pauloalcobia/mcHF_rev_0_8/docs/logic_pcb_mod.jpg

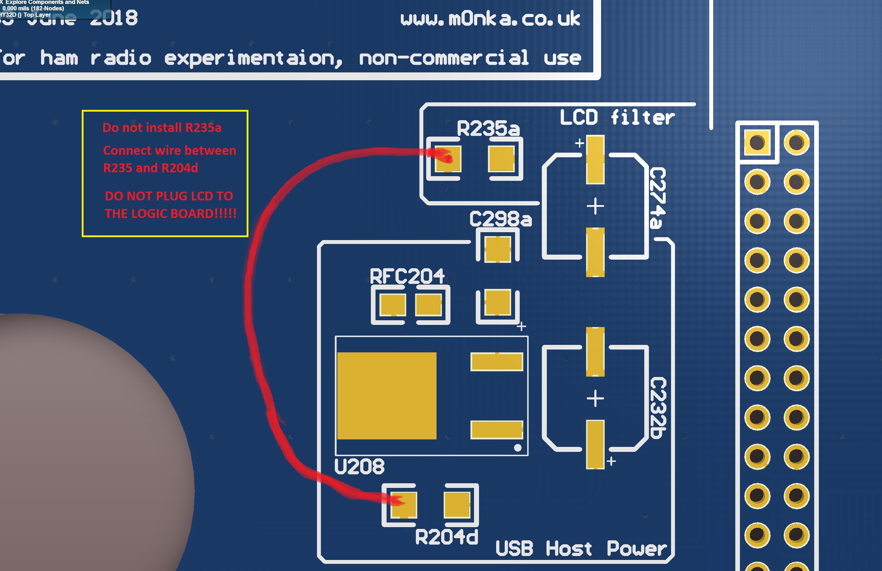
docs/logic_pcb_mod.jpg
