pauloalcobia/mcHF_rev_0_8/pcb/README.md

The 04 June 2018 PCB is second beta revision, so it is still not the final draft. Few things
on the HW side leftover to be tested and finalized, but it is getting closer.

73!
