pauloalcobia/mcHF_rev_0_8/sch/README.md

The 04 June 2018 PCB correspond to schematics from 13 June 2018. Although the
schematics and PCB is marked 0.8, it is basically a replacement UI board for revision
0.7. It is fully electrically and mechanically compatible. The main reason behind this
move is to save on R&D costs. As adding more components and moving to more 
expensive ones at that is getting more and more challenging with our limited budget.

73!
