pauloalcobia/mcHF_rev_0_8/firmware/dsp/README.md

The current firmware in the DSP chip on the Logic board is based on 219.22
release from Clint.
