pauloalcobia/mcHF_rev_0_8/pcb/back.png

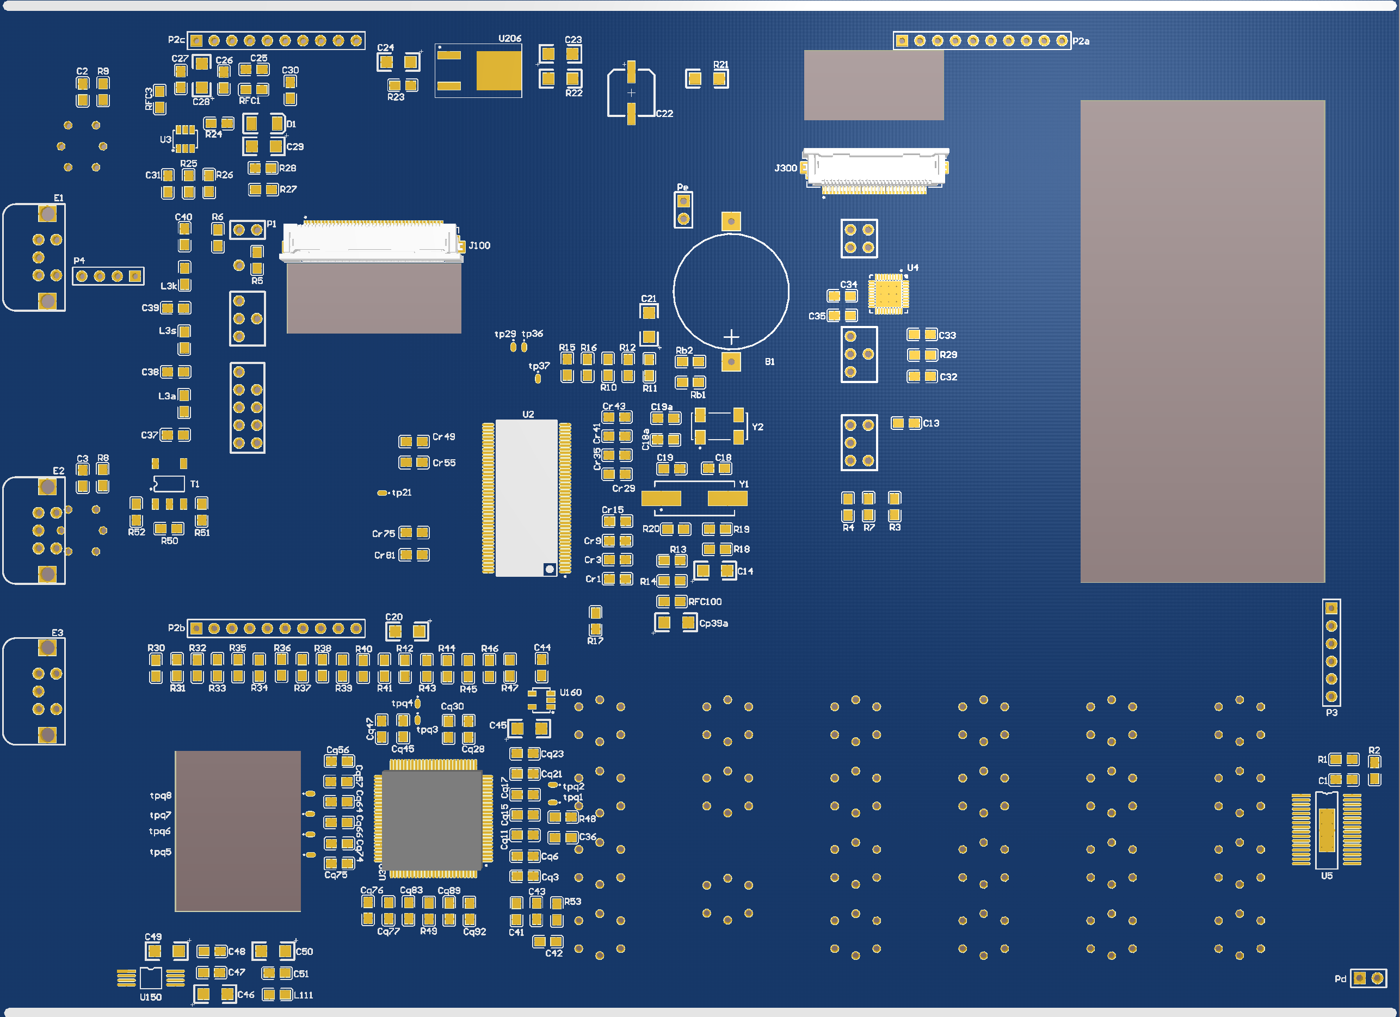
pcb/back.png
