pauloalcobia/mcHF_rev_0_8/pcb/front.png

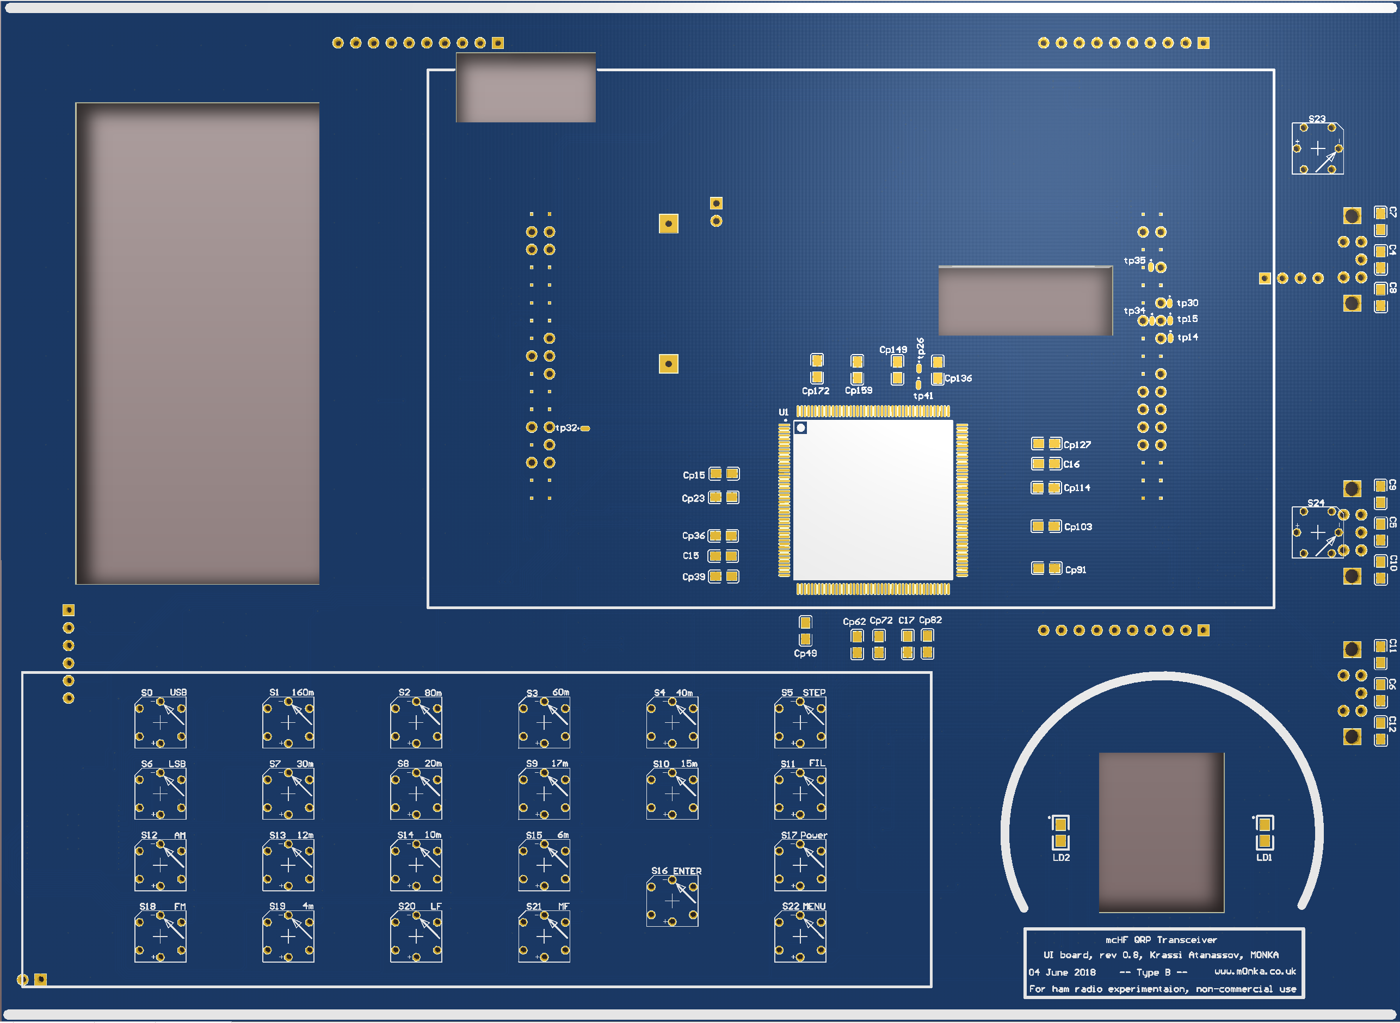
pcb/front.png
