pauloalcobia/mcHF_rev_0_8/sch/mcHFx_ui_b.pdf

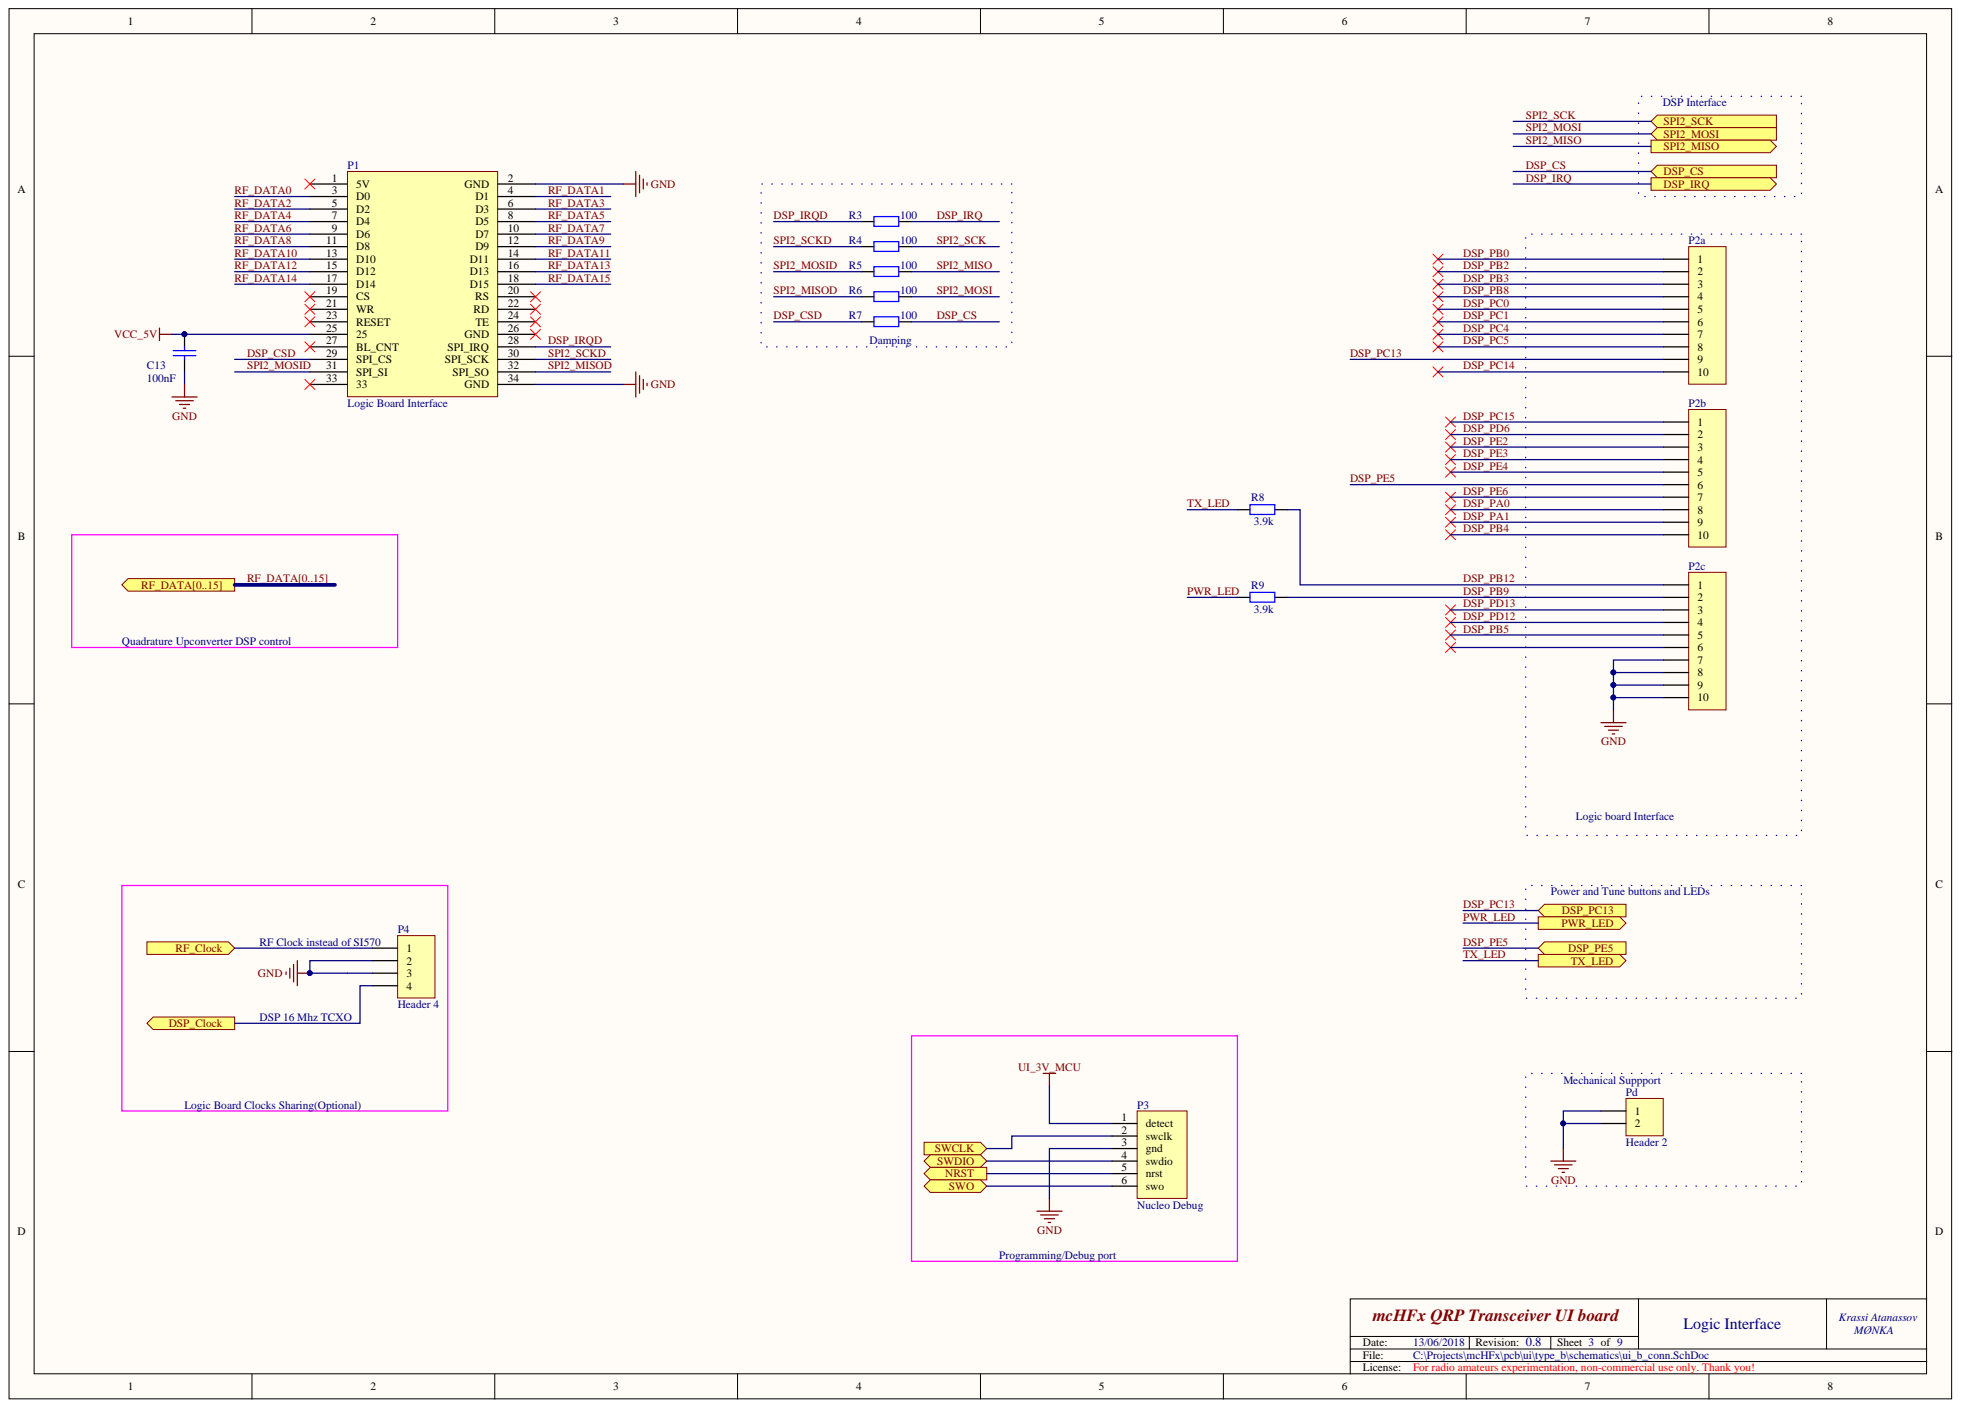
[picture p4: page 1]

Quadrature Upconverter DSP control

Power and Tune buttons and LEDs

RF Clock instead of SI570

Logic Board Clocks Sharing(Optional)

gnd 3

nrst 5

mcHFx QRP Transceiver UI board | Logic Interface | Krassi Atanassov MØNKA

Date: 13/06/2018 | Revision: 0.8 | Sheet of

File:
License: For radio amateurs experimentation, non-commercial use only. Thank you!

C:\Projects\mcHFx\pcb\ui\type_b\schematics\ui_b_conn.SchDoc

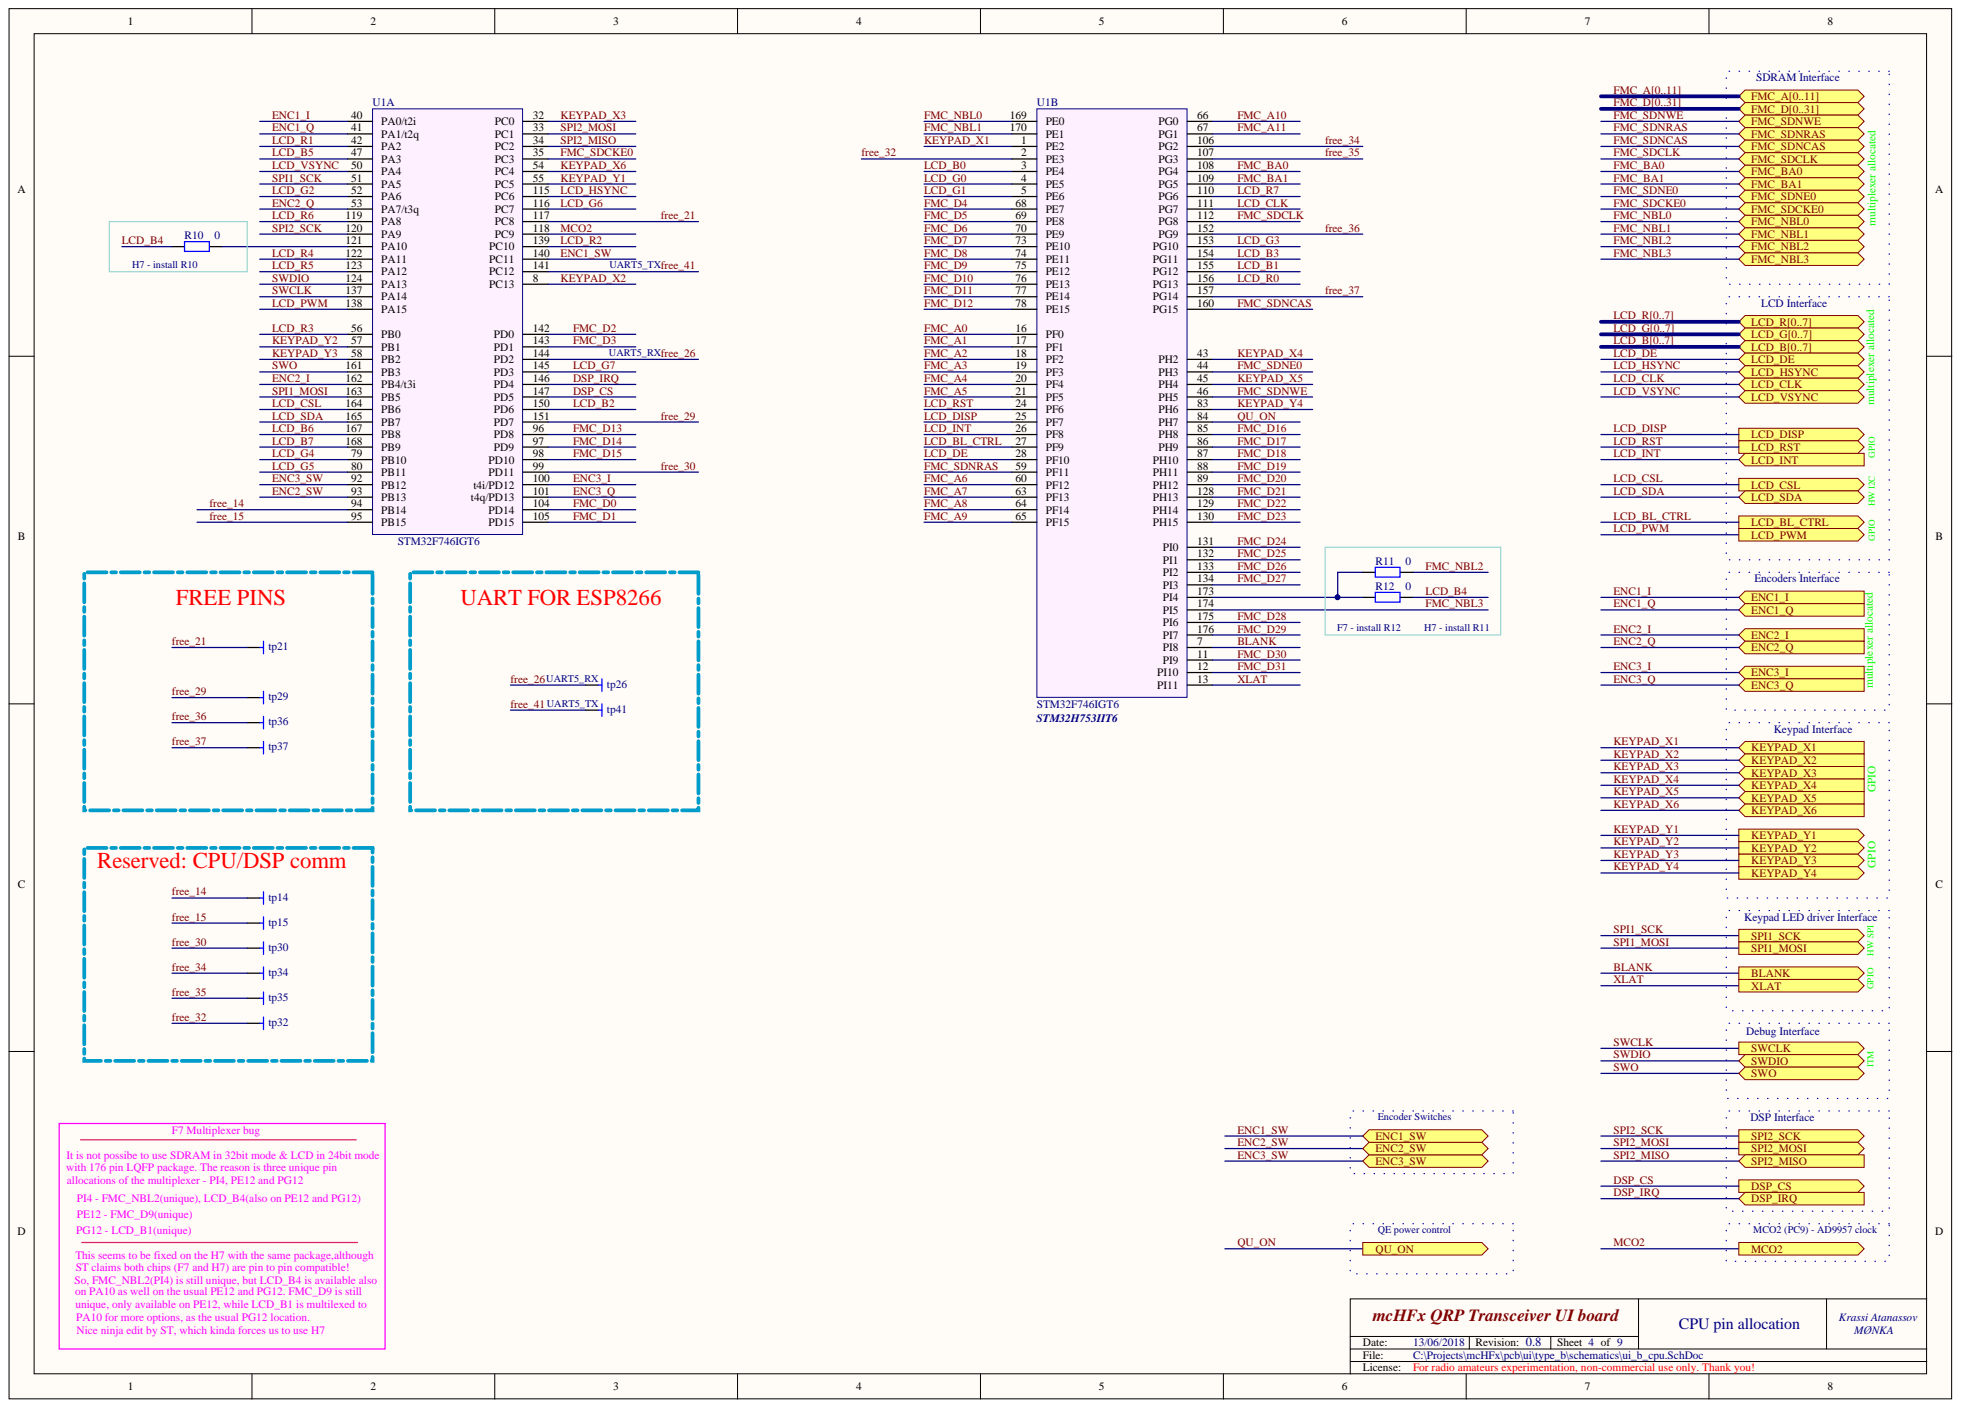
[picture p5: page 2]

multiplexer allocated GPIO multiplexer allocated multiplexer allocated

Reserved: CPU/DSP co

It is not pos
with 176 pin LQFP package. The reason is three unique pin
allocations of the multiplexer - PI4, PE12 and PG12
PI4 - FMC_NBL2(unique), LCD_B4(also on PE12 and PG12)
PE12 - FMC_D9(unique)
PG12 - LCD_B1(unique) This seems to be fixed on the H7 with the same package,although

sibe to use SDRAM in 32bit mode & LCD in 24bit mode

o on PA10 as well on the usual PE12 and PG12. FMC_D9 is still

ST claims both chips (F7 and H7) are pin to pin compatible!
So, FMC_NBL2(PI4) is still unique, but LCD_B4 is available als

unique, only available on PE12, while LCD_B1 is multilexed to
PA10 for more options, as the usual PG12 location.
Nice ninja edit by ST, which kinda forces us to use H7

C:\Projects\mcHFx\pcb\ui\type_b\schematics\ui_b_cpu.SchDoc

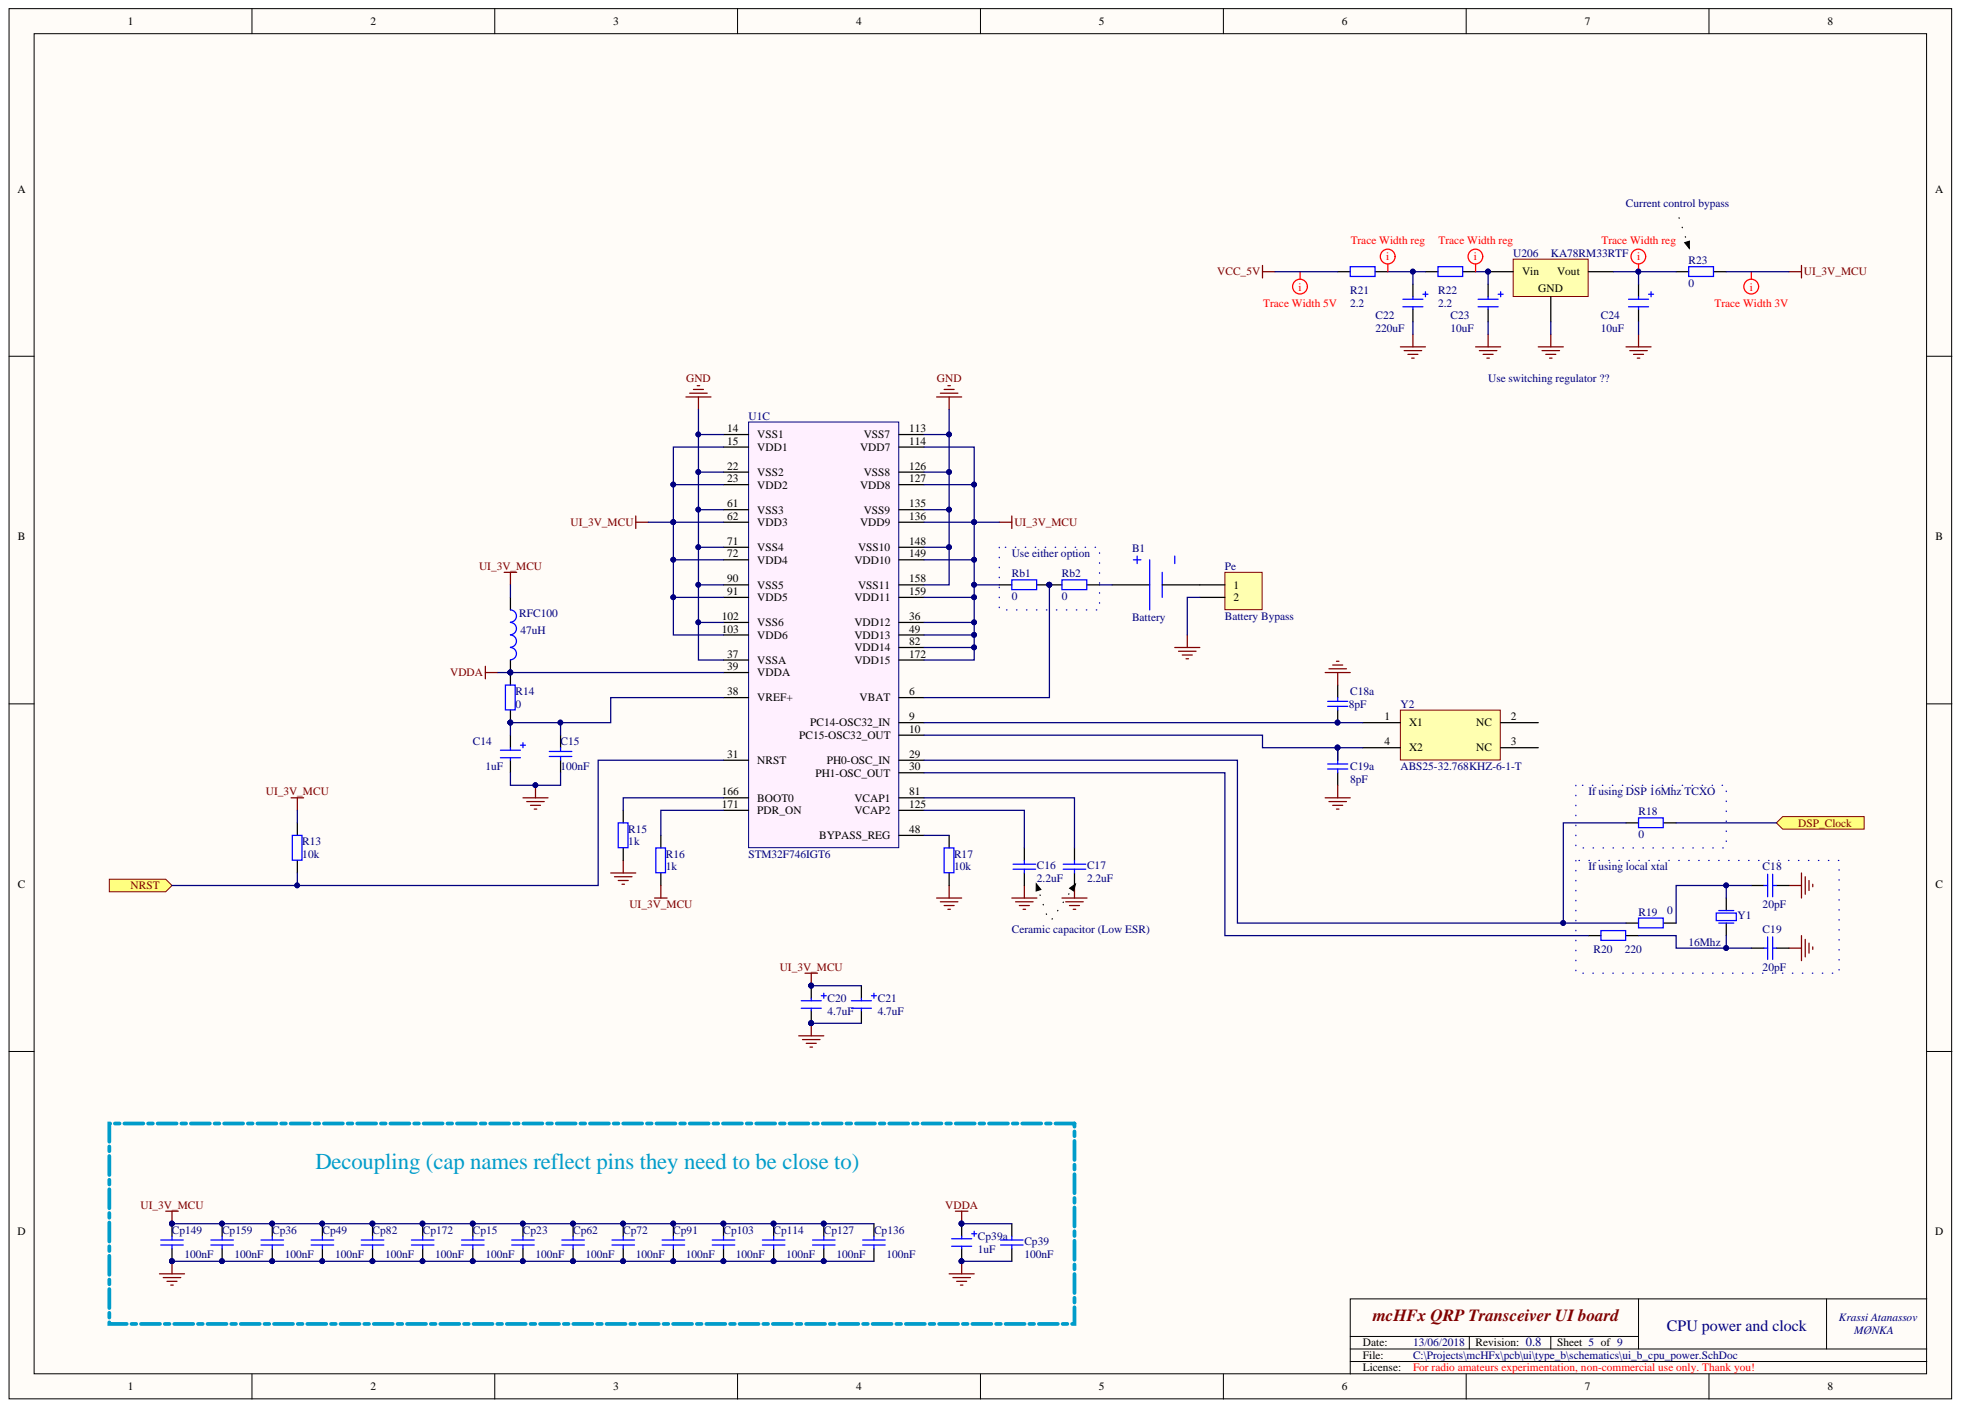
[picture p6: page 3]

VDD1 15

VSS2 22

VSS3 61
VDD3 62

VSS4 71

VSS5 90
VDD5 91 | | 0 | 0

VSS6 102
VDD6 103

VSSA 37

VREF+ 38

BOOT0 166 | C19a ABS25-32.768KHZ-6-1-T

If using DSP 16Mhz TCXO

If using local xtal

Ceramic capacitor (Low ESR)

16Mhz

Decoupling (cap names reflect pins they need to be close to)

CPU power and clock 5

C:\Projects\mcHFx\pcb\ui\type_b\schematics\ui_b_cpu_power.SchDoc

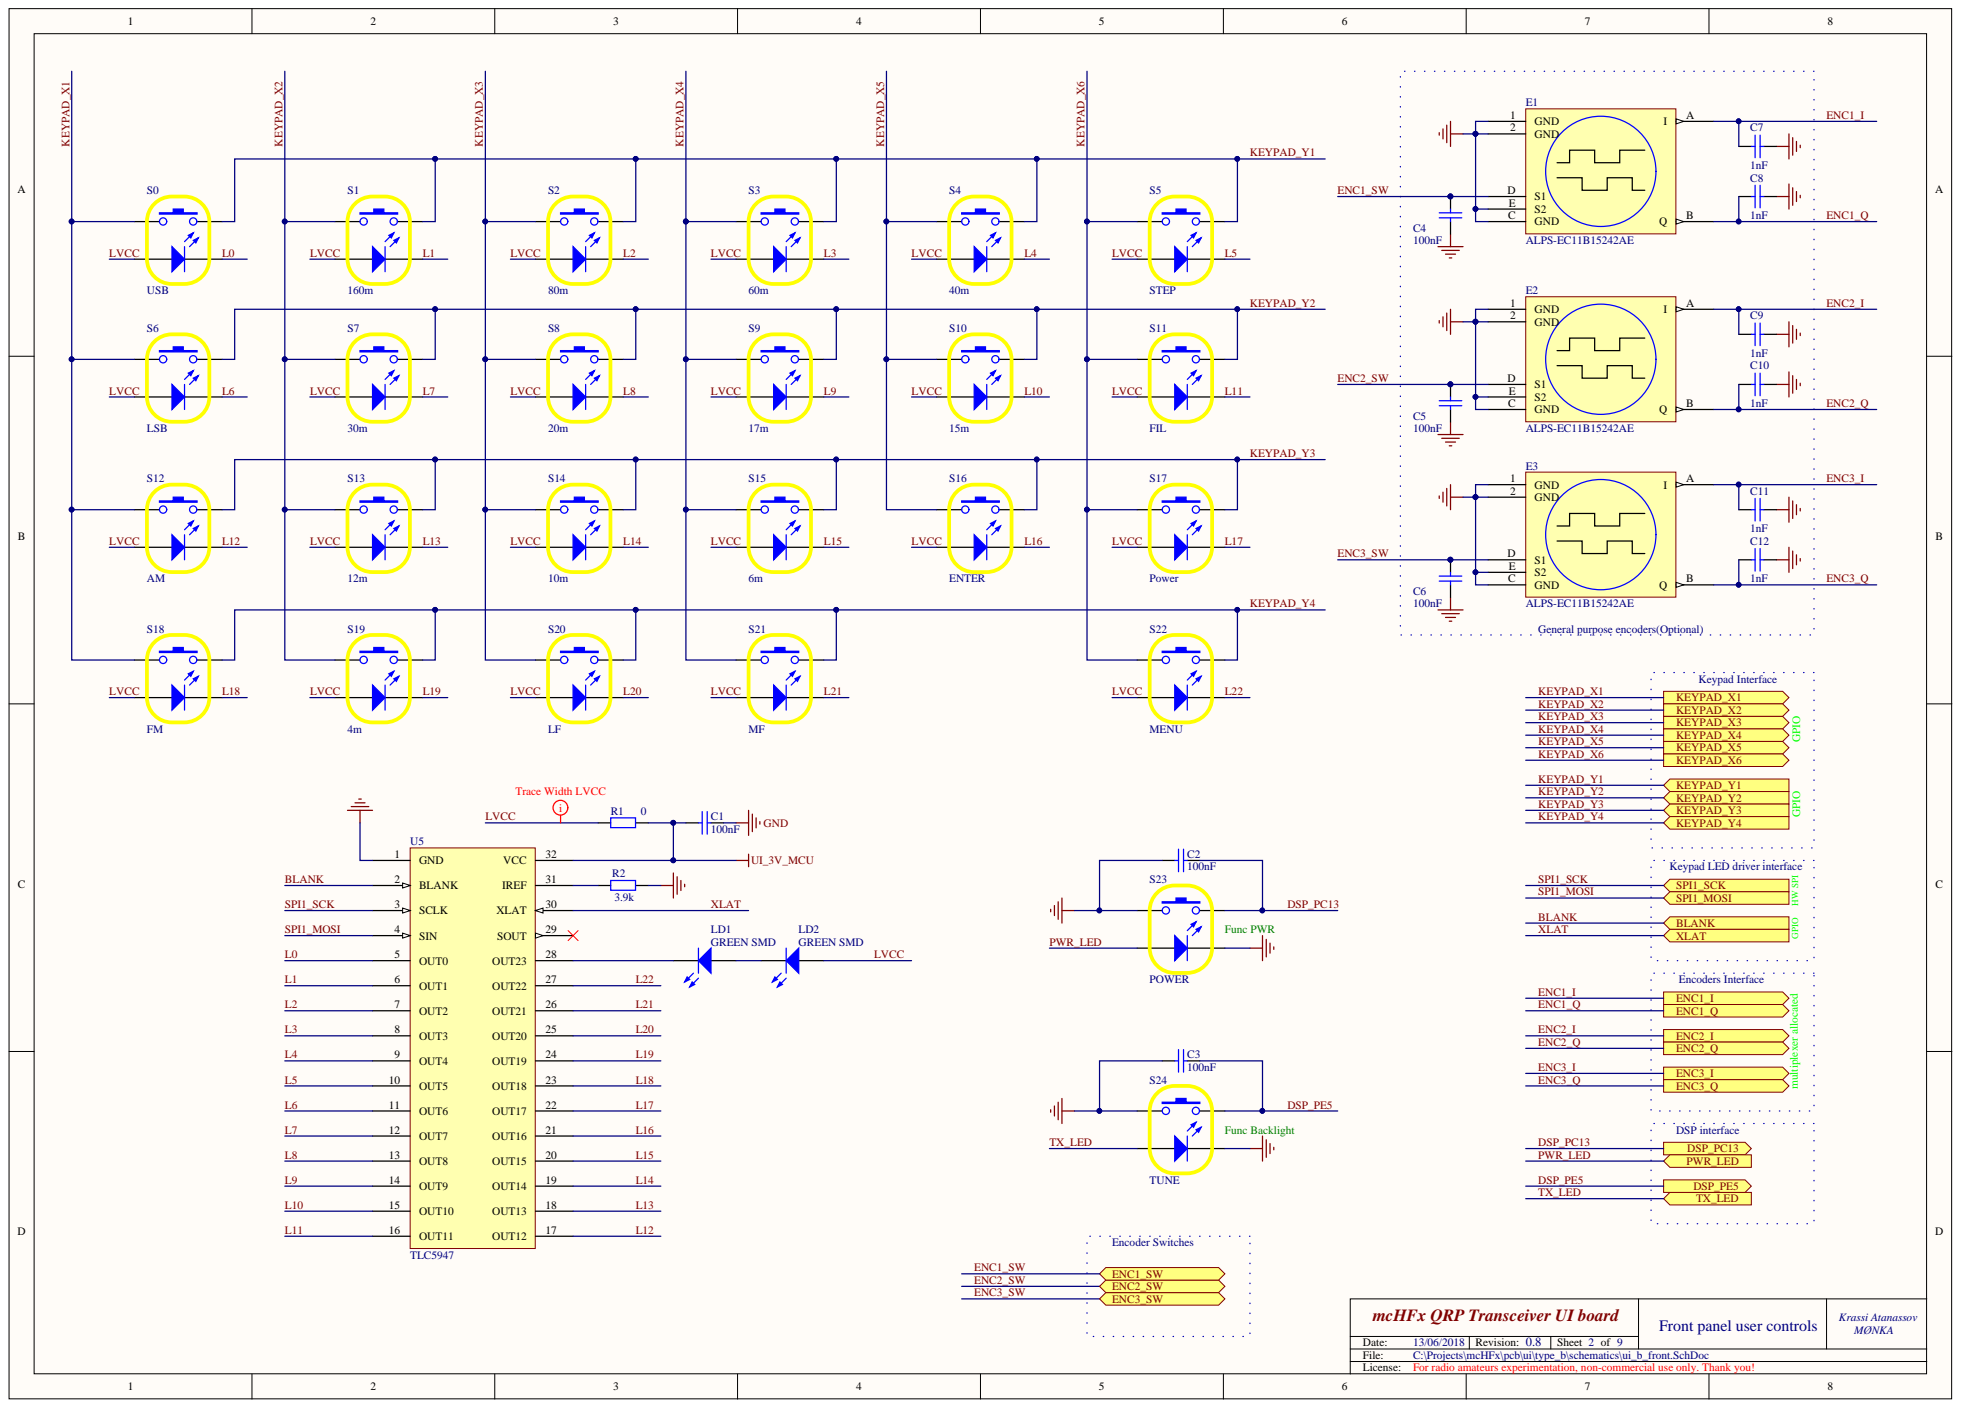
[picture p7: page 4]

General purpose encoders(Optional)

Front panel user controls 2

C:\Projects\mcHFx\pcb\ui\type_b\schematics\ui_b_front.SchDoc

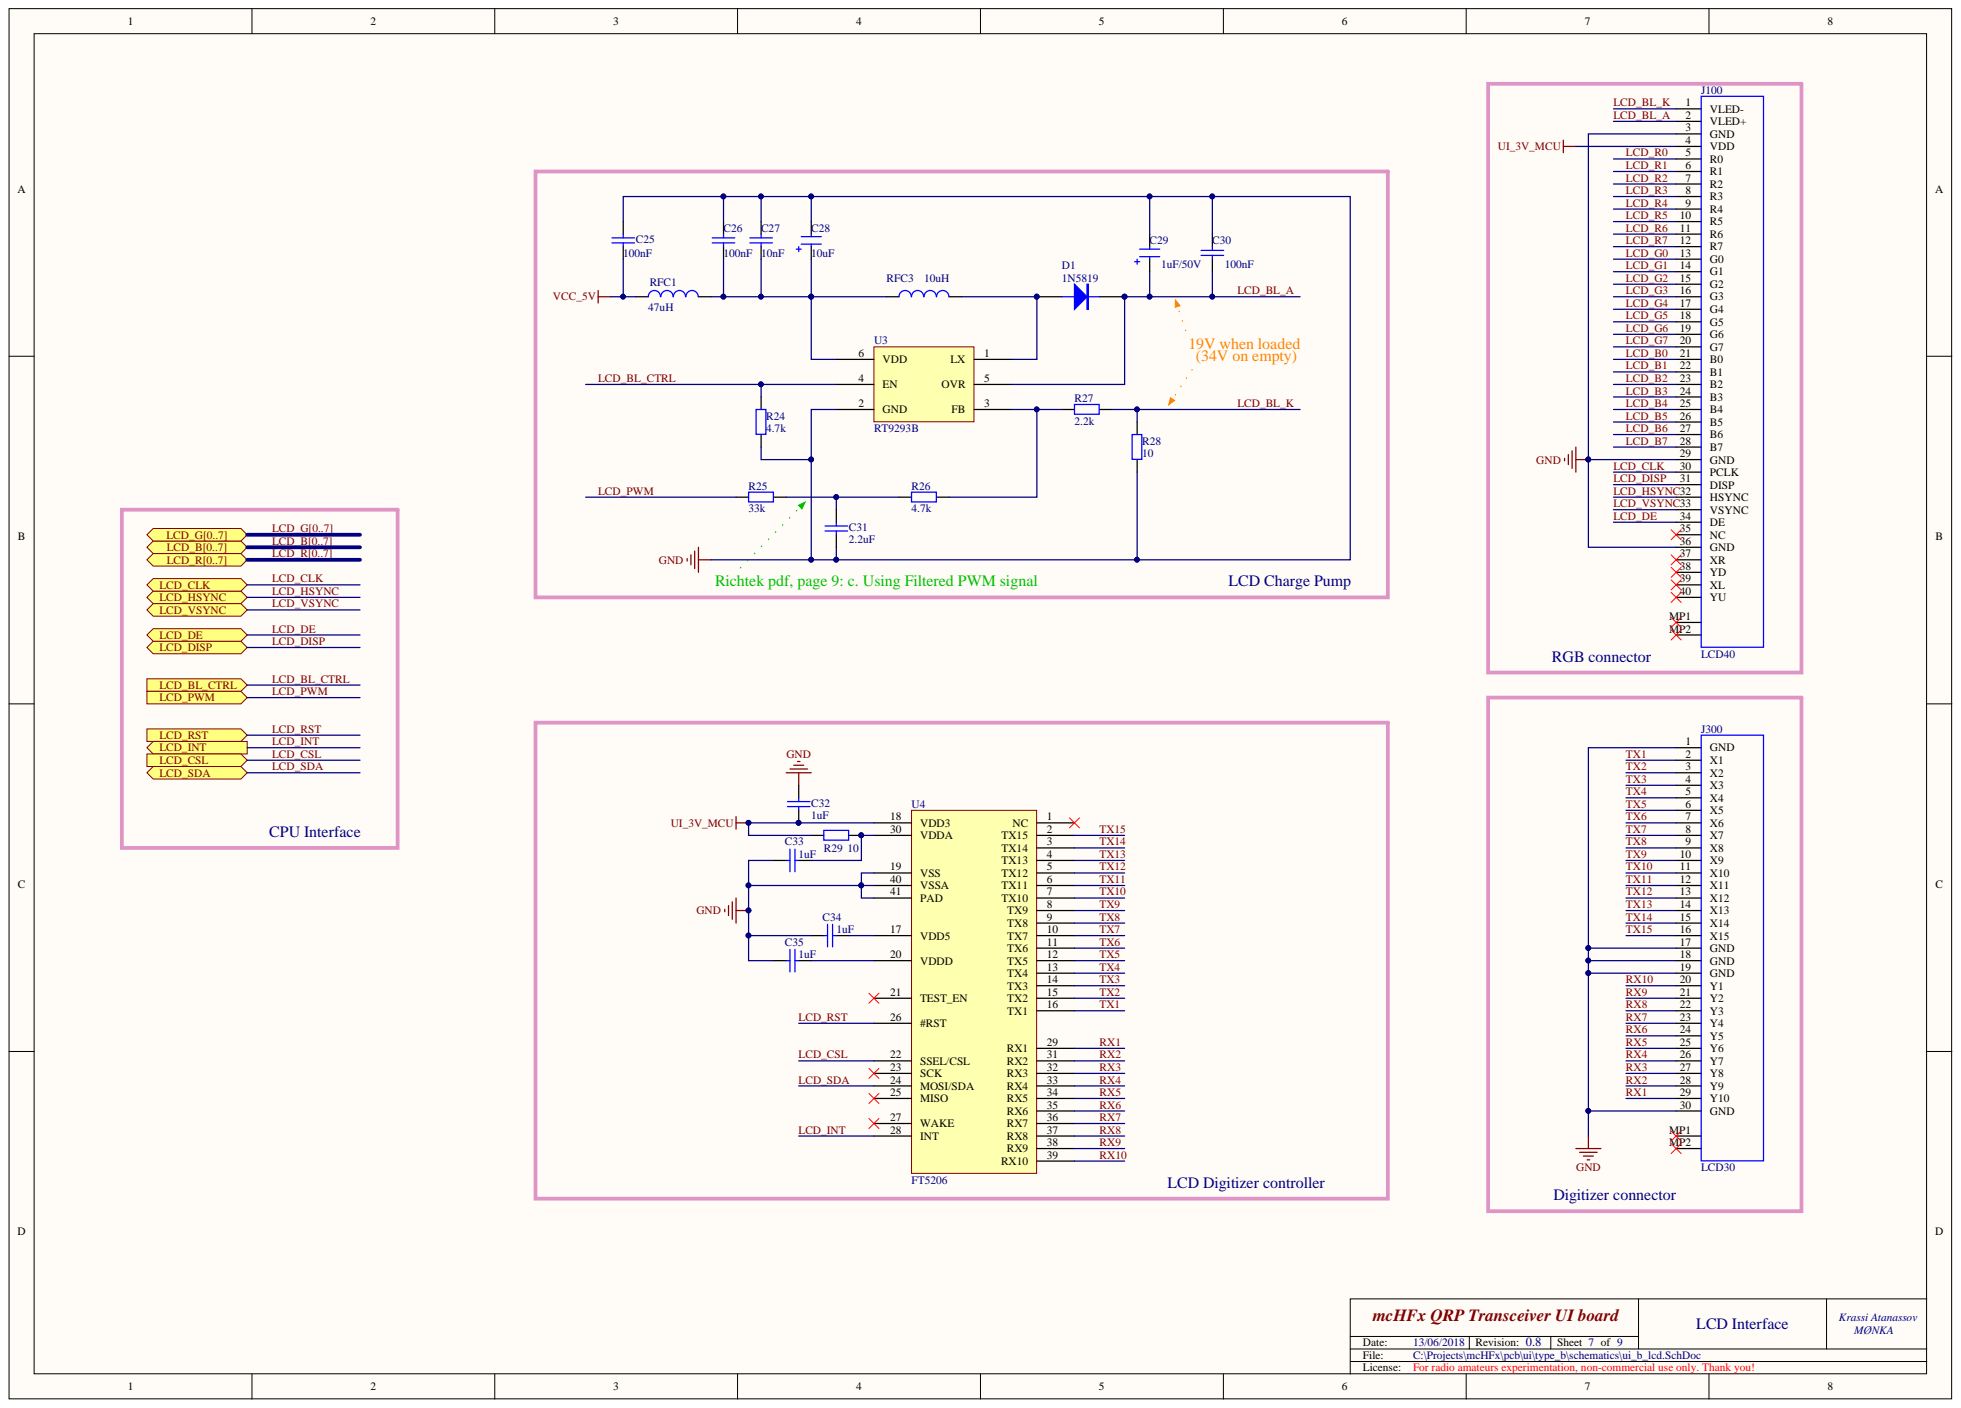
[picture p8: page 5]

LCD_HSYNC LCD_VSYNC LCD_CLK LCD_DE LCD_DISP LCD_B0 LCD_G0 LCD_R0 LCD_R1 LCD_R2 LCD_R3 LCD_R4 LCD_R5 LCD_R6 LCD_R7 LCD_G1 LCD_G2 LCD_G3 LCD_G4 LCD_G5 LCD_G6 LCD_G7 LCD_B1 LCD_B2 LCD_B3 LCD_B4 LCD_B5 LCD_B6 LCD_B7 | 5 6 7 8 9 | R5 10 R6 11 R7 12 G0 13 G1 14 G2 15 G3 16 G4 17 G5 18 G6 19 G7 20 B0 21 B1 22 B2 23 B3 24 B4 25 B5 26 B6 27 B7 28 GND 29

DISP 31 HSYNC 32 VSYNC 33 DE 34 NC 35

Richtek pdf, page 9: c. Using Fi

VDDA 30 | 2
VSS 19 | 3

PAD 41 | TX15 TX14 TX13 TX12 TX11 TX10 TX9 TX8 TX7 TX6 TX5 TX4 TX3 TX2 TX1 7

VSSA 40 | 6

VDD5 17 | 8

C:\Projects\mcHFx\pcb\ui\type_b\schematics\ui_b_lcd.SchDoc

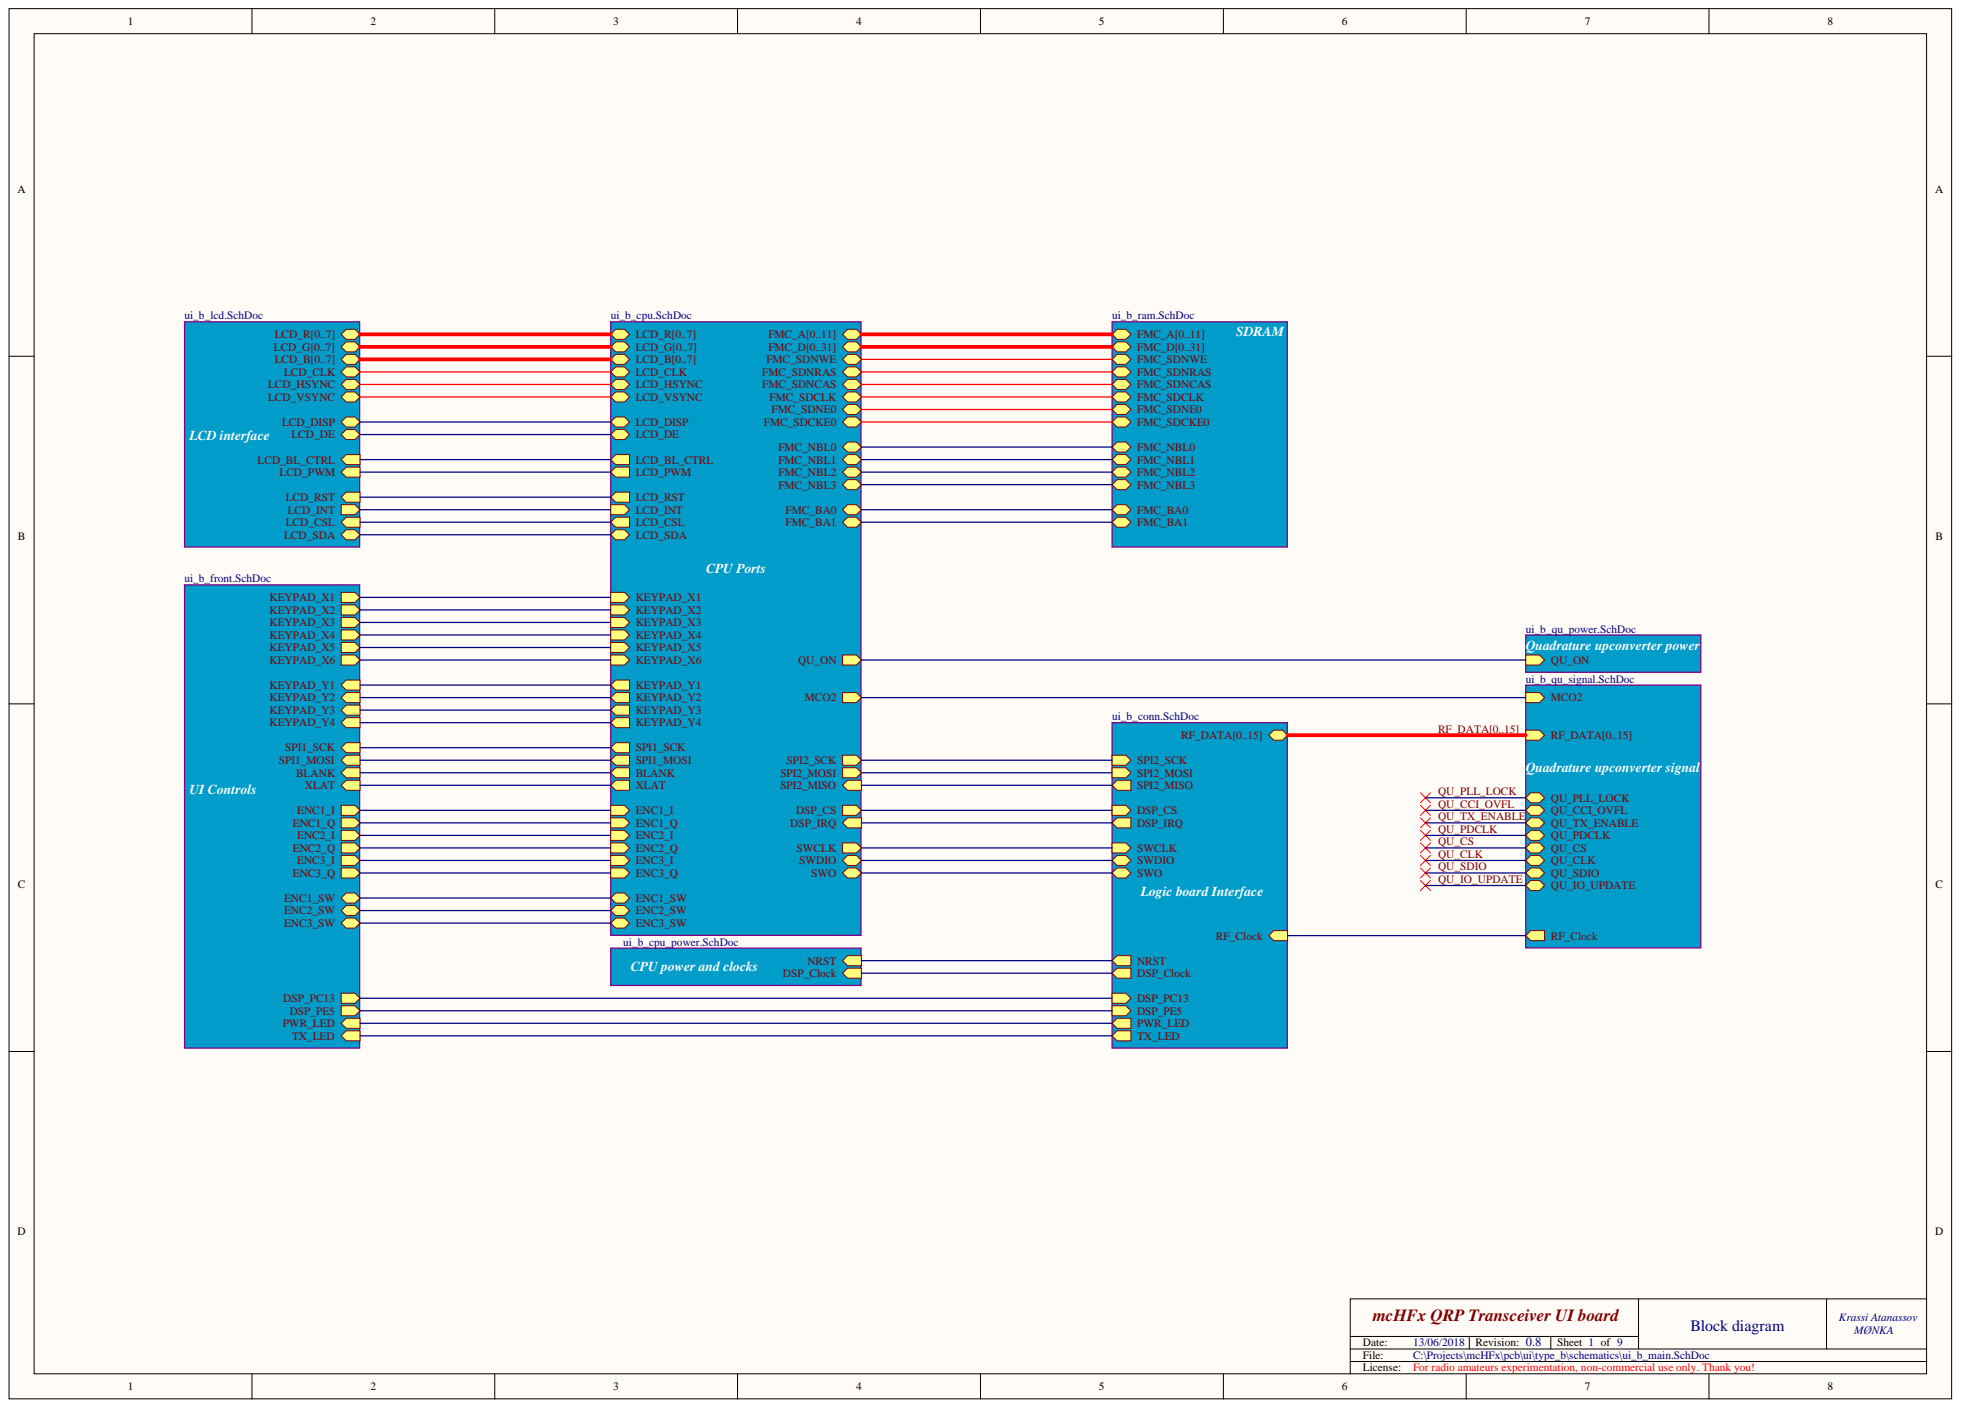
[picture p9: page 6]

DSP_Clock CPU power and clocks

C:\Projects\mcHFx\pcb\ui\type_b\schematics\ui_b_main.SchDoc

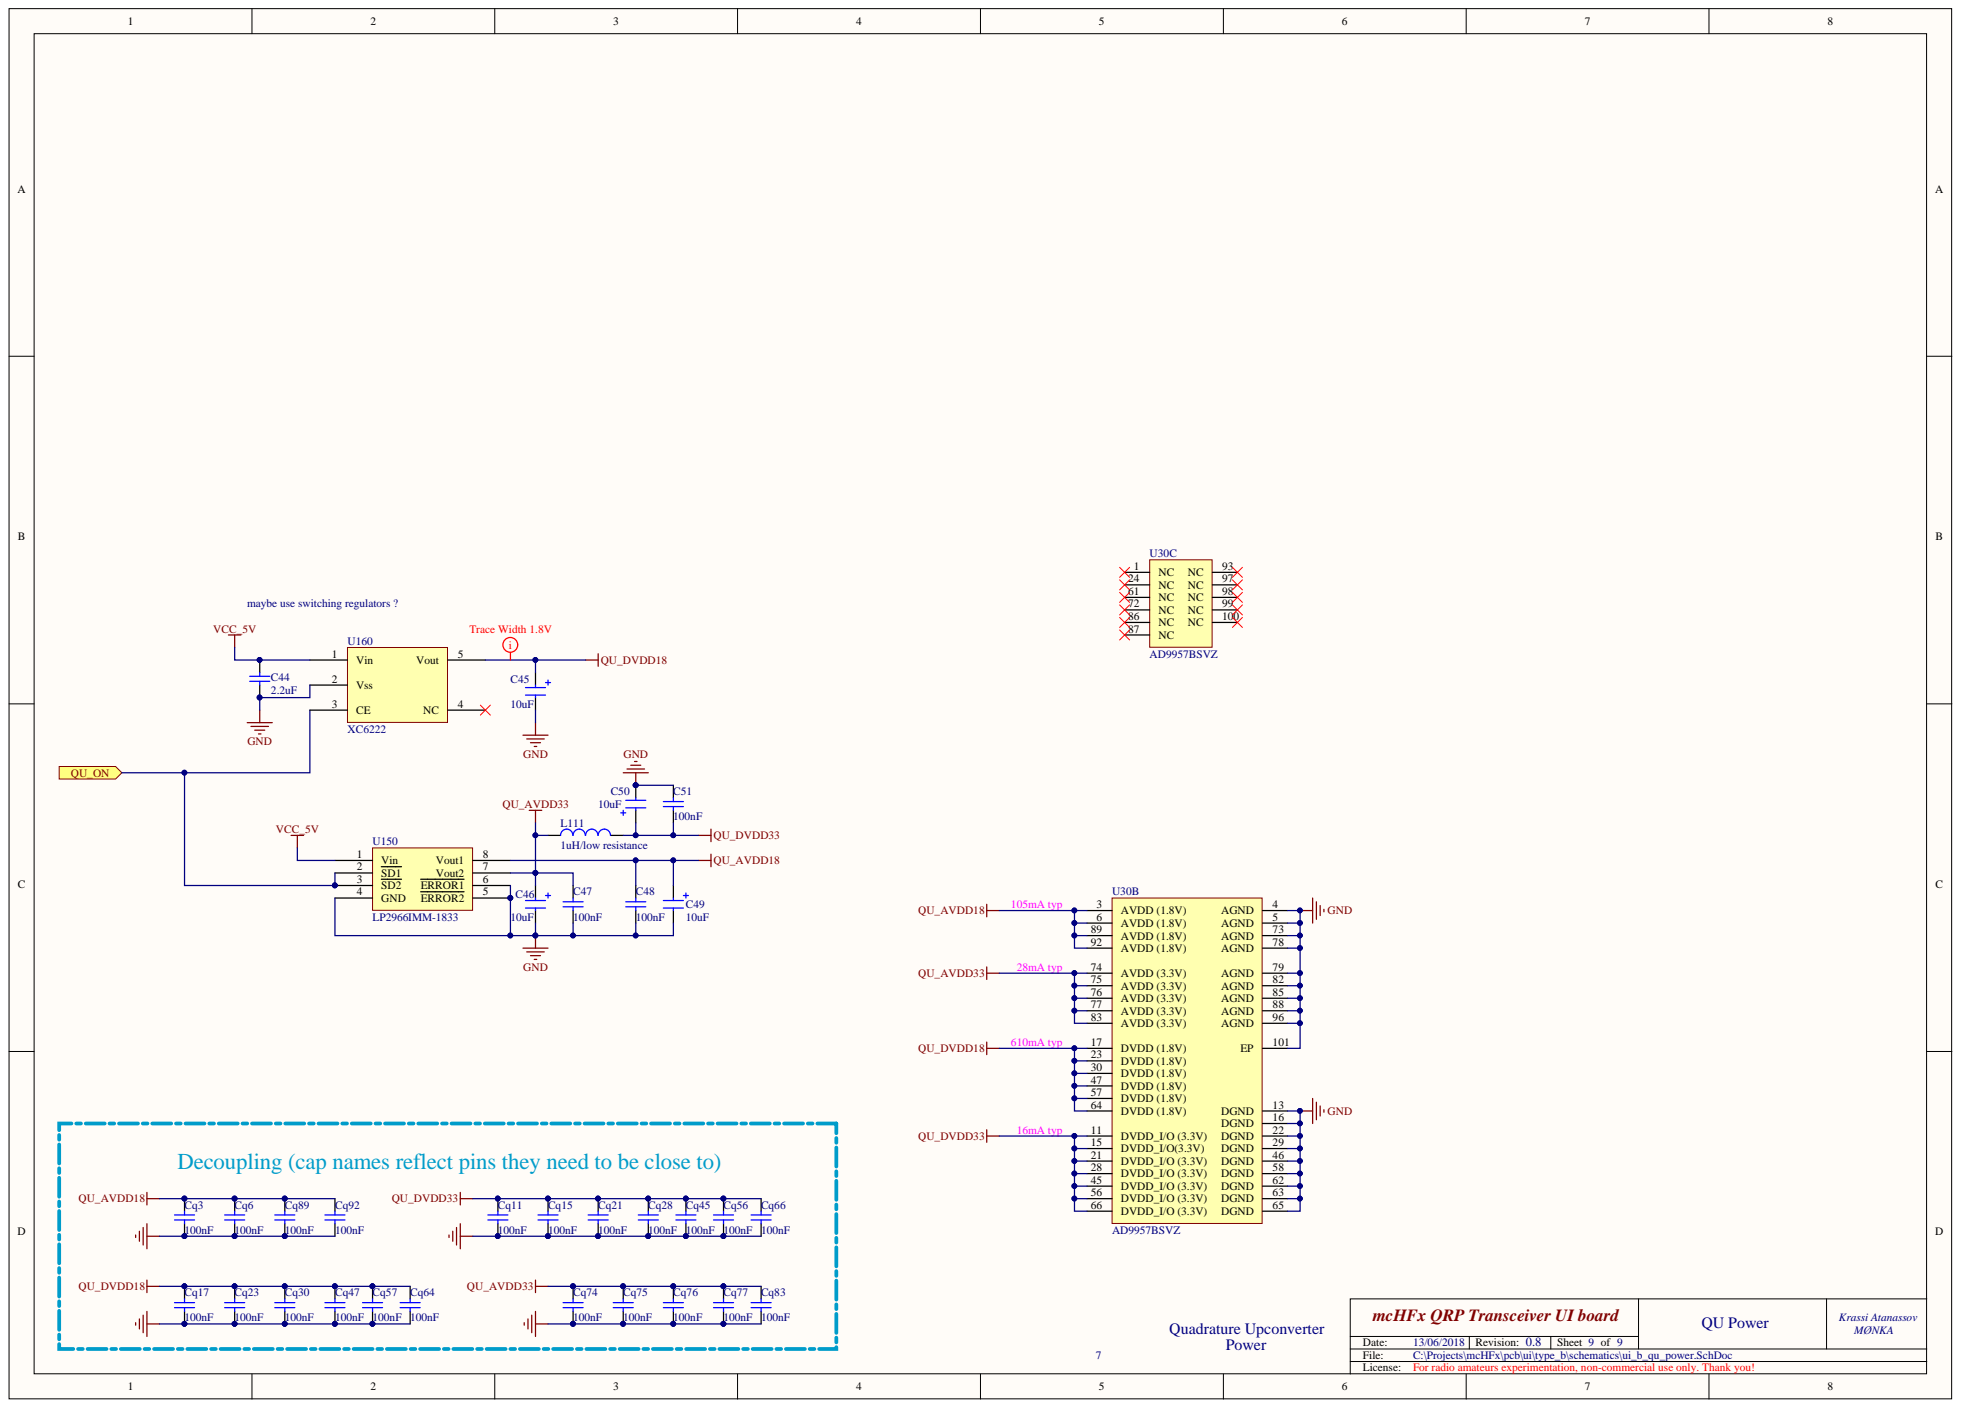
[picture p10: page 7]

maybe use switching regulators ?

Vss 2

Decoupling (cap names reflect pins they need to be close to)

QU Power

C:\Projects\mcHFx\pcb\ui\type_b\schematics\ui_b_qu_power.SchDoc

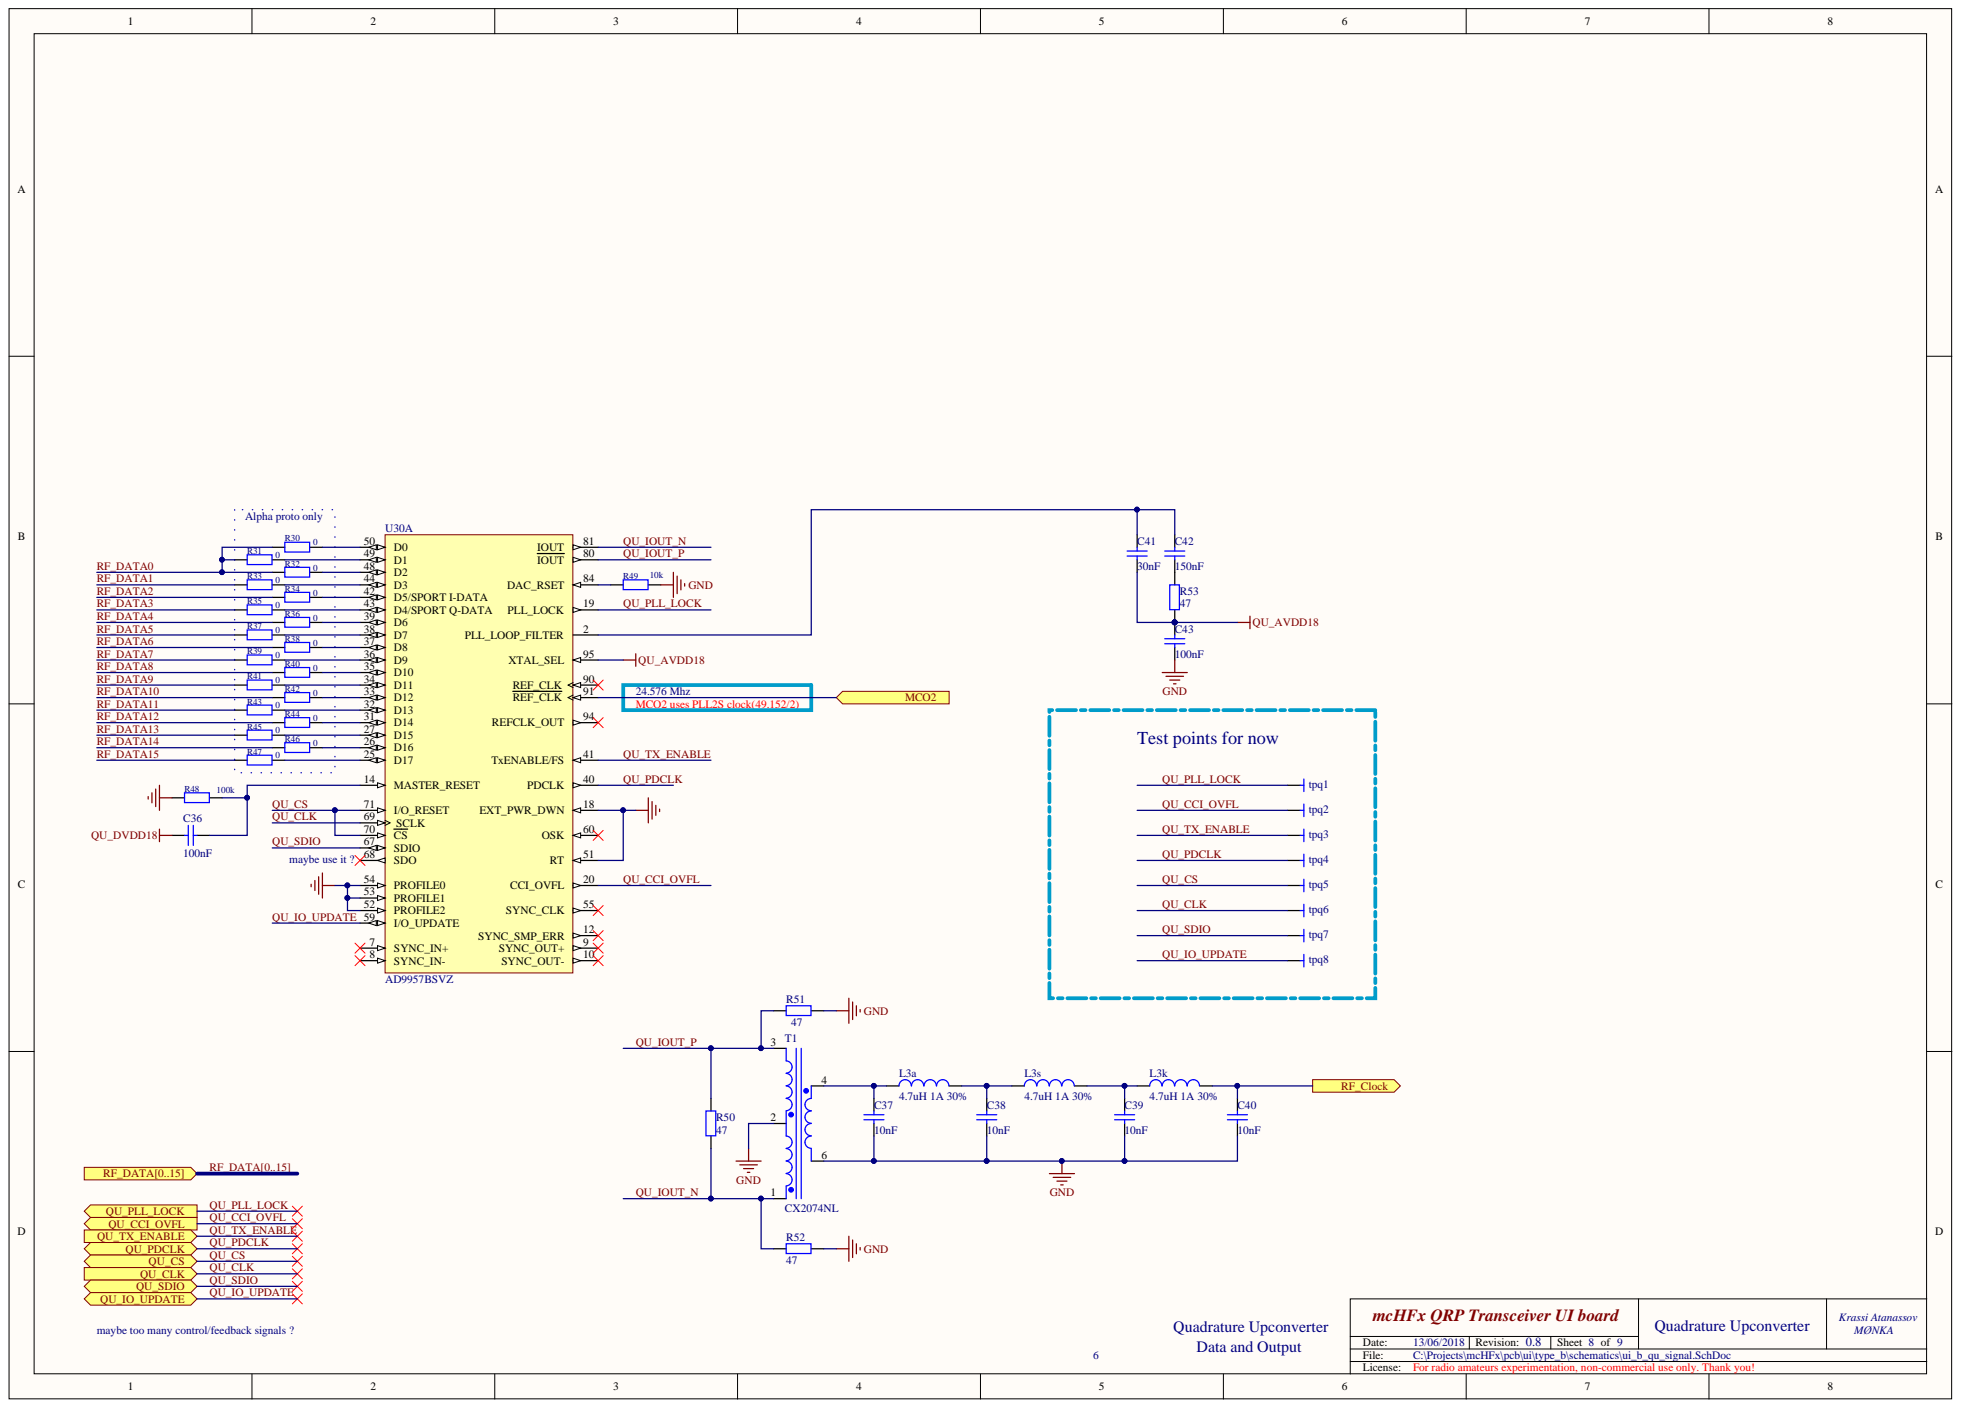
[picture p11: page 8]

Test points for now

MASTER_RESET 14 | QU_PDCLK

I/O_RESET 71 | QU_CCI_OVFL

maybe too many control/feedback signals ?

C:\Projects\mcHFx\pcb\ui\type_b\schematics\ui_b_qu_signal.SchDoc

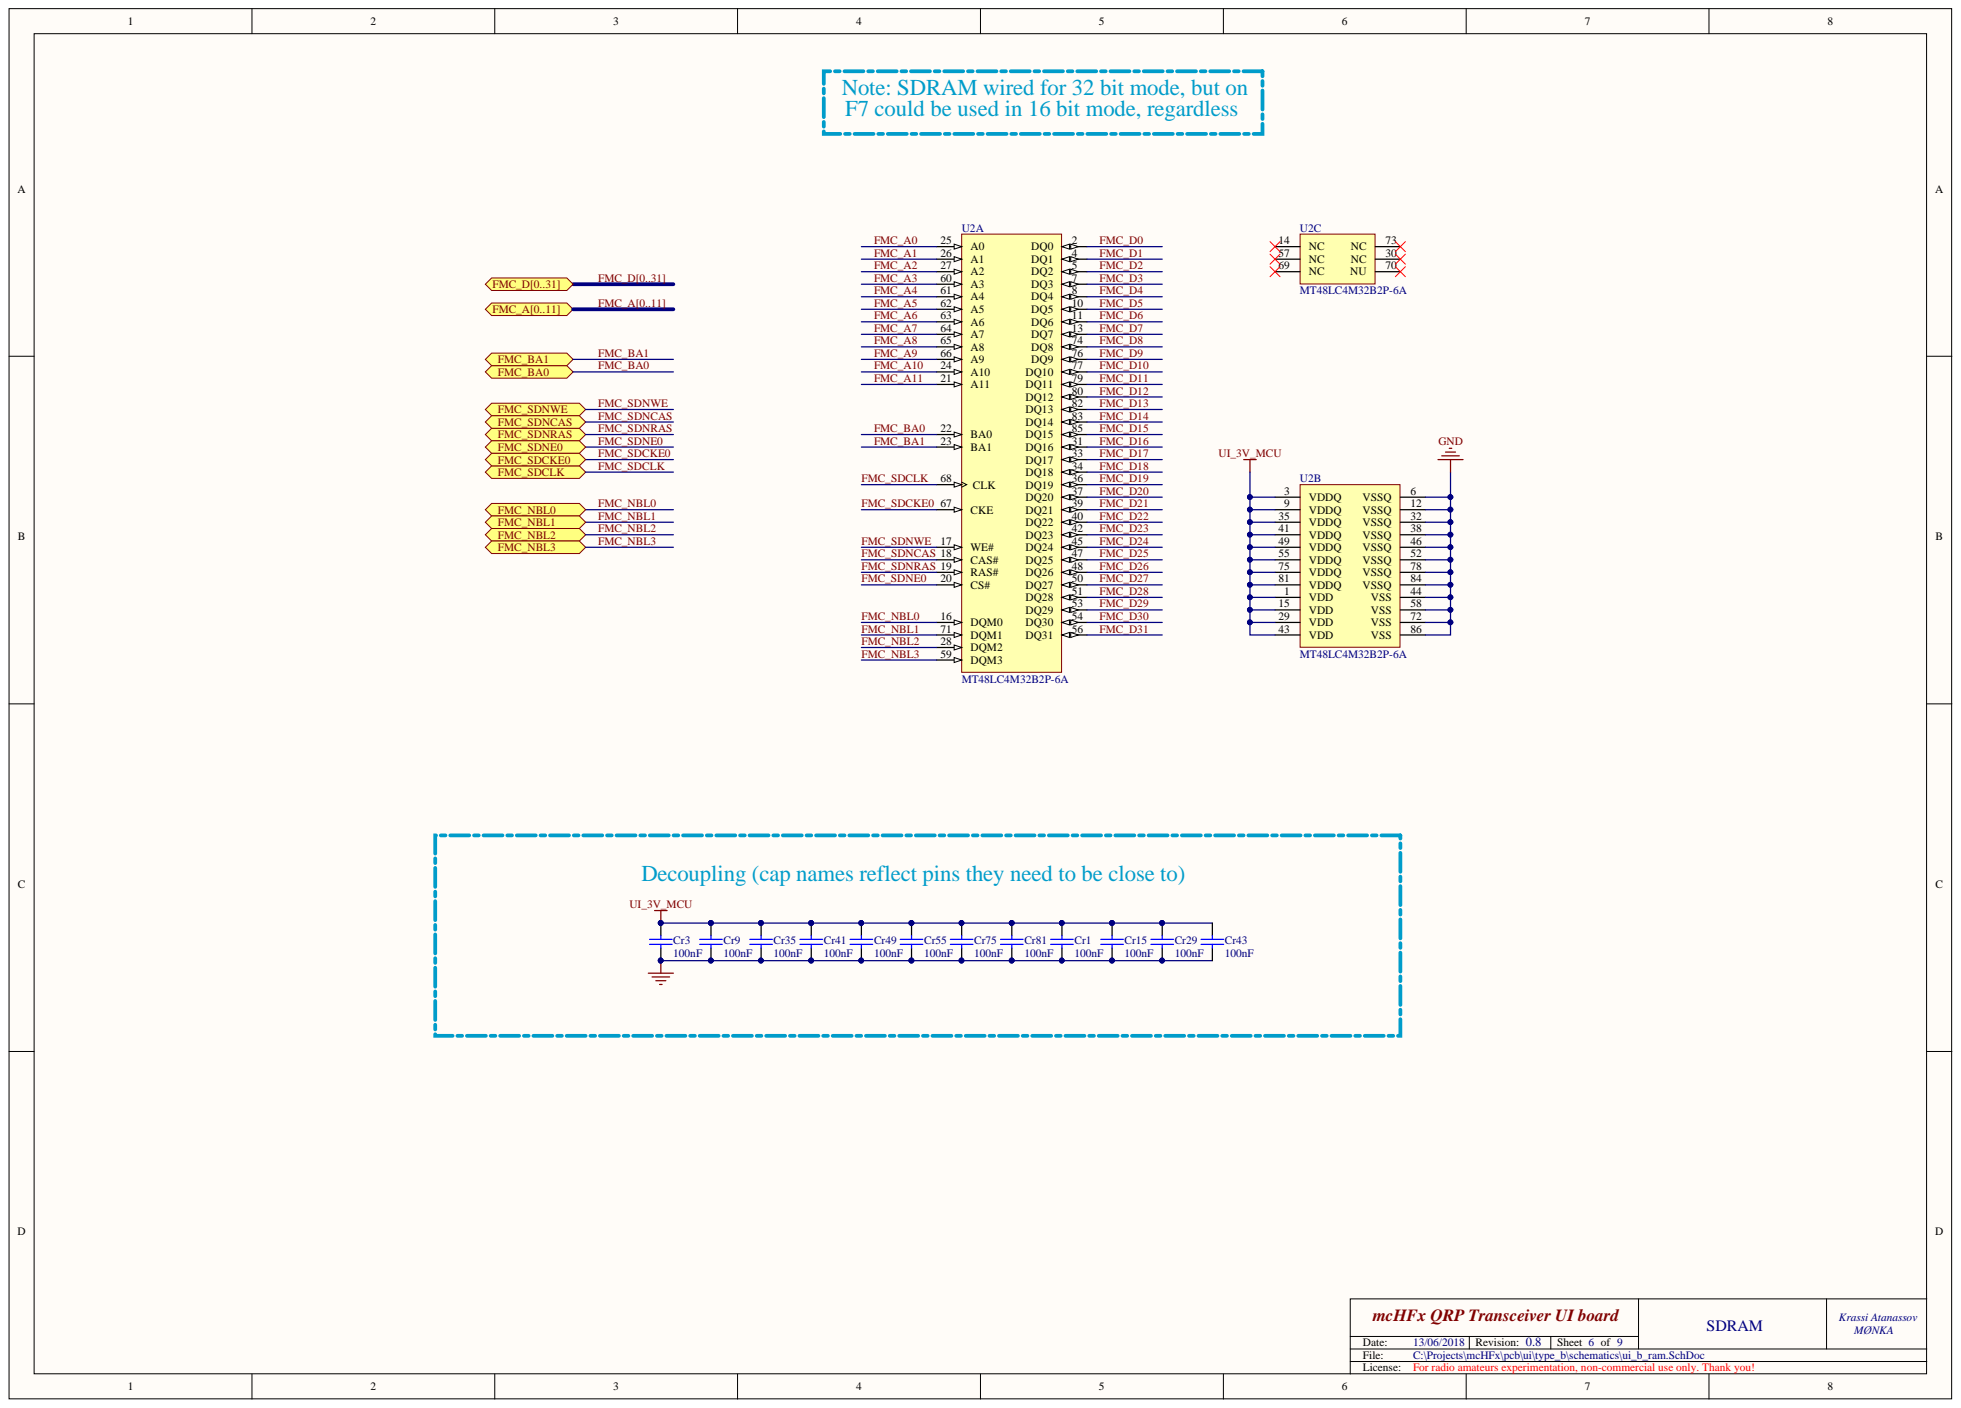
[picture p12: page 9]

Note: SDRAM wired for 32 bit mode, but on F7 could be used in 16 bit mode, regardless

Decoupling (cap names reflect pins they need to be close to)

C:\Projects\mcHFx\pcb\ui\type_b\schematics\ui_b_ram.SchDoc
