pauloalcobia/mcHF_rev_0_8/firmware/dsp/mchf_0_0_219_22_ka7oei_20150908/drivers/ui/ui_driver.c

/************************************************************************************
**                                                                                 **
**                               mcHF QRP Transceiver                              **
**                             K Atanassov - M0NKA 2014                            **
**                                                                                 **
**---------------------------------------------------------------------------------**
**                                                                                 **
**  File name:                                                                     **
**  Description:                                                                   **
**  Last Modified:                                                                 **
**  Licence:		For radio amateurs experimentation, non-commercial use only!   **
************************************************************************************/

// Common
#include "mchf_board.h"

#include <stdio.h>
#include "arm_math.h"
#include "math.h"
#include "codec.h"
#include "ui_menu.h"
#include "waterfall_colours.h"
//
//
// LCD
#include "ui_lcd_hy28.h"

// Encoders
#include "ui_rotary.h"

// SI570 control
#include "ui_si570.h"
#include "ui_soft_tcxo.h"

// Codec control
#include "codec.h"
#include "softdds.h"

#include "audio_driver.h"
#include "hamm_wnd.h"
#include "ui_driver.h"
//#include "usbh_usr.h"

#include "cat_driver.h"

// Virtual eeprom
#include "eeprom.h"

#include "cw_gen.h"

// SSB/AM filters

#include "filters/q_rx_filter_10kHz.h"
#include "filters/i_rx_filter_10kHz.h"
//
#include "filters/q_rx_filter_7kHz5.h"
#include "filters/i_rx_filter_7kHz5.h"
//
#include "filters/q_rx_filter_6kHz.h"
#include "filters/i_rx_filter_6kHz.h"
//
#include "filters/q_rx_filter_5kHz.h"
#include "filters/i_rx_filter_5kHz.h"
//
#include "filters/q_rx_filter_3k6.h"
#include "filters/i_rx_filter_3k6.h"
//
#include "filters/q_tx_filter.h"
#include "filters/i_tx_filter.h"

#include "filters/iq_rx_filter_am_10kHz.h"
#include "filters/iq_rx_filter_am_7kHz5.h"
#include "filters/iq_rx_filter_am_6kHz.h"
#include "filters/iq_rx_filter_am_5kHz.h"
#include "filters/iq_rx_filter_am_3k6.h"
#include "filters/iq_rx_filter_am_2k3.h"

static void 	UiDriverPublicsInit(void);
static void 	UiDriverProcessKeyboard(void);
static void 	UiDriverPressHoldStep(uchar is_up);
static void 	UiDriverProcessFunctionKeyClick(ulong id);

//static void 	UiDriverShowMode(void);
//static void 	UiDriverShowStep(ulong step);
static void 	UiDriverShowBand(uchar band);
//static void 	UiDriverChangeBandFilter(uchar band,uchar bpf_only);
static void 	UiDriverCreateDesktop(void);
static void 	UiDriverCreateFunctionButtons(bool full_repaint);
//static void 	UiDriverCreateSpectrumScope(void);
//static void 	UiDriverCreateDigiPanel(void);
//
static void UiDriverDeleteSMeter(void);
static void 	UiDriverCreateSMeter(void);
static void 	UiDriverDrawWhiteSMeter(void);
static void 	UiDriverDrawRedSMeter(void);
//
static void 	UiDriverUpdateTopMeterA(uchar val,uchar old);
static void 	UiDriverUpdateBtmMeter(uchar val, uchar warn);

static void 	UiDriverInitFrequency(void);
//
static void 	UiDriverCheckFilter(ulong freq);
uchar 			UiDriverCheckBand(ulong freq, ushort update);
//static void 	UiDriverUpdateFrequency(char skip_encoder_check, uchar mode);
//static void 	UiDriverUpdateFrequencyFast(void);
static void 	UiDriverUpdateLcdFreq(ulong dial_freq,ushort color,ushort mode);
static void 	UiDriverUpdateSecondLcdFreq(ulong dial_freq);
//static void 	UiDriverChangeTuningStep(uchar is_up);
static uchar 	UiDriverButtonCheck(ulong button_num);
static void		UiDriverTimeScheduler(void);				// Also handles audio gain and switching of audio on return from TX back to RX
static void 	UiDriverChangeDemodMode(uchar noskip);
static void 	UiDriverChangeBand(uchar is_up);
static void 	UiDriverChangeBandA(void);
static bool 	UiDriverCheckFrequencyEncoder(void);
static void 	UiDriverCheckEncoderOne(void);
static void 	UiDriverCheckEncoderTwo(void);
static void 	UiDriverCheckEncoderThree(void);
static void 	UiDriverChangeEncoderOneMode(uchar skip);
static void 	UiDriverChangeEncoderTwoMode(uchar skip);
static void 	UiDriverChangeEncoderThreeMode(uchar skip);
// encoder one
static void 	UiDriverChangeAfGain(uchar enabled);
//static void 	UiDriverChangeStGain(uchar enabled);
//static void 	UiDriverChangeKeyerSpeed(uchar enabled);
// encoder two
//static void 	UiDriverChangeRfGain(uchar enabled);
static void 	UiDriverChangeSigProc(uchar enabled);
// encoder three
static void 	UiDriverChangeRit(uchar enabled);
//static void 	UiDriverChangeFilter(uchar ui_only_update);
static void 	UiDriverProcessActiveFilterScan(void);
static void 	UiDriverChangeDSPMode(void);
static void 	UiDriverChangePowerLevel(void);
//static void 	UiDrawSpectrumScopeFrequencyBarText(void);
static void 	UiDriverFFTWindowFunction(char mode);
static void 	UiInitSpectrumScopeWaterfall();			// init spectrum scope FFT variables, clear screen, start up all-in-one
static void 	UiDriverInitSpectrumDisplay(void);
//static void 	UiDriverClearSpectrumDisplay(void);

static void 	UiDriverReDrawSpectrumDisplay(void);

#ifndef DSP_MODE
static void 	UiDriverReDrawWaterfallDisplay(void);
static void 	UiDriverLoadEepromValues(void);
#endif

static ulong 	UiDriverGetScopeTraceColour(void);
//static void 	UiDriverUpdateEthernetStatus(void);
//static void 	UiDriverUpdateUsbKeyboardStatus(void);
static void 	UiDriverHandleSmeter(void);
static void 	UiDriverHandleLowerMeter(void);
static void 	UiDriverHandlePowerSupply(void);
// LO TCXO routines
static void 	UiDriverUpdateLoMeter(uchar val,uchar active);
void 	UiDriverCreateTemperatureDisplay(uchar enabled,uchar create);
static void 	UiDriverRefreshTemperatureDisplay(uchar enabled,int temp);
static void 	UiDriverHandleLoTemperature(void);
//static void 	UiDriverEditMode(void);
static void 	UiDriverSwitchOffPtt(void);
//static void 	UiDriverSetBandPowerFactor(uchar band);
//
//static void		UiCalcTxIqGainAdj(void);
void			UiDriverUpdateMenu(uchar mode);
void 			UiDriverUpdateMenuLines(uchar index, uchar mode);
void			UiDriverUpdateConfigMenuLines(uchar index, uchar mode);
void 			UiDriverSaveEepromValuesPowerDown(void);
static void UiDriverInitMainFreqDisplay(void);
//

// Tuning steps
const ulong tune_steps[T_STEP_MAX_STEPS] = {
T_STEP_1HZ,
T_STEP_10HZ,
T_STEP_100HZ,
T_STEP_1KHZ,
T_STEP_10KHZ,
T_STEP_100KHZ,
T_STEP_1MHZ,
T_STEP_10MHZ
};


//
// Band definitions - band base frequency value
const ulong tune_bands[MAX_BANDS] = { BAND_FREQ_80,
									  BAND_FREQ_60,
									  BAND_FREQ_40,
									  BAND_FREQ_30,
									  BAND_FREQ_20,
									  BAND_FREQ_17,
									  BAND_FREQ_15,
									  BAND_FREQ_12,
									  BAND_FREQ_10};//,
//									  BAND_FREQ_GEN};

// Band definitions - band frequency size
const ulong size_bands[MAX_BANDS] = { BAND_SIZE_80,
									  BAND_SIZE_60,
									  BAND_SIZE_40,
									  BAND_SIZE_30,
									  BAND_SIZE_20,
									  BAND_SIZE_17,
									  BAND_SIZE_15,
									  BAND_SIZE_12,
									  BAND_SIZE_10};//,
//									  BAND_SIZE_GEN};

// -------------------------------------------------------
// Constant declaration of the buttons map across ports
// - update if moving buttons around !!!
const ButtonMap	bm[16] =
{
		{BUTTON_M2_PIO,		BUTTON_M2},		// 0
		{BUTTON_G2_PIO,		BUTTON_G2},		// 1
		{BUTTON_G3_PIO,		BUTTON_G3},		// 2
		{BUTTON_BNDM_PIO,	BUTTON_BNDM},	// 3
		{BUTTON_G4_PIO,		BUTTON_G4},		// 4
		{BUTTON_M3_PIO,		BUTTON_M3},		// 5
		{BUTTON_STEPM_PIO,	BUTTON_STEPM},	// 6
		{BUTTON_STEPP_PIO,	BUTTON_STEPP},	// 7
		{BUTTON_M1_PIO,		BUTTON_M1},		// 8
		{BUTTON_F3_PIO,		BUTTON_F3},		// 9
		{BUTTON_F1_PIO,		BUTTON_F1},		// 10
		{BUTTON_F2_PIO,		BUTTON_F2},		// 11
		{BUTTON_F4_PIO,		BUTTON_F4},		// 12
		{BUTTON_BNDP_PIO,	BUTTON_BNDP},	// 13
		{BUTTON_F5_PIO,		BUTTON_F5},		// 14
		{BUTTON_G1_PIO,		BUTTON_G1}		// 15
};


// The following are calibrations for the S-meter based on 6 dB per S-unit, 10 dB per 10 dB mark above S-9
// The numbers within are linear gain values, not logarithmic, starting with a zero signal level of 1
// There are 33 entries, one corresponding with each point on the S-meter
#define	S_Meter_Cal_Size	33	// number of entries in table below
const float S_Meter_Cal[] =
{
// - Dummy variable		1,		//0, S0, 0dB
		14.1,	//1.41,	//1, S0.5, 3dB
		20,		//2,		//2, S1, 6dB
		28.1,	//2.81,	//3, S1.5, 9dB
		30,		//3,		//4, S2, 12dB
		56.2,	//5.62,	//5, S2.5, 15dB
		79.4,	//7.94,	//6, S3, 18dB
		112.2,	//11.22,	//7, S3.5, 21dB
		158.5,	//15.85,	//8, S4, 24dB
		223.9,	//22.39,	//9, S4.5, 27dB
		316.3,	//31.63,	//10, S5, 30dB
		446.7,	//44.67,	//11, S5.5, 33dB
		631,	//63.10,	//12, S6, 36dB
		891.3,	//89.13,	//13, S6.5, 39dB
		1258.9,	//125.89,	//14, S7, 42dB
		1778.3,	//177.83,	//15, S7.5, 45dB
		2511.9,	//251.19,	//16, S8, 48dB
		3548.1,	//354.81,	//17, S8.5, 51dB
		5011.9,	//501.19,	//18, S9, 54dB
		8912.5,	//891.25,	//19, +5, 59dB
		15848.9,	//1584.89,	//20, +10, 64dB
		28183.8,	//2818.38,	//21, +15, 69dB
		50118.7,	//5011.87,	//22, +20, 74dB
		89125.1,	//8912.51,	//23, +25, 79dB
		158489.3,	//15848.93,	//24, +30, 84dB
		281838.2,	//28183.82,	//25, +35, 89dB
		501187.2,	//50118.72,	//26, +35, 94dB
		891250.9,	//89125.09,	//27, +40, 99dB
		1585893.2,	//158489.32,	//28, +45, 104dB
		2818382.9,	//281838.29,	//29, +50, 109dB
		5011872.3,	//501187.23,	//30, +55, 114dB
		8912509.4,	//891250.94,	//31, +60, 119dB
		15848931.9,	//1584893.19,	//32, +65, 124dB
		28183829.3,	//2818382.93	//33, +70, 129dB
};
//
// Bands tuning values - WORKING registers - used "live" during transceiver operation
// (May contain VFO A, B or "Memory" channel values)
//
__IO ulong band_dial_value[MAX_BANDS+1];
__IO ulong band_decod_mode[MAX_BANDS+1];
__IO ulong band_filter_mode[MAX_BANDS+1];
//
// VFO A registers
//
__IO ulong band_dial_value_a[MAX_BANDS+1];
__IO ulong band_decod_mode_a[MAX_BANDS+1];
__IO ulong band_filter_mode_a[MAX_BANDS+1];
//
// VFO B registers
//
__IO ulong band_dial_value_b[MAX_BANDS+1];
__IO ulong band_decod_mode_b[MAX_BANDS+1];
__IO ulong band_filter_mode_b[MAX_BANDS+1];
//
static int16_t test_ui_a[250];		// dummy variable - space holder
//
// ------------------------------------------------
// Transceiver state public structure
extern __IO TransceiverState 	ts;

// ------------------------------------------------
// Frequency public
__IO DialFrequency 				df;

// ------------------------------------------------
// Encoder one public
__IO EncoderOneSelection		eos;

// ------------------------------------------------
// Encoder two public
__IO EncoderTwoSelection		ews;

// ------------------------------------------------
// Encoder three public
__IO EncoderThreeSelection		ets;

// ------------------------------------------------
// Keypad state
__IO KeypadState				ks;

// ------------------------------------------------
// Auto mode blinking text
//__IO AutoButtonState			abst;

// ------------------------------------------------
// On screen clock
//__IO ClockState 				cs;

// ------------------------------------------------
// SWR/Power meter
__IO SWRMeter					swrm;

// ------------------------------------------------
// Power supply meter
__IO PowerMeter					pwmt;

// ------------------------------------------------
// LO Tcxo
__IO LoTcxo						lo;

// ------------------------------------------------
// Eeprom Saving
__IO EepromSave					es;

// ------------------------------------------------
// CAT driver state
__IO CatDriver					kd;

// move to struct ??
__IO ulong 						unmute_delay = 0;

// ------------------------------------------------
// Spectrum display
extern __IO	SpectrumDisplay		sd;

// ------------------------------------------------
// Public USB Keyboard status
extern __IO KeypadState		ks;

// ------------------------------------------------
// Public s meter
extern	__IO	SMeter			sm;
//
// Public Audio
extern __IO		AudioDriverState	ads;

// ------------------------------------------------
// Eeprom items
extern uint16_t VirtAddVarTab[NB_OF_VAR];


uchar drv_state = 0;
uchar drv_init = 0;

//
extern __IO	FilterCoeffs		fc;

//
// RX Hilbert transform (90 degree) FIR filter state tables and instances
//
static float32_t 		FirState_I[128];
extern __IO arm_fir_instance_f32 	FIR_I;
//
static float32_t 		FirState_Q[128];
extern __IO arm_fir_instance_f32 	FIR_Q;

//
// TX Hilbert transform (90 degree) FIR filter state tables and instances
//
static float 			FirState_I_TX[128];
extern __IO	arm_fir_instance_f32	FIR_I_TX;

static float 			FirState_Q_TX[128];
extern __IO	arm_fir_instance_f32	FIR_Q_TX;
//

//*----------------------------------------------------------------------------
//* Function Name       : ui_driver_init
//* Object              :
//* Object              :
//* Input Parameters    :
//* Output Parameters   :
//* Functions called    :
//*----------------------------------------------------------------------------
void ui_driver_init(void)
{
	short res;


#ifdef DEBUG_BUILD
	printf("ui driver init...\n\r");
#endif

	// Driver publics init
	UiDriverPublicsInit();

#ifndef DSP_MODE
	// Load stored data from eeprom - some are needed for initialization
	UiDriverLoadEepromValues();
#endif

	// Init frequency publics
	UiDriverInitFrequency();

#ifndef DSP_MODE
	// Load stored data from eeprom - again - as some of the values above would have been overwritten from the above
	UiDriverLoadEepromValues();
#endif

#ifdef DSP_MODE
	ts.audio_max_volume = 16;	//MAX_AUDIO_GAIN;
#endif

	//
	UiCalcTxCompLevel();		// calculate current settings for TX speech compressor
	//
	df.tune_new = band_dial_value[ts.band];		// init "tuning dial" frequency based on restored settings
	df.tune_old = df.tune_new;
	//
	UiCWSidebandMode();			// determine CW sideband mode from the restored frequency
	//
	UiCalcRxIqGainAdj();		// Init RX IQ gain
	//
	UiCalcRxPhaseAdj();			// Init RX IQ Phase (Hilbert transform)
	//
	UiCalcTxPhaseAdj();			// Init TX IQ Phase (Hilbert transform)
	//
	UiCalcTxIqGainAdj();		// Init TX IQ gain
	//
	// Init spectrum display
	UiDriverInitSpectrumDisplay();
	UiInitSpectrumScopeWaterfall();
	sd.display_offset = INIT_SPEC_AGC_LEVEL;		// initialize setting for display offset/AGC

	// Temp sensor setup
	lo.sensor_present = ui_si570_init_temp_sensor();

	// Read SI570 settings
	res = ui_si570_get_configuration();
	if(res != 0)
	{
		//printf("err I2C: %d\n\r",res);
	}

	// Create desktop screen
	UiDriverCreateDesktop();
	UiDriverDisplayFilterBW();	// Update on-screen indicator of filter bandwidth

	// Set SoftDDS in CW mode
	if(ts.dmod_mode == DEMOD_CW)
		softdds_setfreq((float)ts.sidetone_freq,ts.samp_rate,0);	// set sidetone - and CW TX offset from carrier
	else
		softdds_setfreq(0.0,ts.samp_rate,0);						// no "DDS" in non-CW modes

	// Update codec volume
	//  0 - 16: via codec command
	// 17 - 30: soft gain after decoder
	Codec_Volume((ts.audio_gain*8));		// This is only approximate - it will be properly set later

	// Set TX power factor
	UiDriverSetBandPowerFactor(ts.band);

	// Reset inter driver requests flag
	ts.LcdRefreshReq	= 0;
	ts.new_band 		= ts.band;
	df.step_new 		= df.tuning_step;

	// Extra HW init
	mchf_board_post_init();

	// Acknowledge end of init for the main thread called
	// via irq(even before the init is done)
	// bit useless since 0.171 as IRQs are enabled in
	// mchf_board_post_init(), but still used by
	// ui_driver_toggle_tx() to prevent re-entrance
	drv_init = 1;

	// Do update of frequency display
	ts.refresh_freq_disp = 1;	// make frequency display refresh all digits
	//
	if(ts.vfo_mem_mode & 0x80)	{	// in SPLIT mode?
		UiDriverUpdateFrequency(1,3);	// force display of second (TX) VFO frequency
		UiDriverUpdateFrequency(1,2);	// update RX frequency
	}
	else	// not in SPLIT mode - standard update
		UiDriverUpdateFrequency(1,0);

	ts.refresh_freq_disp = 0;	// clear flag that causes frequency display function to update ALL digits

	//
	UiLCDBlankTiming();			// init timing for LCD blanking
	ts.lcd_blanking_time = ts.sysclock + LCD_STARTUP_BLANKING_TIME;

#ifdef DEBUG_BUILD
	printf("ui driver init ok\n\r");
#endif
}

//*----------------------------------------------------------------------------
//* Function Name       : ui_driver_thread
//* Object              : non urgent, time taking operations
//* Object              :
//* Input Parameters    :
//* Output Parameters   :
//* Functions called    :
//*----------------------------------------------------------------------------
void ui_driver_thread(void)
{
	if(ts.misc_flags1 & 128)	// is waterfall mode enabled?
	{
#ifndef DSP_MODE
		UiDriverReDrawWaterfallDisplay();	// yes - call waterfall update instead
#endif
	}
	else
		UiDriverReDrawSpectrumDisplay();	// Spectrum Display enabled - do that!

	if(ts.thread_timer)			// bail out if it is not time to do this task
		return;

	ts.thread_timer = 1;		// reset flag to schedule next occurrance
	//
	switch(drv_state)
	{
		case STATE_S_METER:
			UiDriverHandleSmeter();
			break;
		case STATE_SWR_METER:
			UiDriverHandleLowerMeter();
			break;
		case STATE_HANDLE_POWERSUPPLY:
			UiDriverHandlePowerSupply();
			break;
		case STATE_LO_TEMPERATURE:
			UiDriverHandleLoTemperature();
			break;
		case STATE_TASK_CHECK:
			UiDriverTimeScheduler();		// Handles live update of Calibrate between TX/RX and volume control
			break;
		case STATE_CHECK_ENC_ONE:
			UiDriverCheckEncoderOne();
			break;
		case STATE_CHECK_ENC_TWO:
			UiDriverCheckEncoderTwo();
			break;
		case STATE_CHECK_ENC_THREE:
			UiDriverCheckEncoderThree();
			break;
		case STATE_UPDATE_FREQUENCY:
			UiDriverUpdateFrequency(0,0);
			break;
		case STATE_PROCESS_KEYBOARD:
			UiDriverProcessKeyboard();
			break;
		case STATE_SWITCH_OFF_PTT:
			UiDriverSwitchOffPtt();
			break;
		default:
			drv_state = 0;
			return;
	}
	drv_state++;

	// -------------------------------
	// API driver action requests
	if(ts.band != ts.api_band)
	{
		mchf_board_red_led(1);
		UiDriverChangeBandA();
		mchf_board_red_led(0);
	}

}
// **************************  OBSOLETE  ***************************************
// **************************  OBSOLETE  ***************************************
// **************************  OBSOLETE  ***************************************
// **************************  OBSOLETE  ***************************************
// **************************  OBSOLETE  ***************************************
// **************************  OBSOLETE  ***************************************
// **************************  OBSOLETE  ***************************************
// **************************  OBSOLETE  ***************************************
// **************************  OBSOLETE  ***************************************
// **************************  OBSOLETE  ***************************************

//*----------------------------------------------------------------------------
//* Function Name       : ui_driver_irq - THIS FUNCTION IS OBSOLETE!
//* Object              : All real time processing here
//* Object              : only fast, non blocking operations
//* Input Parameters    :
//* Output Parameters   :
//* Functions called    :
//*----------------------------------------------------------------------------
void ui_driver_irq(void)
{
#if 0

	// Do not run the state machine
	// before the driver init is done
	if(!drv_init)
		return;

	switch(drv_state)
	{
/*		case STATE_SPECTRUM_DISPLAY:
			if(ts.misc_flags1 & 128)		// is waterfall mode to be used?  call it instead
				UiDriverReDrawWaterfallDisplay();
			else
				UiDriverReDrawSpectrumDisplay();
			break;
*/
		case STATE_S_METER:
			UiDriverHandleSmeter();
			break;
		case STATE_SWR_METER:
			if(ts.txrx_mode == TRX_MODE_TX)	{		// do this if in TX mode
				UiDriverHandleLowerMeter();
				break;
			}
			drv_state++;					// drop through if in RX mode
		case STATE_HANDLE_POWERSUPPLY:
			UiDriverHandlePowerSupply();
			break;
		case STATE_LO_TEMPERATURE:
			UiDriverHandleLoTemperature();
			break;
		case STATE_TASK_CHECK:
			UiDriverTimeScheduler();		// Handles live update of Calibrate between TX/RX and volume control
			break;
		case STATE_CHECK_ENC_ONE:
			UiDriverCheckEncoderOne();
			break;
		case STATE_CHECK_ENC_TWO:
			UiDriverCheckEncoderTwo();
			break;
		case STATE_CHECK_ENC_THREE:
			UiDriverCheckEncoderThree();
			break;
		case STATE_UPDATE_FREQUENCY:
			UiDriverUpdateFrequency(0,0);
			break;
		case STATE_PROCESS_KEYBOARD:
			UiDriverProcessKeyboard();
			break;
		case STATE_SWITCH_OFF_PTT:
			UiDriverSwitchOffPtt();
			break;
		default:
			drv_state = 0;
			return;
	}
	drv_state++;
#endif
}

//*----------------------------------------------------------------------------
//* Function Name       : ui_driver_toggle_tx
//* Object              :
//* Object              :
//* Input Parameters    :
//* Output Parameters   :
//* Functions called    :
//*----------------------------------------------------------------------------
void ui_driver_toggle_tx(void)
{

	static bool was_menu = 0;		// used to detect if we *were* in the menu
	static bool was_rx = 1;
	static bool rx_muted = 0;
	bool	reset_freq = 0;
	ulong	calc_var;

	// Disable irq processing
	drv_init = 0;
	if(ts.txrx_mode == TRX_MODE_TX)
	{
		//
		// Below, in VOICE modes we mute the audio BEFORE we activate the PTT.  This is necessary since U3 is switched the instant that we do so,
		// rerouting audio paths and causing all sorts of disruption including CLICKs and squeaks.
		// We restore TX audio levels in the function "Codec_RX_TX()" according to operating mode
		//
		ts.dsp_inhibit = 1;								// disable DSP when going into TX mode
		//
		if(ts.dmod_mode == DEMOD_AM)	{		// is it AM mode?
			if(ts.power_level < PA_LEVEL_2W)	{	// is it over 2 watts?
				ts.power_level = PA_LEVEL_2W;	// yes - force to 2 watts
				//
				UiDriverChangePowerLevel();			// update the power level display
				if(ts.tune)		// recalculate sidetone gain only if transmitting/tune mode
					Codec_SidetoneSetgain();
				//
				if(ts.menu_mode)	// are we in menu mode?
					UiDriverUpdateMenu(0);	// yes, update display when we change power setting
			}
		}
		//
		if(ts.dmod_mode != DEMOD_CW)	{				// are we in a voice mode?
			if(ts.tx_audio_source != TX_AUDIO_MIC)	{	// yes - are we in LINE IN mode?
				Codec_Line_Gain_Adj(0);	// yes - momentarily mute LINE IN audio if in LINE IN mode until we have switched to TX
			}
			else	{	// we are in MIC IN mode
				Codec_Line_Gain_Adj(0);			// momentarily mute LINE IN audio until we switch modes because we will blast any connected LINE IN source until we switch
				ts.tx_mic_gain_mult_temp = ts.tx_mic_gain_mult;		// temporarily hold the mic gain value while we switch
				ts.tx_mic_gain_mult = 0;		// momentarily set the mic gain to zero while we go to TX
				Codec_WriteRegister(W8731_ANLG_AU_PATH_CNTR,0x0016);	// Mute the microphone with the CODEC (this does so without a CLICK)
			}
			//
			if((ts.iq_freq_mode) && (!rx_muted))	{	// Is translate mode active and we have NOT already muted the audio?
				Codec_Volume(0);	// yes - mute the audio codec to suppress an approx. 6 kHz chirp when going in to TX mode
				rx_muted = 1;		// indicate that we've muted the audio so we don't do this every time through
			}
			//
			non_os_delay();		// pause an instant because the codec chip has its own delay before tasks complete!
		}
		//
		PTT_CNTR_PIO->BSRRL  	= PTT_CNTR;		// TX on and switch CODEC audio paths
		RED_LED_PIO->BSRRL 		= RED_LED;		// Red led on
		//
		// Set the PA bias according to mode
		//
		if((ts.pa_cw_bias) && (ts.dmod_mode == DEMOD_CW))	{	// is CW PA bias non-zero AND are we in CW mode?
			calc_var = BIAS_OFFSET + (ts.pa_cw_bias * 2);		// use special CW-mode bias setting
			if(calc_var > 255)
				calc_var = 255;
			//
			// Set DAC Channel 1 DHR12L register
			DAC_SetChannel2Data(DAC_Align_8b_R,calc_var);		// set PA bias
		}
		else	{
			calc_var = BIAS_OFFSET + (ts.pa_bias * 2);		// use "default" bias setting
			if(calc_var > 255)
				calc_var = 255;
			//
			// Set DAC Channel 1 DHR12L register
			DAC_SetChannel2Data(DAC_Align_8b_R,calc_var);		// set PA bias
		}
		//
		//	initialize everything in CW mode
		if(ts.dmod_mode == DEMOD_CW)	{
			softdds_setfreq((float)ts.sidetone_freq, ts.samp_rate,0);	// set sidetone frequency in CW mode (this also set TX shift)
		}
	}
	// RX Mode
	else
	{
		was_rx = 1;								// indicate that we WERE in RX mode
		PTT_CNTR_PIO->BSRRH  	= PTT_CNTR;		// TX off
		RED_LED_PIO->BSRRH 		= RED_LED;		// Red led off
		//
		UiDriverUpdateBtmMeter(0,0);		// clear bottom meter of any outstanding indication when going back to RX
		//
		rx_muted = 0;		// clear flag to indicate that we've muted the audio
	}

	reset_freq = 0;		// clear flag that indicates that we should reset the frequency

	if(ts.vfo_mem_mode & 0x80)	{				// is SPLIT mode active?
		reset_freq = 1;							// yes - indicate that we WILL need to reset the synthesizer frequency
		if(ts.vfo_mem_mode & 0x40)	{				// is VFO-B active?
			if(ts.txrx_mode == TRX_MODE_TX)	{	// are we in TX mode?
				if(was_rx)	{						// did we just enter TX mode?
					band_dial_value_b[ts.band] = df.tune_new;	// yes - save current RX frequency in VFO location (B)
					was_rx = 0;						// indicate that we are now in transmit mode to prevent re-loading of frequency
				}
				df.tune_new = band_dial_value_a[ts.band];	// load with VFO-A frequency
			}
			else					// we are in RX mode
				df.tune_new = band_dial_value_b[ts.band];	// load with VFO-B frequency
		}
		else	{	// VFO-A is active
			if(ts.txrx_mode == TRX_MODE_TX)	{				// are we in TX mode?
				if(was_rx)	{								// did we just enter TX mode?
					band_dial_value_a[ts.band] = df.tune_new;	// yes - save current RX frequency in VFO location (A)
					was_rx = 0;						// indicate that we are now in transmit mode to prevent re-loading of frequency
					// If using a serial (SPI) LCD, hold off on updating the spectrum scope for a time AFTER we stop twiddling the tuning knob.
					//
					if(sd.use_spi)
						ts.hold_off_spectrum_scope	= ts.sysclock + SPECTRUM_SCOPE_SPI_HOLDOFF_TIME_TUNE;	// schedule the time after which we again update the spectrum scope
					//
				}
				df.tune_new = band_dial_value_b[ts.band];	// load with VFO-B frequency
			}
			else							// we are in RX mode
				df.tune_new = band_dial_value_a[ts.band];	// load with VFO-A frequency
		}
	}

	if((reset_freq) || (ts.rit_value) || ((ts.iq_freq_mode) && (ts.dmod_mode == DEMOD_CW)))		// Re-set frequency if RIT is non-zero or in CW mode with translate OR if in SPLIT mode and we had to retune
		UiDriverUpdateFrequencyFast();

	if((ts.menu_mode) || (was_menu))	{			// update menu when we are (or WERE) in MENU mode
		UiDriverUpdateMenu(0);
		was_menu = 1;
	}

	if(was_menu)		// if we'd displayed the menu previously, clear the flag
		was_menu = 0;
	//
	// Switch codec mode
	Codec_RX_TX();
	//
	// Enable irq processing
	drv_init = 1;
	//

}

//*----------------------------------------------------------------------------
//* Function Name       : UiDriverPublicsInit
//* Object              :
//* Input Parameters    :
//* Output Parameters   :
//*----------------------------------------------------------------------------
static void UiDriverPublicsInit(void)
{
	// Button state structure init state
	ks.button_id			= BUTTON_NONE;
	ks.button_pressed		= 0;
	ks.button_released		= 0;
	ks.button_processed		= 0;
	ks.debounce_time		= 0;

	// Init encoder one
	eos.value_old 			= 0;
	eos.value_new			= ENCODER_ONE_RANGE;
	eos.de_detent			= 0;

	// Init encoder two
	ews.value_old 			= 0;
	ews.value_new			= ENCODER_TWO_RANGE;
	ews.de_detent			= 0;

	// Init encoder three
	ets.value_old 			= 0;
	ets.value_new			= ENCODER_THR_RANGE;
	ets.de_detent			= 0;

	// Auto button blink state
	//abst.blink_flag 		= 0;
	//abst.blink_skip 		= 0;

	// SWR meter init
	swrm.skip 				= 0;
	swrm.p_curr				= 0;

	swrm.fwd_calc			= 0;
	swrm.rev_calc			= 0;
	swrm.fwd_pwr			= 0;
	swrm.rev_pwr			= 0;
	swrm.fwd_dbm			= 0;
	swrm.rev_dbm			= 0;
	swrm.vswr			 	= 0;
	swrm.sensor_null		= SENSOR_NULL_DEFAULT;
	swrm.coupling_80m_calc		= SWR_COUPLING_DEFAULT;
	swrm.coupling_40m_calc		= SWR_COUPLING_DEFAULT;
	swrm.coupling_20m_calc		= SWR_COUPLING_DEFAULT;
	swrm.coupling_15m_calc		= SWR_COUPLING_DEFAULT;
	swrm.pwr_meter_disp		= 0;	// Display of numerical FWD/REV power metering off by default
	swrm.pwr_meter_was_disp = 0;	// Used to indicate if FWD/REV numerical power metering WAS displayed

	// Power supply meter
	pwmt.skip 				= 0;
	pwmt.p_curr				= 0;
	pwmt.pwr_aver 			= 0;

	// LO tcxo
	lo.skip					= 0;
	lo.comp					= 0;
	lo.v1000000				= 0;
	lo.v100000				= 0;
	lo.v10000				= 0;
	lo.v1000				= 0;
}

//*----------------------------------------------------------------------------
//* Function Name       : UiDriverProcessKeyboard
//* Object              : process hardcoded buttons click and hold
//* Input Parameters    :
//* Output Parameters   :
//* Functions called    :
//*----------------------------------------------------------------------------
static void UiDriverProcessKeyboard(void)
{
	uchar temp;

	if(ks.button_processed)	{
		ts.nb_disable = 1;	// disable noise blanker if button is pressed or held
		//
		UiLCDBlankTiming();	// calculate/process LCD blanking timing
		//
		//printf("button process: %02x, debounce time: %d\n\r",ks.button_id,ks.debounce_time);

		// Is it click or hold ?
		if(!ks.press_hold)	{
			// Process click
			switch(ks.button_id)
			{
				//
				case BUTTON_G1_PRESSED:	// BUTTON_G1 - Change operational mode
					if((!ts.tune) && (ts.txrx_mode == TRX_MODE_RX))	{	// do NOT allow mode change in TUNE mode or transmit mode
						UiDriverChangeDemodMode(0);
						UiCWSidebandMode();
						if(ts.menu_mode)	// are we in menu mode?
							UiDriverUpdateMenu(0);	// yes, update display when we change modes
						//
						UiCalcTxIqGainAdj();		// update gain and phase values when changing modes
						UiCalcTxPhaseAdj();
						UiCalcRxPhaseAdj();
						UiDriverChangeDSPMode();	// Change DSP display setting as well
						UiDriverDisplayFilterBW();	// update on-screen filter bandwidth indicator
						UiDriverUpdateFrequency(1,0);	// update frequency display without checking encoder
						//
						if(ts.dmod_mode == DEMOD_CW)	{		// update on-screen adjustments
							UiDriverChangeKeyerSpeed(0);		// emplace keyer speed (WPM) and
							UiDriverChangeStGain(0);			// sidetone gain when in CW mode
						}
						else	{
							UIDriverChangeAudioGain(0);			// display Line/Mic gain and
							UiDriverChangeCmpLevel(0);			// Compression level when in voice mode
						}
						//
					}
					break;
				//
				case BUTTON_G2_PRESSED:		// BUTTON_G2
				{
					if((!(ts.dsp_active & 1)) && (!(ts.dsp_active & 4)))	// both NR and notch are inactive
						ts.dsp_active |= 1;									// turn on NR
					else if((ts.dsp_active & 1) && (!(ts.dsp_active & 4))) {	// NR active, notch inactive
						if(ts.dmod_mode != DEMOD_CW)	{	// NOT in CW mode
							ts.dsp_active |= 4;									// turn on notch
							ts.dsp_active &= 0xfe;								// turn off NR
						}
						else	{	// CW mode - do not select notches, skip directly to "off"
							ts.dsp_active &= 0xfa;	// turn off NR and notch
						}
					}
					else if((!(ts.dsp_active & 1)) && (ts.dsp_active & 4))	//	NR inactive, notch active
						if((ts.dmod_mode == DEMOD_AM) && (ts.filter_id == AUDIO_WIDE))		// was it AM with a 10 kHz filter selected?

							ts.dsp_active &= 0xfa;			// it was AM + 10 kHz - turn off NR and notch
						else
							ts.dsp_active |= 1;				// no - turn on NR
					//
					else	{
						ts.dsp_active &= 0xfa;								// turn off NR and notch
					}
					//
					ts.dsp_active_toggle = ts.dsp_active;	// save update in "toggle" variable
					//
					ts.reset_dsp_nr = 1;				// reset DSP NR coefficients
					audio_driver_set_rx_audio_filter();	// update DSP settings
					ts.reset_dsp_nr = 0;
					UiDriverChangeDSPMode();			// update on-screen display
					//
					// Update DSP/NB/RFG control display
					if(ts.enc_two_mode == ENC_TWO_MODE_RF_GAIN)
						UiDriverChangeSigProc(0);
					else
						UiDriverChangeSigProc(1);
//					}
					break;
				}
				//
				case BUTTON_G3_PRESSED:		{	// BUTTON_G3 - Change power setting
					ts.power_level++;
					//
					if(ts.dmod_mode == DEMOD_AM)	{			// in AM mode?
						if(ts.power_level >= PA_LEVEL_MAX_ENTRY)	// yes, power over 2 watts?
							ts.power_level = PA_LEVEL_2W;	// force to 2 watt mode when we "roll over"
					}
					else	{	// other modes, do not limit max power
						if(ts.power_level >= PA_LEVEL_MAX_ENTRY)
							ts.power_level = PA_LEVEL_FULL;
					}
					//
					UiDriverChangePowerLevel();
					if(ts.tune)		// recalculate sidetone gain only if transmitting/tune mode
						if(!ts.iq_freq_mode)	// Is translate mode *NOT* active?
							Codec_SidetoneSetgain();
					//
					if(ts.menu_mode)	// are we in menu mode?
						UiDriverUpdateMenu(0);	// yes, update display when we change power setting
					//
					break;
				}
				//
				case BUTTON_G4_PRESSED:		{		// BUTTON_G4 - Change filter bandwidth
					if(!ts.tune)	{
						ts.filter_id++;
						//
						if(ts.filter_id >= AUDIO_MAX_FILTER)
							ts.filter_id = AUDIO_MIN_FILTER;
						//
						UiDriverProcessActiveFilterScan();	// make sure that filter is active - if not, find next active filter
						//
						// Change filter
						//
						UiDriverChangeFilter(0);
						UiCalcRxPhaseAdj();			// We may have changed something in the RX filtering as well - do an update
						UiDriverChangeDSPMode();	// Change DSP display setting as well
						UiDriverDisplayFilterBW();	// update on-screen filter bandwidth indicator
						//
						if(ts.menu_mode)	// are we in menu mode?
							UiDriverUpdateMenu(0);	// yes, update display when we change filters
						//
					}
					break;
				}
				//
				case BUTTON_M1_PRESSED:		// BUTTON_M1
					UiDriverChangeEncoderOneMode(0);
					break;
				//
				case BUTTON_M2_PRESSED:		// BUTTON_M2
					UiDriverChangeEncoderTwoMode(0);
					break;
				//
				case BUTTON_M3_PRESSED:		// BUTTON_M3
					UiDriverChangeEncoderThreeMode(0);
					break;
				//
				case BUTTON_STEPM_PRESSED:		// BUTTON_STEPM
					if(!(ts.freq_step_config & 0xf0))	// button swap NOT enabled
						UiDriverChangeTuningStep(0);	// decrease step size
					else		// button swap enabled
						UiDriverChangeTuningStep(1);	// increase step size
					break;
				//
				case BUTTON_STEPP_PRESSED:		// BUTTON_STEPP
					if(!(ts.freq_step_config & 0xf0))	// button swap NOT enabled
						UiDriverChangeTuningStep(1);	// increase step size
					else
						UiDriverChangeTuningStep(0);	// decrease step size
					break;
				//
				case BUTTON_BNDM_PRESSED:		// BUTTON_BNDM
					temp = ads.af_dissabled;
					ads.af_dissabled = 0;
					//
					ts.dsp_timed_mute = 1;		// disable DSP when changing bands
					ts.dsp_inhibit = 1;
					ts.dsp_inhibit_timing = ts.sysclock + DSP_BAND_CHANGE_DELAY;	// set time to re-enable DSP
					//
					if(ts.misc_flags1 & 2)		// band up/down button swapped?
						UiDriverChangeBand(1);	// yes - go up
					else
						UiDriverChangeBand(0);	// not swapped, go down
					//
					UiCWSidebandMode();
					UiDriverShowMode();
					UiDriverUpdateFrequency(1,0);	// update frequency display without checking encoder
					if(ts.menu_mode)	// are we in menu mode?
						UiDriverUpdateMenu(0);	// yes, update menu display when we change bands
					//
					ads.af_dissabled =  temp;
					break;
				//
				case BUTTON_BNDP_PRESSED:	// BUTTON_BNDP
					temp = ads.af_dissabled;
					ads.af_dissabled = 0;
					//
					ts.dsp_timed_mute = 1;		// disable DSP when changing bands
					ts.dsp_inhibit = 1;
					ts.dsp_inhibit_timing = ts.sysclock + DSP_BAND_CHANGE_DELAY;	// set time to re-enable DSP
					//
					if(ts.misc_flags1 & 2)		// band up/down button swapped?
						UiDriverChangeBand(0);	// yes, go down
					else
						UiDriverChangeBand(1);	// no, go up
					//
					UiCWSidebandMode();
					UiDriverShowMode();
					UiDriverUpdateFrequency(1,0);	// update frequency display without checking encoder
					if(ts.menu_mode)	// are we in menu mode?
						UiDriverUpdateMenu(0);	// yes, update display when we change bands
					//
					ads.af_dissabled = temp;
					break;
				//
				case BUTTON_POWER_PRESSED:
					ts.lcd_backlight_brightness++;
					ts.lcd_backlight_brightness &= 3;	// limit range of brightness to 0-3
					break;
				default:
					UiDriverProcessFunctionKeyClick(ks.button_id);
					break;
			}
		}
		else	{
			//
			// *******************************************************************************
			// Process press-and-hold of button(s).  Note that this can accommodate multiple buttons at once.
			// *******************************************************************************
			//
			switch(ks.button_id)	{
				case BUTTON_F1_PRESSED:	// Press-and-hold button F1:  Write settings to EEPROM
					if(ts.txrx_mode == TRX_MODE_RX)	{				// only allow EEPROM write in receive mode
						if(!ts.menu_mode)	{						// not in menu mode
							UiDriverClearSpectrumDisplay();			// clear display under spectrum scope
							UiLcdHy28_PrintText(80,160," Saving settings to EEPROM ",Cyan,Black,0);
							UiDriverSaveEepromValuesPowerDown();	// save settings to EEPROM
							for(temp = 0; temp < 6; temp++)			// delay so that it may be read
								non_os_delay();
								//
							UiInitSpectrumScopeWaterfall();			// init spectrum scope
							ts.menu_mode = 0;
						}
						else	// If in menu mode, just save data, but don't clear screen area
							UiDriverSaveEepromValuesPowerDown();	// save settings to EEPROM
						//
						ts.menu_var_changed = 0;					// clear "EEPROM SAVE IS NECESSARY" indicators
					}
					//
					if(!ts.menu_mode)	// are we in menu mode?
						UiLcdHy28_PrintText(POS_BOTTOM_BAR_F1_X,POS_BOTTOM_BAR_F1_Y," MENU  ",White,Black,0);	// no - update menu button to reflect no memory save needed
					else
						UiDriverUpdateMenu(0);	// update menu display to remove indicator to do power-off to save EEPROM value
					break;
				case BUTTON_F3_PRESSED:	// Press-and-hold button F3
					// Move to the BEGINNING of the current menu structure
					if(ts.menu_mode)	{		// Are we in menu mode?
						if(ts.menu_item < MAX_MENU_ITEM)	{	// Yes - Is this within the main menu?
							if(ts.menu_item)	// is this NOT the first menu item?
								ts.menu_item = 0;	// yes - set it to the beginning of the first menu
							else	{			// this IS the first menu item
								if(ts.radio_config_menu_enable)		// yes - is the configuration menu enabled?
									ts.menu_item = (MAX_MENU_ITEM + MAX_RADIO_CONFIG_ITEMS)-1;	// move to the last config/adjustment menu item
								else								// configuration menu NOT enabled
									ts.menu_item = MAX_MENU_ITEM - 1;
							}
						}
						else	{		// we are within the CONFIGURATION menu
							if(ts.menu_item > MAX_MENU_ITEM)		// is this NOT at the first entry of the configuration menu?
								ts.menu_item = MAX_MENU_ITEM;	// yes, go to the first entry of the configuration item
							else		// this IS the first entry of the configuration menu
								ts.menu_item = MAX_MENU_ITEM - 1;	// go to the last entry of the main menu
						}
						UiDriverUpdateMenu(0);	// update menu display
						UiDriverUpdateMenu(1);	// update cursor
					}
					else	{			// not in menu mode - toggle between VFO/SPLIT and Memory mode
						if(!ts.vfo_mem_flag)	{		// is it in VFO mode now?
							ts.vfo_mem_flag = 1;		// yes, switch to memory mode
							UiLcdHy28_PrintText(POS_BOTTOM_BAR_F3_X,POS_BOTTOM_BAR_F3_Y,"  MEM ",White,Black,0);	// yes - indicate with color
						}
						else	{
							ts.vfo_mem_flag = 0;		// it was in memory mode - switch to VFO mode
							if(ts.vfo_mem_mode & 0x80)	// SPLIT mode active?
								UiLcdHy28_PrintText(POS_BOTTOM_BAR_F3_X,POS_BOTTOM_BAR_F3_Y," SPLIT",SPLIT_ACTIVE_COLOUR,Black,0);	// yes - indicate with color
							else
								UiLcdHy28_PrintText(POS_BOTTOM_BAR_F3_X,POS_BOTTOM_BAR_F3_Y," SPLIT",SPLIT_INACTIVE_COLOUR,Black,0);		// not active - grey
						}
						//
					}
					break;
				case BUTTON_F4_PRESSED:	// Press-and-hold button F4
					//
					// Move to the END of the current menu structure
					if(ts.menu_mode){		// are we in menu mode?
						if(ts.menu_item < MAX_MENU_ITEM)	{	// Yes - Is this within the main menu?
							if(ts.menu_item == MAX_MENU_ITEM-1)	{	// are we on the LAST menu item of the main menu?
								if(ts.radio_config_menu_enable)		// Yes - is the configuration menu enabled?
									ts.menu_item = MAX_MENU_ITEM;	// yes - go to the FIRST item of the configuration menu
								else								// configuration menu NOT enabled
									ts.menu_item = 0;				// go to the FIRST menu main menu item
							}
							else									// we had not been on the last item of the main menu
								ts.menu_item = MAX_MENU_ITEM-1;		// go to the last item in the main menu
						}
						else	{		// we were NOT in the main menu, but in the configuration menu!
							if(ts.menu_item == (MAX_MENU_ITEM + MAX_RADIO_CONFIG_ITEMS-1))		// are we on the last item of the configuration menu?
								ts.menu_item = 0;					// yes - go to the first item of the main menu
							else	{		// we are NOT on the last item of the configuration menu
								ts.menu_item = (MAX_MENU_ITEM + MAX_RADIO_CONFIG_ITEMS) - 1;		// go to the last item in the configuration menu
							}
						}
						UiDriverUpdateMenu(0);	// update menu display
						UiDriverUpdateMenu(1);	// update cursor
					}
					else	{	// not in menu mode:  Make VFO A = VFO B or VFO B = VFO A, as appropriate
						if(ts.vfo_mem_mode & 0x40)	{	// are we in VFO B mode?
							band_dial_value_a[ts.band] = df.tune_new;					// yes, copy frequency into A
							band_decod_mode_a[ts.band] = ts.dmod_mode;					// copy active VFO (B) settings into A
							band_filter_mode_a[ts.band] = ts.filter_id;
						}
						else	{	// we were in VFO A mode
							band_dial_value_b[ts.band] = df.tune_new;					// yes, copy frequency into B
							band_decod_mode_b[ts.band] = ts.dmod_mode;					// copy active VFO (A) settings into B
							band_filter_mode_b[ts.band] = ts.filter_id;
						}
						if(ts.vfo_mem_mode & 0x80)	{	// are we in SPLIT mode?
							ts.refresh_freq_disp = 1;	// yes, we need to update the TX frequency:  Make frequency display refresh all digits
							UiDriverUpdateFrequency(1,3);	// force display of second (TX) VFO frequency
							UiDriverUpdateFrequency(1,2);	// Update receive frequency
							ts.refresh_freq_disp = 0;	// disable refresh all digits flag
						}
						UiDriverClearSpectrumDisplay();			// clear display under spectrum scope
						if(ts.vfo_mem_mode & 0x40)	// VFO B active?
							UiLcdHy28_PrintText(80,160,"VFO B -> VFO A",Cyan,Black,1);		// yes, indicate copy of B into A
						else			// VFO A active
							UiLcdHy28_PrintText(80,160,"VFO A -> VFO B",Cyan,Black,1);		// indicate copy of A into B
						for(temp = 0; temp < 18; temp++)			// delay so that it may be read
							non_os_delay();
							//
						UiInitSpectrumScopeWaterfall();			// init spectrum scope
					}
					break;
				case BUTTON_F5_PRESSED:			// Button F5 was pressed-and-held - Toggle TX Disable
					if(ts.tx_disable)	{
						ts.tx_disable = 0;		// Enable TX
						UiLcdHy28_PrintText(POS_BOTTOM_BAR_F5_X,POS_BOTTOM_BAR_F5_Y,"  TUNE",White,Black,0);	// Make TUNE button White
					}
					else	{
						ts.tx_disable = 1;		// Disable TX
						UiLcdHy28_PrintText(POS_BOTTOM_BAR_F5_X,POS_BOTTOM_BAR_F5_Y,"  TUNE",Grey1,Black,0);	// Make TUNE button Grey
					}
					break;
				case BUTTON_G1_PRESSED:	// Press-and-hold button G1 - Change operational mode, but include "disabled" modes
					if(!ts.tune)	{	// do NOT allow mode change in TUNE mode
						UiDriverChangeDemodMode(1);		// include any disabled modes
						UiCWSidebandMode();
						if(ts.menu_mode)	// are we in menu mode?
							UiDriverUpdateMenu(0);	// yes, update display when we change modes
						//
						UiCalcTxIqGainAdj();		// update gain and phase values when changing modes
						UiCalcTxPhaseAdj();
						UiCalcRxPhaseAdj();
						UiDriverChangeDSPMode();	// Change DSP display setting as well
						UiDriverDisplayFilterBW();	// Update on-screen indicator of filter bandwidth
						UiDriverUpdateFrequency(1,0);	// update frequency display without checking encoder
						//
						if(ts.dmod_mode == DEMOD_CW)	{		// update on-screen adjustments
							UiDriverChangeKeyerSpeed(0);		// emplace keyer speed (WPM) and
							UiDriverChangeStGain(0);			// sidetone gain when in CW mode
						}
						else	{
							UIDriverChangeAudioGain(0);			// display Line/Mic gain and
							UiDriverChangeCmpLevel(0);			// Compression level when in voice mode
						}
					}
					break;
				//
				case BUTTON_G2_PRESSED:		// Press and hold of BUTTON_G2 - turn DSP off/on
//					if(ts.filter_id != AUDIO_WIDE)	{		// do not allow change of mode when set to 10 kHz
						if(ts.dsp_active & 5)	{			// is DSP NR or NOTCH active?
							ts.dsp_active_toggle = ts.dsp_active;	// save setting for future toggling
							ts.dsp_active &= 0xfa;				// turn off NR and notch
						}
						else	{		// neither notch or NR was active
							if(ts.dsp_active_toggle != 0xff)	{	// has this holder been used before?
								ts.dsp_active = ts.dsp_active_toggle;	// yes - load value
							}
						}
						audio_driver_set_rx_audio_filter();	// update DSP settings
						UiDriverChangeDSPMode();			// update on-screen display
						//
						// Update DSP/NB/RFG control display
						if(ts.enc_two_mode == ENC_TWO_MODE_RF_GAIN)
							UiDriverChangeSigProc(0);
						else
							UiDriverChangeSigProc(1);
//					}
					break;
				case BUTTON_G4_PRESSED:		{	// Press-and-hold button G4 - Change filter bandwidth, allowing disabled filters
					if(!ts.tune)	{
						ts.filter_id++;
						//
						if(ts.filter_id >= AUDIO_MAX_FILTER)
							ts.filter_id = AUDIO_MIN_FILTER;
						//
						// Change filter
						//
						UiDriverChangeFilter(0);
						UiCalcRxPhaseAdj();			// We may have changed something in the RX filtering as well - do an update
						UiDriverChangeDSPMode();	// Change DSP display setting as well
						UiDriverDisplayFilterBW();	// update on-screen filter bandwidth indicator
						//
						if(ts.menu_mode)	// are we in menu mode?
							UiDriverUpdateMenu(0);	// yes, update display when we change filters
						//
					}
					break;
				}
				case BUTTON_M2_PRESSED:	// Press-and-hold button M2:  Switch display between DSP "strength" setting and NB (noise blanker) mode
					ts.dsp_active ^= 8;	// toggle whether or not DSP or NB is to be displayed
					//
					if(ts.enc_two_mode == ENC_TWO_MODE_RF_GAIN)
						UiDriverChangeSigProc(0);
					else
						UiDriverChangeSigProc(1);
					break;
				case BUTTON_M3_PRESSED:	// Press-and-hold button M3:  Switch display between MIC and Line-In mode
					if(ts.dmod_mode != DEMOD_CW)	{
						if(ts.tx_audio_source == TX_AUDIO_MIC)
							ts.tx_audio_source = TX_AUDIO_LINEIN;
						else
							ts.tx_audio_source = TX_AUDIO_MIC;
						//
						if(ts.enc_thr_mode == ENC_THREE_MODE_RIT)	// if encoder in RIT mode, grey out audio gain control
							UIDriverChangeAudioGain(0);
						else									// not RIT mode - don't grey out
							UIDriverChangeAudioGain(1);
					}
					break;
				case BUTTON_POWER_PRESSED:
					if(!UiDriverButtonCheck(BUTTON_BNDM_PRESSED))	{	// was button BAND- pressed at the same time?
						if(ts.lcd_backlight_blanking & 0x80)			// Yes - is MSB set, indicating "stealth" (backlight timed-off) mode?
							ts.lcd_backlight_blanking &= 0x7f;		// yes - clear that bit, turning off "stealth" mode
						else if(ts.lcd_backlight_blanking & 0x0f)	// bit NOT set AND the timing set to NON-zero?
							ts.lcd_backlight_blanking |= 0x80;		// no - turn on MSB to activate "stealth" mode
					}
					else	{	// ONLY the POWER button was pressed
						if(ts.txrx_mode == TRX_MODE_RX)		// only allow power-off in RX mode
							mchf_board_power_off();
					}
					break;
				case BUTTON_BNDM_PRESSED:			// BAND- button pressed-and-held?
					if(!UiDriverButtonCheck(BUTTON_POWER_PRESSED))	{	// and POWER button pressed-and-held at the same time?
						if(ts.lcd_backlight_blanking & 0x80)			// Yes - is MSB set, indicating "stealth" (backlight timed-off) mode?
							ts.lcd_backlight_blanking &= 0x7f;		// yes - clear that bit, turning off "stealth" mode
						else if(ts.lcd_backlight_blanking & 0x0f)	// bit NOT set AND the timing set to NON-zero?
							ts.lcd_backlight_blanking |= 0x80;		// no - turn on MSB to activate "stealth" mode
					}
					else if(!UiDriverButtonCheck(BUTTON_BNDP_PRESSED))	{	// and BAND-UP pressed at the same time?
						if(!ts.menu_mode)	{			// do not do this in menu mode!
							if(ts.misc_flags1 & 128)	{		// is the waterfall mode active?
								ts.misc_flags1 &=  0x7f;	// yes, turn it off
								UiInitSpectrumScopeWaterfall();			// init spectrum scope
							}
							else	{	// waterfall mode was turned off
								ts.misc_flags1 |=  128;	// turn it on
								UiInitSpectrumScopeWaterfall();			// init spectrum scope
							}
							UiDriverDisplayFilterBW();	// Update on-screen indicator of filter bandwidth
						}
					}
					break;
				case BUTTON_BNDP_PRESSED:			// BAND+ button pressed-and-held?
					if(!UiDriverButtonCheck(BUTTON_BNDM_PRESSED))	{	// and BAND-DOWN pressed at the same time?
						if(!ts.menu_mode)	{		// do not do this if in menu mode!
							if(ts.misc_flags1 & 128)	{		// is the waterfall mode active?
								ts.misc_flags1 &=  0x7f;	// yes, turn it off
								UiInitSpectrumScopeWaterfall();			// init spectrum scope
							}
							else	{	// waterfall mode was turned off
								ts.misc_flags1 |=  128;	// turn it on
								UiInitSpectrumScopeWaterfall();			// init spectrum scope
							}
							UiDriverDisplayFilterBW();	// Update on-screen indicator of filter bandwidth
						}
					}
					break;
				case BUTTON_STEPM_PRESSED:
					if(!UiDriverButtonCheck(BUTTON_STEPP_PRESSED))	{	// was button STEP+ pressed at the same time?
						ts.frequency_lock = !ts.frequency_lock;
						// update frequency display
						ts.refresh_freq_disp = 1;	// make frequency display refresh all digits
						//
						if(ts.vfo_mem_mode & 0x80)	{	// in SPLIT mode?
							UiDriverUpdateFrequency(1,3);	// force display of second (TX) VFO frequency
							UiDriverUpdateFrequency(1,2);	// update RX frequency
						}
						else	{	// not in SPLIT mode - standard update
							UiDriverUpdateFrequency(1,0);
						}
						ts.refresh_freq_disp = 0;	// restore selective update mode for frequency display
					}
					else	{
						if(!(ts.freq_step_config & 0xf0))	// button swap NOT enabled
							UiDriverPressHoldStep(0);	// decrease step size
						else		// button swap enabled
							UiDriverPressHoldStep(1);	// increase step size
					}
					//
					break;
				case BUTTON_STEPP_PRESSED:
					if(!UiDriverButtonCheck(BUTTON_STEPM_PRESSED))	{	// was button STEP- pressed at the same time?
						ts.frequency_lock = !ts.frequency_lock;
						// update frequency display
						ts.refresh_freq_disp = 1;	// make frequency display refresh all digits
						//
						if(ts.vfo_mem_mode & 0x80)	{	// in SPLIT mode?
							UiDriverUpdateFrequency(1,3);	// force display of second (TX) VFO frequency
							UiDriverUpdateFrequency(1,2);	// update RX frequency
						}
						else	{	// not in SPLIT mode - standard update
							UiDriverUpdateFrequency(1,0);
						}
						ts.refresh_freq_disp = 0;	// restore selective update mode for frequency display
					}
					else	{
						if(!(ts.freq_step_config & 0xf0))	// button swap NOT enabled
							UiDriverPressHoldStep(1);	// increase step size
						else		// button swap enabled
							UiDriverPressHoldStep(0);	// decrease step size
					}
					break;
				default:
					break;
			}
		}
		//
		ts.nb_disable = 0;	// re-enable noise blanker when done processing buttons
		//
		// Reset flag, allow other buttons to be checked
		ks.button_processed = 0;
		ks.debounce_time	= 0;
	}
}
//
//
//*----------------------------------------------------------------------------
//* Function Name       : UiDriverPressHoldStep
//* Object              : Select the step size for the press-and-hold of the step size button
//* Input Parameters    : 0=Decrease step size, 1=Increase step size
//* Output Parameters   :
//* Functions called    :
//*----------------------------------------------------------------------------
static void UiDriverPressHoldStep(uchar is_up)
{
	ulong	minus_idx, plus_idx;

	switch(df.selected_idx)	{		// select appropriate "alternate" step size based on current step size
		case T_STEP_1HZ_IDX:	// 1Hz step size
		case T_STEP_10HZ_IDX:	// 10Hz step size
			minus_idx = T_STEP_1HZ_IDX;		// use 1 Hz as small step size
			plus_idx = T_STEP_1KHZ_IDX;		// use 1 kHz as large step size
			break;
		case T_STEP_100HZ_IDX:	// 100Hz step size
			minus_idx = T_STEP_10HZ_IDX;		// use 10 Hz as small step size
			plus_idx = T_STEP_1KHZ_IDX;		// use 1 kHz as large step size
			break;
		case T_STEP_10KHZ_IDX:	// 10 kHz step size
		case T_STEP_100KHZ_IDX:	// 100 kHz step size
			minus_idx = T_STEP_100HZ_IDX;	// use 100 Hz as small step size
			plus_idx = T_STEP_100KHZ_IDX;	// use 100 kHz as large step size
			break;
		case T_STEP_1KHZ_IDX:	// 1 kHz step size
		default:
			minus_idx = T_STEP_10HZ_IDX;	// use 10 Hz as small step size
			plus_idx = T_STEP_10KHZ_IDX;	// use 10 kHz as large step size
			break;
	}

	if(!is_up)	{		// temporary decrease of step size
		ts.tune_step = STEP_PRESS_MINUS;
		ts.tune_step_idx_holder = df.selected_idx;
		if(df.selected_idx)
		df.tuning_step	= tune_steps[minus_idx];
		df.selected_idx = minus_idx;
	}
	else	{			// temporary increase of step size
		ts.tune_step = STEP_PRESS_PLUS;
		ts.tune_step_idx_holder = df.selected_idx;
		df.tuning_step	= tune_steps[plus_idx];
		df.selected_idx = plus_idx;
	}
	//
	UiDriverShowStep(df.selected_idx);		// update display
}
//
//*----------------------------------------------------------------------------
//* Function Name       : UiDriverProcessActiveFilterScan
//* Object              : verify that currently-selected filter is active and if not, select
//* Object              : next active filter
//* Input Parameters    :
//* Output Parameters   :
//* Functions called    :
//*----------------------------------------------------------------------------
static void UiDriverProcessActiveFilterScan(void)
{
uchar filter_scan = 0;

bool	voice_mode, select_10k, select_3k6;

	//
	// Scan through filters to determine if the selected filter is disabled - and skip if it is.
	// NOTE:  The 2.3 kHz filter CANNOT be disabled
	//
	// This also handles filters that are disabled according to mode (e.g. CW filters in SSB mode, SSB filters in CW mode)
	//

	if((ts.dmod_mode == DEMOD_USB) || (ts.dmod_mode == DEMOD_LSB) || (ts.dmod_mode == DEMOD_AM))	// check to see if we are set to a "voice" mode
		voice_mode = 1;
	else					// not in voice mode
		voice_mode = 0;

	if((ts.filter_wide_select >= WIDE_FILTER_10K) || (ts.dmod_mode == DEMOD_AM))	// is 10k filter to be enabled?
		select_10k = 1;				// yes - and it should always be available in AM mode
	else
		select_10k = 0;				// it is not to be enabled

	if((ts.filter_3k6_select) || (ts.dmod_mode == DEMOD_AM))	// is 3.6k filter to be enabled?
		select_3k6 = 1;				// yes - and it should always be available in AM mode
	else
		select_3k6 = 0;				// it is not to be enabled


	first_filter:
		//
		if((ts.filter_id == AUDIO_300HZ) && (!ts.filter_300Hz_select))
			ts.filter_id++;
		//
		if((ts.filter_id == AUDIO_300HZ) && ((ts.filter_ssb_narrow_disable) && (voice_mode)))
			ts.filter_id++;
		//
		if((ts.filter_id == AUDIO_500HZ) && (!ts.filter_500Hz_select))
			ts.filter_id++;
		//
		if((ts.filter_id == AUDIO_500HZ) && ((ts.filter_ssb_narrow_disable) && (voice_mode)))
			ts.filter_id++;
		//
		if((ts.filter_id == AUDIO_1P8KHZ) && (!ts.filter_1k8_select))
			ts.filter_id++;
		//
		// At this point we would hit the 2.3 kHz filter, which is ALWAYS enabled!
		//
		if((ts.filter_id == AUDIO_3P6KHZ) && (!select_3k6))
			ts.filter_id++;
		//
		if(ts.filter_id == AUDIO_3P6KHZ && ((ts.filter_cw_wide_disable) && (ts.dmod_mode == DEMOD_CW)))
			ts.filter_id++;
		//
		if(((ts.filter_id == AUDIO_WIDE) && (!select_10k)) || ((ts.filter_id == AUDIO_WIDE) && (ts.dmod_mode == DEMOD_CW) && ts.filter_cw_wide_disable))	{
			ts.filter_id = AUDIO_MIN_FILTER;
			filter_scan++;
			if(filter_scan <= 1)	// Is this the first time here?
				goto first_filter;	// Yes - wrap around to find the other filters
			else	// second time around?
				ts.filter_id = AUDIO_2P3KHZ;	// Force selection of 2.3 kHz filter as all others are disabled
		}
}

//*----------------------------------------------------------------------------
//* Function Name       : UiDriverProcessFunctionKeyClick
//* Object              : process function buttons click
//* Object              : based on current demod mode
//* Input Parameters    :
//* Output Parameters   :
//* Functions called    :
//*----------------------------------------------------------------------------
static void UiDriverProcessFunctionKeyClick(ulong id)
{
	static bool is_last_menu_item = 0;
	//printf("button: %02x\n\r",id);

	// --------------------------------------------
	// F1 process
	if(id == BUTTON_F1_PRESSED)
	{
		if(!ts.mem_disp)	{			// allow only if NOT in memory display mode
			if(!ts.menu_mode)	{	// go into menu mode if NOT already in menu mode
				ts.menu_mode = 1;
				is_last_menu_item = 0;	// clear last screen detect flag
				UiDriverClearSpectrumDisplay();
				UiLcdHy28_PrintText(POS_BOTTOM_BAR_F1_X,POS_BOTTOM_BAR_F1_Y," EXIT  ",Yellow,Black,0);
				UiLcdHy28_PrintText(POS_BOTTOM_BAR_F2_X,POS_BOTTOM_BAR_F2_Y," DEFLT",Yellow,Black,0);
				UiLcdHy28_PrintText(POS_BOTTOM_BAR_F3_X,POS_BOTTOM_BAR_F3_Y,"  PREV",Yellow,Black,0);
				UiLcdHy28_PrintText(POS_BOTTOM_BAR_F4_X,POS_BOTTOM_BAR_F4_Y,"  NEXT",Yellow,Black,0);
				//
				//
				// Grey out adjustments and put encoders in known states
				//
				if(ts.dmod_mode == DEMOD_CW)
					UiDriverChangeStGain(0);
				else
					UiDriverChangeCmpLevel(0);
				//
				UiDriverChangeSigProc(0);
				UiDriverChangeRfGain(0);
				if(ts.dmod_mode == DEMOD_CW)
					UiDriverChangeKeyerSpeed(0);
				else
					UIDriverChangeAudioGain(0);
				//
				UiDriverChangeRit(0);
				//
				// Enable volume control when in MENU mode
				//
				UiDriverChangeAfGain(1);
				//
				ts.menu_var = 0;
				//
				UiDriverUpdateMenu(0);	// Draw the menu the first time
				UiDriverUpdateMenu(1);	// Do update of the first menu item
			}
			else	{	// already in menu mode - we now exit
				ts.menu_mode = 0;
				UiInitSpectrumScopeWaterfall();			// init spectrum scope
				//
				// Restore encoder displays to previous modes
				UiDriverChangeEncoderOneMode(0);
				UiDriverChangeEncoderTwoMode(0);
				UiDriverChangeEncoderThreeMode(0);
				// Call twice since the function TOGGLES, not just enables (need to fix this at some point!)
				UiDriverChangeEncoderOneMode(0);
				UiDriverChangeEncoderTwoMode(0);
				UiDriverChangeEncoderThreeMode(0);
				//
				if(!ts.menu_var_changed)
					UiLcdHy28_PrintText(POS_BOTTOM_BAR_F1_X,POS_BOTTOM_BAR_F1_Y," MENU  ",White,Black,0);
				else		// Asterisk indicates that a change has been made and that an EEPROM save should be done
					UiLcdHy28_PrintText(POS_BOTTOM_BAR_F1_X,POS_BOTTOM_BAR_F1_Y," MENU *",Orange,Black,0);
				//
				UiLcdHy28_PrintText(POS_BOTTOM_BAR_F2_X,POS_BOTTOM_BAR_F2_Y," METER",White,Black,0);
				/*
				switch(ts.tx_meter_mode)	{	// redraw button according to meter mode
				case METER_SWR:
					UiLcdHy28_PrintText(POS_BOTTOM_BAR_F2_X,POS_BOTTOM_BAR_F2_Y,"  SWR ",White,Black,0);
					break;
				case METER_ALC:
					UiLcdHy28_PrintText(POS_BOTTOM_BAR_F2_X,POS_BOTTOM_BAR_F2_Y,"  ALC ",White,Black,0);
					break;
				case METER_AUDIO:
					UiLcdHy28_PrintText(POS_BOTTOM_BAR_F2_X,POS_BOTTOM_BAR_F2_Y," AUDIO",White,Black,0);
					break;
				default:
					break;
				}
				*/
				//
				if(!ts.vfo_mem_flag)	{	// in normal VFO mode?
					if(ts.vfo_mem_mode & 0x80)	// SPLIT mode active?
						UiLcdHy28_PrintText(POS_BOTTOM_BAR_F3_X,POS_BOTTOM_BAR_F3_Y," SPLIT",SPLIT_ACTIVE_COLOUR,Black,0);	// yes - indicate with color
					else
						UiLcdHy28_PrintText(POS_BOTTOM_BAR_F3_X,POS_BOTTOM_BAR_F3_Y," SPLIT",SPLIT_INACTIVE_COLOUR,Black,0);		// not active - grey
				}
				else	{					// in memory mode
					UiLcdHy28_PrintText(POS_BOTTOM_BAR_F3_X,POS_BOTTOM_BAR_F3_Y,"  MEM ",White,Black,0);	// yes - indicate with color
				}
				//
				if(ts.vfo_mem_mode & 0x40)		// VFO B active?
					UiLcdHy28_PrintText(POS_BOTTOM_BAR_F4_X,POS_BOTTOM_BAR_F4_Y," VFO B",White,Black,0);	// VFO B active
				else
					UiLcdHy28_PrintText(POS_BOTTOM_BAR_F4_X,POS_BOTTOM_BAR_F4_Y," VFO A",White,Black,0);
			}
		}
	}

	// --------------------------------------------
	// F2 process
	if(id == BUTTON_F2_PRESSED)
	{
		//
		// If in MENU mode, this restores the DEFAULT setting
		//
		if(ts.menu_mode)	{		// Button F2 restores default setting of selected item
			UiDriverUpdateMenu(3);
			ts.menu_var_changed = 1;
		}
		else	{	// Not in MENU mode - select the METER mode
			ts.tx_meter_mode++;
			if(ts.tx_meter_mode >= METER_MAX)
				ts.tx_meter_mode = 0;
			//
			UiLcdHy28_PrintText(POS_BOTTOM_BAR_F2_X,POS_BOTTOM_BAR_F2_Y," METER",White,Black,0);
			//
			UiDriverDeleteSMeter();
			UiDriverCreateSMeter();	// redraw meter
		}
	}

	// --------------------------------------------
	// F3 process
	if(id == BUTTON_F3_PRESSED)	{
		//
		//
		if(ts.menu_mode)	{		// Previous screen
			is_last_menu_item = 0;	// clear last screen detect flag
			if(ts.menu_item < 6)	{	// are we less than one screen away from the beginning?
				if(!ts.radio_config_menu_enable)	// yes - config/adjust menu not enabled?
					ts.menu_item = MAX_MENU_ITEM-1;	// yes, go to last item in normal menu
				else
					ts.menu_item = (MAX_MENU_ITEM + MAX_RADIO_CONFIG_ITEMS)-1;	// move to the last config/adjustment menu item
			}
			else
				ts.menu_item -= 6;	// not less than 6, so we subtract!
			//
			ts.menu_var = 0;			// clear variable that is used to change a menu item
			UiDriverUpdateMenu(1);		// Update that menu item
		}
		else	{	// NOT menu mode
			if(!ts.vfo_mem_flag)	{		// update screen if in VFO (not memory) mode
				if(ts.vfo_mem_mode & 0x80)	{	// are we in SPLIT mode?
					ts.vfo_mem_mode &= 0x7f;	// yes - turn off MSB to turn off SPLIT
					UiDriverInitMainFreqDisplay();		// update the main frequency display to reflect the mode
					ts.refresh_freq_disp = 1;	// make frequency display refresh all digits
					UiDriverUpdateFrequency(1,1);	// force update of large digits
					ts.refresh_freq_disp = 0;	// disable refresh all digits flag
				}
				else if(!(ts.vfo_mem_mode & 0x80))	{	// are we NOT in SPLIT mode?
					ts.vfo_mem_mode |= 0x80;		// yes - turn on MSB to activate SPLIT
					UiDriverInitMainFreqDisplay();		//
					ts.refresh_freq_disp = 1;	// make frequency display refresh all digits
					UiDriverUpdateFrequency(1,3);	// force display of second (TX) VFO frequency
					UiDriverUpdateFrequency(1,2);	// force display of first (RX) VFO frequency
					ts.refresh_freq_disp = 0;	// disable refresh all digits flag
				}
			}
			else	{		// in memory mode
				UiDriverClearSpectrumDisplay();		// always clear displayclear display
				if(!ts.mem_disp)	{	// are we NOT in memory display mode at this moment?
					ts.mem_disp = 1;	// we are not - turn it on
				}
				else	{				// we are in memory display mode
					ts.mem_disp = 0;	// turn it off
					UiInitSpectrumScopeWaterfall();			// init spectrum scope
				}
			}
		}
	}

	// --------------------------------------------
	// F4 process
	if(id == BUTTON_F4_PRESSED)	{
		//
		if(ts.menu_mode)	{		// Next screen
			if(!ts.radio_config_menu_enable)	{	// Not in config/calibrate menu mode
				if(ts.menu_item == MAX_MENU_ITEM - 1)	{	// already at last item?
					is_last_menu_item = 0;				// make sure flag is clear
					ts.menu_item = 0;					// to to first item
				}
				else	{	// not at last item - go ahead
					ts.menu_item += 6;
					if(ts.menu_item >= MAX_MENU_ITEM - 1)	{	// were we at last item?
						if(!is_last_menu_item)	{	// have we NOT seen the last menu item flag before?
							ts.menu_item = MAX_MENU_ITEM - 1;	// set to last menu item
							is_last_menu_item = 1;		// set flag indicating that we are at last menu item
						}
						else	{	// last menu item flag was set
							ts.menu_item = 0;				// yes, wrap around
							is_last_menu_item = 0;				// clear flag
						}
					}
				}
			}
			else	{	// in calibrate/adjust menu mode
				if(ts.menu_item == (MAX_MENU_ITEM + MAX_RADIO_CONFIG_ITEMS-1))	{	// already at last item?
					is_last_menu_item = 0;				// make sure flag is clear
					ts.menu_item = 0;					// to to first item
				}
				else	{	// not at last item - go ahead
					ts.menu_item += 6;
					if(ts.menu_item >= (MAX_MENU_ITEM + MAX_RADIO_CONFIG_ITEMS-1))	{	// were we at last item?
						if(!is_last_menu_item)	{	// have we NOT seen the last menu item flag before?
							ts.menu_item = MAX_MENU_ITEM + MAX_RADIO_CONFIG_ITEMS-1;	// set to last menu item
							is_last_menu_item = 1;		// set flag indicating that we are at last menu item
						}
						else	{	// last menu item flag was set
							ts.menu_item = 0;				// yes, wrap around
							is_last_menu_item = 0;				// clear flag
						}
					}
				}
			}
			//
			ts.menu_var = 0;			// clear variable that is used to change a menu item
			UiDriverUpdateMenu(1);		// Update that menu item
		}
		else	{	// NOT menu mode
			if(ts.vfo_mem_mode & 0x40)		{	// LSB on VFO mode byte set?
				ts.vfo_mem_mode &= 0xbf;	// yes, it's now VFO-B mode, so clear it, setting it to VFO A mode
				band_dial_value_b[ts.band] = df.tune_old;	//band_dial_value[ts.band];		// save "VFO B" settings
				band_decod_mode_b[ts.band] = ts.dmod_mode;	//band_decod_mode[ts.band];
				band_filter_mode_b[ts.band] = ts.filter_id;	//band_filter_mode[ts.band];
				//
				band_dial_value[ts.band] = band_dial_value_a[ts.band];		// load "VFO A" settings into working registers
				band_decod_mode[ts.band] = band_decod_mode_a[ts.band];
				band_filter_mode[ts.band] = band_filter_mode_a[ts.band];
				//
				UiLcdHy28_PrintText(POS_BOTTOM_BAR_F4_X,POS_BOTTOM_BAR_F4_Y," VFO A",White,Black,0);
				//
			}
			else	{						// LSB on VFO mode byte NOT set?
				ts.vfo_mem_mode |= 0x40;			// yes, it's now in VFO-A mode, so set it, setting it to VFO B mode
				band_dial_value_a[ts.band] = df.tune_old;	//band_dial_value[ts.band];		// save "VFO A" settings
				band_decod_mode_a[ts.band] = ts.dmod_mode;	//band_decod_mode[ts.band];
				band_filter_mode_a[ts.band] = ts.filter_id;	//band_filter_mode[ts.band];
					//
				band_dial_value[ts.band] = band_dial_value_b[ts.band];		// load "VFO B" settings
				band_decod_mode[ts.band] = band_decod_mode_b[ts.band];
				band_filter_mode[ts.band] = band_filter_mode_b[ts.band];
				UiLcdHy28_PrintText(POS_BOTTOM_BAR_F4_X,POS_BOTTOM_BAR_F4_Y," VFO B",White,Black,0);
				//
			}
			df.tune_new = band_dial_value[ts.band];
			//
			// do frequency/display update
			if(ts.vfo_mem_mode & 0x80)	{	// in SPLIT mode?
				if(!(ts.vfo_mem_mode & 0x40))	{
					UiLcdHy28_PrintText(POS_TUNE_SPLIT_MARKER_X-(SMALL_FONT_WIDTH*5),POS_TUNE_FREQ_Y,"(A) RX->",RX_Grey,Black,0);	// Place identifying marker for RX frequency
					UiLcdHy28_PrintText(POS_TUNE_SPLIT_MARKER_X-(SMALL_FONT_WIDTH*5),POS_TUNE_SPLIT_FREQ_Y_TX,"(B) TX->",TX_Grey,Black,0);	// Place identifying marker for TX frequency
				}
				else	{
					UiLcdHy28_PrintText(POS_TUNE_SPLIT_MARKER_X-(SMALL_FONT_WIDTH*5),POS_TUNE_FREQ_Y,"(B) RX->",RX_Grey,Black,0);	// Place identifying marker for RX frequency
					UiLcdHy28_PrintText(POS_TUNE_SPLIT_MARKER_X-(SMALL_FONT_WIDTH*5),POS_TUNE_SPLIT_FREQ_Y_TX,"(A) TX->",TX_Grey,Black,0);	// Place identifying marker for TX frequency
				}
				//
				ts.refresh_freq_disp = 1;	// make frequency display refresh all digits
				UiDriverUpdateFrequency(1,3);	// force display of second (TX) VFO frequency - do this first so small display shows RX freq
				UiDriverUpdateFrequency(1,2);	// update RX frequency
				ts.refresh_freq_disp = 0;
			}
			else	// not in SPLIT mode - standard update
				UiDriverUpdateFrequency(1,0);

			// Change decode mode if need to
			if(ts.dmod_mode != band_decod_mode[ts.band])
			{
				// Update mode
				ts.dmod_mode = band_decod_mode[ts.band];

				// Update Decode Mode (USB/LSB/AM/FM/CW)
				UiDriverShowMode();
			}

			// Change filter mode if need to
			if(ts.filter_id != band_filter_mode[ts.band])
			{
				ts.filter_id = band_filter_mode[ts.band];
				UiDriverChangeFilter(0);	// update display and change filter
				UiDriverDisplayFilterBW();	// update on-screen filter bandwidth indicator
				audio_driver_set_rx_audio_filter();
				audio_driver_set_rx_audio_filter();	// we have to invoke the filter change several times for some unknown reason - 'dunno why!
			}
		}
		//
		//
	}

	// --------------------------------------------
	// F5 process
	if(id == BUTTON_F5_PRESSED)
	{
		if(!ts.tx_disable)	{	// Allow TUNE mode only if TX is NOT disabled
			// Toggle tune
			ts.tune = !ts.tune;

			if(ts.dmod_mode == DEMOD_AM)
				ts.tune = 0;	// no TUNE mode in AM!

			// Change button color
			if(ts.tune)
			{
				if((ts.dmod_mode == DEMOD_USB) || (ts.dmod_mode == DEMOD_LSB))
					softdds_setfreq(SSB_TUNE_FREQ, ts.samp_rate,0);		// generate tone for setting TX IQ phase
				// DDS on
				else
					softdds_setfreq(CW_SIDETONE_FREQ_DEFAULT,ts.samp_rate,0);

				// To TX
				ts.txrx_mode = TRX_MODE_TX;
				ui_driver_toggle_tx();				// tune

				UiLcdHy28_PrintText(POS_BOTTOM_BAR_F5_X,POS_BOTTOM_BAR_F5_Y,"  TUNE",Red,Black,0);
				//
			}
			else
			{
				if((ts.dmod_mode == DEMOD_USB) || (ts.dmod_mode == DEMOD_LSB))	// DDS off if voice mode
					softdds_setfreq(0.0,ts.samp_rate,0);
				else if(ts.dmod_mode == DEMOD_CW)	{	// DDS reset to proper sidetone freq. if CW mode
					cw_gen_init();
					softdds_setfreq((float)ts.sidetone_freq,ts.samp_rate,0);
				}
				//
				// Back to RX
				ts.txrx_mode = TRX_MODE_RX;
				ui_driver_toggle_tx();				// tune

				UiLcdHy28_PrintText(POS_BOTTOM_BAR_F5_X,POS_BOTTOM_BAR_F5_Y,"  TUNE",White,Black,0);
				//
			}
		}
	}
}

//*----------------------------------------------------------------------------
//* Function Name       : UiDriverShowMode
//* Object              :
//* Input Parameters    :
//* Output Parameters   :
//* Functions called    :
//*----------------------------------------------------------------------------
void UiDriverShowMode(void)	{
	// Clear control
	UiLcdHy28_DrawFullRect(POS_DEMOD_MODE_MASK_X,POS_DEMOD_MODE_MASK_Y,POS_DEMOD_MODE_MASK_H,POS_DEMOD_MODE_MASK_W,Blue);

	// Create Decode Mode (USB/LSB/AM/FM/CW)
	switch(ts.dmod_mode)
	{
		case DEMOD_USB:
			UiLcdHy28_PrintText((POS_DEMOD_MODE_X + 8),POS_DEMOD_MODE_Y,"USB",Cream,Blue,0);
			break;
		case DEMOD_LSB:
			UiLcdHy28_PrintText((POS_DEMOD_MODE_X + 8),POS_DEMOD_MODE_Y,"LSB",Cream,Blue,0);
			break;
		case DEMOD_AM:
			UiLcdHy28_PrintText((POS_DEMOD_MODE_X + 12),POS_DEMOD_MODE_Y,"AM",Cream,Blue,0);
			break;
		case DEMOD_CW:
			if(ts.cw_lsb)	// determine if CW is USB or LSB mode
				UiLcdHy28_PrintText((POS_DEMOD_MODE_X + 4),POS_DEMOD_MODE_Y,"CW-L",Cream,Blue,0);
			else
				UiLcdHy28_PrintText((POS_DEMOD_MODE_X + 4),POS_DEMOD_MODE_Y,"CW-U",Cream,Blue,0);
			break;
		default:
			break;
	}
}

//*----------------------------------------------------------------------------
//* Function Name       : UiDriverShowStep
//* Object              :
//* Input Parameters    :
//* Output Parameters   :
//* Functions called    :
//*----------------------------------------------------------------------------
void UiDriverShowStep(ulong step)
{

	ulong	line_loc;
	static	bool	step_line = 0;	// used to indicate the presence of a step line
	ulong	color;

	if(ts.tune_step)		// is this a "Temporary" step size from press-and-hold?
		color = Cyan;	// yes - display step size in Cyan
	else				// normal mode
		color = White;	// step size in white

	if(step_line)	{	// Remove underline indicating step size if one had been drawn
		UiLcdHy28_DrawStraightLine((POS_TUNE_FREQ_X + (LARGE_FONT_WIDTH * 3)),(POS_TUNE_FREQ_Y + 24),(LARGE_FONT_WIDTH*7),LCD_DIR_HORIZONTAL,Black);
		UiLcdHy28_DrawStraightLine((POS_TUNE_FREQ_X + (LARGE_FONT_WIDTH * 3)),(POS_TUNE_FREQ_Y + 25),(LARGE_FONT_WIDTH*7),LCD_DIR_HORIZONTAL,Black);
	}

	// Blank old step size
	UiLcdHy28_DrawFullRect(POS_TUNE_STEP_MASK_X,POS_TUNE_STEP_MASK_Y,POS_TUNE_STEP_MASK_H,POS_TUNE_STEP_MASK_W,Black);

	// Create Step Mode
	switch(df.tuning_step)
	{
		case T_STEP_1HZ:
			UiLcdHy28_PrintText((POS_TUNE_STEP_X + SMALL_FONT_WIDTH*3),POS_TUNE_STEP_Y,"1Hz",color,Black,0);
			line_loc = 9;
			break;
		case T_STEP_10HZ:
			line_loc = 8;
			UiLcdHy28_PrintText((POS_TUNE_STEP_X + SMALL_FONT_WIDTH*2),POS_TUNE_STEP_Y,"10Hz",color,Black,0);
			break;
		case T_STEP_100HZ:
			UiLcdHy28_PrintText((POS_TUNE_STEP_X + SMALL_FONT_WIDTH*1),POS_TUNE_STEP_Y,"100Hz",color,Black,0);
			line_loc = 7;
			break;
		case T_STEP_1KHZ:
			UiLcdHy28_PrintText((POS_TUNE_STEP_X + SMALL_FONT_WIDTH*2),POS_TUNE_STEP_Y,"1kHz",color,Black,0);
			line_loc = 5;
			break;
		case T_STEP_10KHZ:
			UiLcdHy28_PrintText((POS_TUNE_STEP_X + SMALL_FONT_WIDTH*1),POS_TUNE_STEP_Y,"10kHz",color,Black,0);
			line_loc = 4;
			break;
		case T_STEP_100KHZ:
			UiLcdHy28_PrintText((POS_TUNE_STEP_X + SMALL_FONT_WIDTH*0),POS_TUNE_STEP_Y,"100kHz",color,Black,0);
			line_loc = 3;
			break;
		case T_STEP_1MHZ:
			UiLcdHy28_PrintText((POS_TUNE_STEP_X + SMALL_FONT_WIDTH*0),POS_TUNE_STEP_Y,"1MHz",color,Black,0);
			line_loc = 3;
			break;
		case T_STEP_10MHZ:
			UiLcdHy28_PrintText((POS_TUNE_STEP_X + SMALL_FONT_WIDTH*0),POS_TUNE_STEP_Y,"10MHz",color,Black,0);
			line_loc = 3;
			break;
		default:
			break;
	}
	//
	if(ts.freq_step_config & 0x0f)	{		// is frequency step marker line enabled?
		UiLcdHy28_DrawStraightLine((POS_TUNE_FREQ_X + (LARGE_FONT_WIDTH * line_loc)),(POS_TUNE_FREQ_Y + 24),(LARGE_FONT_WIDTH),LCD_DIR_HORIZONTAL,White);
		UiLcdHy28_DrawStraightLine((POS_TUNE_FREQ_X + (LARGE_FONT_WIDTH * line_loc)),(POS_TUNE_FREQ_Y + 25),(LARGE_FONT_WIDTH),LCD_DIR_HORIZONTAL,White);
		step_line = 1;	// indicate that a line under the step size had been drawn
	}
	else	// marker line not enabled
		step_line = 0;	// we don't need to erase "step size" marker line in the future

}

//*----------------------------------------------------------------------------
//* Function Name       : UiDriverShowBand
//* Object              :
//* Input Parameters    :
//* Output Parameters   :
//* Functions called    :
//*----------------------------------------------------------------------------
static void UiDriverShowBand(uchar band)
{
	// Clear control
	UiLcdHy28_DrawFullRect(POS_BAND_MODE_MASK_X,POS_BAND_MODE_MASK_Y,POS_BAND_MODE_MASK_H,POS_BAND_MODE_MASK_W,Black);

	// Create Band value
	switch(band)
	{
		case BAND_MODE_80:
			UiLcdHy28_PrintText(POS_BAND_MODE_X,POS_BAND_MODE_Y,"80m",Orange,Black,0);
			break;

		case BAND_MODE_60:
			UiLcdHy28_PrintText(POS_BAND_MODE_X,POS_BAND_MODE_Y,"60m",Orange,Black,0);
			break;

		case BAND_MODE_40:
			UiLcdHy28_PrintText(POS_BAND_MODE_X,POS_BAND_MODE_Y,"40m",Orange,Black,0);
			break;

		case BAND_MODE_30:
			UiLcdHy28_PrintText(POS_BAND_MODE_X,POS_BAND_MODE_Y,"30m",Orange,Black,0);
			break;

		case BAND_MODE_20:
			UiLcdHy28_PrintText(POS_BAND_MODE_X,POS_BAND_MODE_Y,"20m",Orange,Black,0);
			break;

		case BAND_MODE_17:
			UiLcdHy28_PrintText(POS_BAND_MODE_X,POS_BAND_MODE_Y,"17m",Orange,Black,0);
			break;

		case BAND_MODE_15:
			UiLcdHy28_PrintText(POS_BAND_MODE_X,POS_BAND_MODE_Y,"15m",Orange,Black,0);
			break;

		case BAND_MODE_12:
			UiLcdHy28_PrintText(POS_BAND_MODE_X,POS_BAND_MODE_Y,"12m",Orange,Black,0);
			break;

		case BAND_MODE_10:
			UiLcdHy28_PrintText(POS_BAND_MODE_X,POS_BAND_MODE_Y,"10m",Orange,Black,0);
			break;

		case BAND_MODE_GEN:
			UiLcdHy28_PrintText(POS_BAND_MODE_X,POS_BAND_MODE_Y,"Gen",Orange,Black,0);
			break;

		default:
			break;
	}
}

// -------------------------------------------
// 	 BAND		BAND0		BAND1		BAND2
//
//	 80m		1			1			x
//	 40m		1			0			x
//	 20/30m		0			0			x
//	 15-10m		0			1			x
//
// -------------------------------------------
//
void UiDriverChangeBandFilter(uchar band,uchar bpf_only)
{
	if(bpf_only)
		goto do_bpf;

	// ---------------------------------------------
	// Set LPFs
	// Set relays in groups, internal first, then external group
	// state change via two pulses on BAND2 line, then idle
	switch(band)
	{
		case BAND_MODE_80:
		{
			// Internal group - Set(High/Low)
			BAND0_PIO->BSRRL = BAND0;
			BAND1_PIO->BSRRH = BAND1;

			// Pulse relays
			BAND2_PIO->BSRRH = BAND2;
			non_os_delay();
			BAND2_PIO->BSRRL = BAND2;

			// External group -Set(High/High)
			BAND0_PIO->BSRRL = BAND0;
			BAND1_PIO->BSRRL = BAND1;

			// Pulse relays
			BAND2_PIO->BSRRH = BAND2;
			non_os_delay();
			BAND2_PIO->BSRRL = BAND2;

			break;
		}

		case BAND_MODE_60:
		case BAND_MODE_40:
		{
			// Internal group - Set(High/Low)
			BAND0_PIO->BSRRL = BAND0;
			BAND1_PIO->BSRRH = BAND1;

			// Pulse relays
			BAND2_PIO->BSRRH = BAND2;
			non_os_delay();
			BAND2_PIO->BSRRL = BAND2;

			// External group - Reset(Low/High)
			BAND0_PIO->BSRRH = BAND0;
			BAND1_PIO->BSRRL = BAND1;

			// Pulse relays
			BAND2_PIO->BSRRH = BAND2;
			non_os_delay();
			BAND2_PIO->BSRRL = BAND2;

			break;
		}

		case BAND_MODE_30:
		case BAND_MODE_20:
		{
			// Internal group - Reset(Low/Low)
			BAND0_PIO->BSRRH = BAND0;
			BAND1_PIO->BSRRH = BAND1;

			// Pulse relays
			BAND2_PIO->BSRRH = BAND2;
			non_os_delay();
			BAND2_PIO->BSRRL = BAND2;

			// External group - Reset(Low/High)
			BAND0_PIO->BSRRH = BAND0;
			BAND1_PIO->BSRRL = BAND1;

			// Pulse relays
			BAND2_PIO->BSRRH = BAND2;
			non_os_delay();
			BAND2_PIO->BSRRL = BAND2;

			break;
		}

		case BAND_MODE_17:
		case BAND_MODE_15:
		case BAND_MODE_12:
		case BAND_MODE_10:
		{
			// Internal group - Reset(Low/Low)
			BAND0_PIO->BSRRH = BAND0;
			BAND1_PIO->BSRRH = BAND1;

			// Pulse relays
			BAND2_PIO->BSRRH = BAND2;
			non_os_delay();
			BAND2_PIO->BSRRL = BAND2;

			// External group - Set(High/High)
			BAND0_PIO->BSRRL = BAND0;
			BAND1_PIO->BSRRL = BAND1;

			// Pulse relays
			BAND2_PIO->BSRRH = BAND2;
			non_os_delay();
			BAND2_PIO->BSRRL = BAND2;

			break;
		}

		default:
			break;
	}

do_bpf:

	// ---------------------------------------------
	// Set BPFs
	// Constant line states for the BPF filter,
	// always last - after LPF change
	switch(band)
	{
		case BAND_MODE_80:
		{
			BAND0_PIO->BSRRL = BAND0;
			BAND1_PIO->BSRRL = BAND1;
			break;
		}

		case BAND_MODE_60:
		case BAND_MODE_40:
		{
			BAND0_PIO->BSRRL = BAND0;
			BAND1_PIO->BSRRH = BAND1;
			break;
		}

		case BAND_MODE_30:
		case BAND_MODE_20:
		{
			BAND0_PIO->BSRRH = BAND0;
			BAND1_PIO->BSRRH = BAND1;
			break;
		}

		case BAND_MODE_17:
		case BAND_MODE_15:
		case BAND_MODE_12:
		case BAND_MODE_10:
		{
			BAND0_PIO->BSRRH = BAND0;
			BAND1_PIO->BSRRL = BAND1;
			break;
		}

		default:
			break;
	}
}



//*----------------------------------------------------------------------------
//* Function Name       : UiDriverInitMainFreqDisplay
//* Object              :
//* Input Parameters    :
//* Output Parameters   :
//* Functions called    :
//*----------------------------------------------------------------------------
static void UiDriverInitMainFreqDisplay(void)
{
	if(!(ts.vfo_mem_mode & 0x80))	{	// are we in SPLIT mode?
		if(!ts.vfo_mem_flag)	{	// update bottom of screen if in VFO (not memory) mode
			UiLcdHy28_PrintText(POS_BOTTOM_BAR_F3_X,POS_BOTTOM_BAR_F3_Y," SPLIT",SPLIT_INACTIVE_COLOUR,Black,0);	// make SPLIT indicator grey to indicate off
		}
//		UiLcdHy28_PrintText(POS_TUNE_FREQ_X,POS_TUNE_FREQ_Y + 4,"          ",White,Black,1);	// clear area near frequency display
		UiLcdHy28_PrintText(POS_TUNE_FREQ_X,POS_TUNE_FREQ_Y,"  .   .   ",White,Black,1);	// clear frequency display and replace dots
	}
	else	{	// are we NOT in SPLIT mode?
		if(!ts.vfo_mem_flag)	{	// update bottom of screen if in VFO (not memory) mode
			UiLcdHy28_PrintText(POS_BOTTOM_BAR_F3_X,POS_BOTTOM_BAR_F3_Y," SPLIT",White,Black,0);	// make SPLIT indicator YELLOW to indicate on
		}
		UiLcdHy28_PrintText(POS_TUNE_FREQ_X,POS_TUNE_FREQ_Y,"          ",White,Black,1);	// clear large frequency digits
		UiLcdHy28_PrintText(POS_TUNE_SPLIT_FREQ_X,POS_TUNE_FREQ_Y,"  .   .   ",White,Black,0);	// clear frequency display and replace dots for RX freq
		UiLcdHy28_PrintText(POS_TUNE_SPLIT_FREQ_X,POS_TUNE_SPLIT_FREQ_Y_TX,"  .   .   ",White,Black,0);	// clear frequency display and replace dots for TX freq
		if(!(ts.vfo_mem_mode & 0x40))	{
			UiLcdHy28_PrintText(POS_TUNE_SPLIT_MARKER_X-(SMALL_FONT_WIDTH*5),POS_TUNE_FREQ_Y,"(A) RX->",RX_Grey,Black,0);	// Place identifying marker for RX frequency
			UiLcdHy28_PrintText(POS_TUNE_SPLIT_MARKER_X-(SMALL_FONT_WIDTH*5),POS_TUNE_SPLIT_FREQ_Y_TX,"(B) TX->",TX_Grey,Black,0);	// Place identifying marker for TX frequency
		}
		else	{
			UiLcdHy28_PrintText(POS_TUNE_SPLIT_MARKER_X-(SMALL_FONT_WIDTH*5),POS_TUNE_FREQ_Y,"(B) RX->",RX_Grey,Black,0);	// Place identifying marker for RX frequency
			UiLcdHy28_PrintText(POS_TUNE_SPLIT_MARKER_X-(SMALL_FONT_WIDTH*5),POS_TUNE_SPLIT_FREQ_Y_TX,"(A) TX->",TX_Grey,Black,0);	// Place identifying marker for TX frequency
		}
	}
}

//*----------------------------------------------------------------------------
//* Function Name       : UiDriverCreateDesktop
//* Object              :
//* Input Parameters    :
//* Output Parameters   :
//* Functions called    :
//*----------------------------------------------------------------------------
static void UiDriverCreateDesktop(void)
{
	//char temp[10];

	// Backlight off - hide startup logo
	LCD_BACKLIGHT_PIO->BSRRH = LCD_BACKLIGHT;

	// Clear display
	UiLcdHy28_LcdClear(Black);

	// Create Band value
	UiDriverShowBand(ts.band);

	// Set filters
	UiDriverChangeBandFilter(ts.band,0);

	// Create Decode Mode (USB/LSB/AM/FM/CW)
	UiDriverShowMode();

	// Create Step Mode
	UiDriverShowStep(df.tuning_step);

	// Frequency
	UiDriverInitMainFreqDisplay();

	// Second Frequency
	UiLcdHy28_PrintText(POS_TUNE_SFREQ_X,POS_TUNE_SFREQ_Y,"00.000.00 ",Grey,Black,0);	// clear area of display, placing decimal points

	// Function buttons
	UiDriverCreateFunctionButtons(true);

	// S-meter
	UiDriverCreateSMeter();

	// Spectrum scope
	UiInitSpectrumScopeWaterfall();
//	UiDriverCreateSpectrumScope();
//	UiDriverInitSpectrumDisplay();

	// -----------------
	// Encoder one modes
	// -----------------
	//  Audio gain
	UiDriverChangeAfGain(1);
	//
	if(ts.dmod_mode == DEMOD_CW)
		UiDriverChangeStGain(0);
	else
		UiDriverChangeCmpLevel(0);
	//

	// -----------------
	// Encoder two modes
	// -----------------
	// RF gain
	UiDriverChangeRfGain(1);
	// RF Attenuator
	UiDriverChangeSigProc(0);

	// -----------------
	// Encoder three modes
	// -----------------
	// RIT
	UiDriverChangeRit(1);
	//
	if(ts.dmod_mode == DEMOD_CW)
		UiDriverChangeKeyerSpeed(0);
	else
		UIDriverChangeAudioGain(0);
	//
	cw_gen_init();

	// DSP mode change
	UiDriverChangeDSPMode();

	// Power level
	UiDriverChangePowerLevel();

	// FIR via keypad, not encoder mode
	UiDriverChangeFilter(1);

	UiDriverDisplayFilterBW();	// update on-screen filter bandwidth indicator

	// Create USB Keyboard indicator
	//UiLcdHy28_PrintText(POS_KBD_IND_X,POS_KBD_IND_Y,"KBD",Grey,Black,0);

	// Create RX/TX indicator
	//UiLcdHy28_PrintText(POS_TX_IND_X,POS_TX_IND_Y,	"RX", Green,Black,0);

	// Create voltage
	UiLcdHy28_DrawStraightLine	(POS_PWRN_IND_X,(POS_PWRN_IND_Y - 1),56,LCD_DIR_HORIZONTAL,Grey);
	UiLcdHy28_PrintText			(POS_PWRN_IND_X, POS_PWRN_IND_Y,"  VCC  ", Grey, 	Blue, 0);
	UiLcdHy28_PrintText			(POS_PWR_IND_X,POS_PWR_IND_Y,   "12.00V",  COL_PWR_IND,Black,0);

	// Create temperature
	if((lo.sensor_present == 0) && (df.temp_enabled & 0x0f))
		UiDriverCreateTemperatureDisplay(1,1);
	else
		UiDriverCreateTemperatureDisplay(0,1);

	// Set correct frequency
	//UiDriverUpdateFrequency(1,0);
	ts.refresh_freq_disp = 1;	// make frequency display refresh all digits
	//
	if(!(ts.vfo_mem_mode & 0x80))	{	// are we in SPLIT mode?
		UiDriverUpdateFrequency(1,1);	// yes - force update of large digits
	}
	else	{	// are we in SPLIT mode?
		UiDriverUpdateFrequency(1,3);	// yes - force display of second (TX) VFO frequency
		UiDriverUpdateFrequency(1,2);	// force display of first (RX) VFO frequency
	}
	//
	ts.refresh_freq_disp = 0;	// disable refresh all digits flag
	// Backlight on - only when all is drawn
	LCD_BACKLIGHT_PIO->BSRRL = LCD_BACKLIGHT;
}

//*----------------------------------------------------------------------------
//* Function Name       : UiDriverCreateFunctionButtons
//* Object              : function keys based on decoder mode
//* Input Parameters    :
//* Output Parameters   :
//* Functions called    :
//*----------------------------------------------------------------------------
static void UiDriverCreateFunctionButtons(bool full_repaint)
{
	char cap1[20],cap2[20],cap3[20],cap4[20],cap5[20];
	ulong	clr;

	// Create bottom bar
	if(full_repaint)
	{
		UiLcdHy28_DrawBottomButton((POS_BOTTOM_BAR_X +                             0),(POS_BOTTOM_BAR_Y - 4),POS_BOTTOM_BAR_BUTTON_H,POS_BOTTOM_BAR_BUTTON_W,Grey);
		UiLcdHy28_DrawBottomButton((POS_BOTTOM_BAR_X + POS_BOTTOM_BAR_BUTTON_W*1 + 2),(POS_BOTTOM_BAR_Y - 4),POS_BOTTOM_BAR_BUTTON_H,POS_BOTTOM_BAR_BUTTON_W,Grey);
		UiLcdHy28_DrawBottomButton((POS_BOTTOM_BAR_X + POS_BOTTOM_BAR_BUTTON_W*2 + 4),(POS_BOTTOM_BAR_Y - 4),POS_BOTTOM_BAR_BUTTON_H,POS_BOTTOM_BAR_BUTTON_W,Grey);
		UiLcdHy28_DrawBottomButton((POS_BOTTOM_BAR_X + POS_BOTTOM_BAR_BUTTON_W*3 + 6),(POS_BOTTOM_BAR_Y - 4),POS_BOTTOM_BAR_BUTTON_H,POS_BOTTOM_BAR_BUTTON_W,Grey);
		UiLcdHy28_DrawBottomButton((POS_BOTTOM_BAR_X + POS_BOTTOM_BAR_BUTTON_W*4 + 8),(POS_BOTTOM_BAR_Y - 4),POS_BOTTOM_BAR_BUTTON_H,(POS_BOTTOM_BAR_BUTTON_W + 1),Grey);
	}

	strcpy(cap1,"  MENU");
	strcpy(cap2," METER");
	strcpy(cap3," SPLIT");
	if(ts.vfo_mem_mode & 0x40)		// VFO B mode?
		strcpy(cap4," VFO B");	// yes - indicate
	else
		strcpy(cap4," VFO A");	// VFO A mode otherwise
	strcpy(cap5,"  TUNE");
	//

	// Draw buttons text
	UiLcdHy28_PrintText(POS_BOTTOM_BAR_F1_X,POS_BOTTOM_BAR_F1_Y,cap1,White,Black,0);
	UiLcdHy28_PrintText(POS_BOTTOM_BAR_F2_X,POS_BOTTOM_BAR_F2_Y,cap2,White,Black,0);

	if(!ts.vfo_mem_flag)	{	// is it in VFO (not memory) mode?
		if(ts.vfo_mem_mode & 0x80)	// SPLIT mode active?
			UiLcdHy28_PrintText(POS_BOTTOM_BAR_F3_X,POS_BOTTOM_BAR_F3_Y,cap3,SPLIT_ACTIVE_COLOUR,Black,0);		// yes - make yellow
		else
			UiLcdHy28_PrintText(POS_BOTTOM_BAR_F3_X,POS_BOTTOM_BAR_F3_Y,cap3,SPLIT_INACTIVE_COLOUR,Black,0);		// SPLIT mode not active - grey
	}
	else	{	// it is in memory mode (not VFO) mode
		strcpy(cap3,"  MEM ");
		UiLcdHy28_PrintText(POS_BOTTOM_BAR_F3_X,POS_BOTTOM_BAR_F3_Y,cap3,White,Black,0);		// yes - make yellow
	}

	UiLcdHy28_PrintText(POS_BOTTOM_BAR_F4_X,POS_BOTTOM_BAR_F4_Y,cap4,White,Black,0);
	//
	if(ts.tx_disable)	// is transmit disabled?
		clr = Grey1;	// Yes - make TUNE button gray
	else
		clr = White;	// Not disabled, it is white

	UiLcdHy28_PrintText(POS_BOTTOM_BAR_F5_X,POS_BOTTOM_BAR_F5_Y,cap5,clr,Black,0);
}

//*----------------------------------------------------------------------------
//* Function Name       : UiDriverDrawWhiteSMeter
//* Object              : draw the white part of the S meter to clear the red S-meter (below)
//* Input Parameters    :
//* Output Parameters   :
//* Functions called    :
//*----------------------------------------------------------------------------
static void UiDriverDrawWhiteSMeter(void)
{
	uchar 	i,v_s;

// Draw top line
	UiLcdHy28_DrawStraightLine((POS_SM_IND_X +  18),(POS_SM_IND_Y + 20),92,LCD_DIR_HORIZONTAL,White);
	UiLcdHy28_DrawStraightLine((POS_SM_IND_X +  18),(POS_SM_IND_Y + 21),92,LCD_DIR_HORIZONTAL,White);

	// Draw s markers on top white line
	for(i = 0; i < 10; i++)
	{
		// Draw s text, only odd numbers
		if(i%2)
		{
			v_s = 5;
		}
		else
			v_s = 3;

		// Lines
		UiLcdHy28_DrawStraightLine(((POS_SM_IND_X + 18) + i*10),((POS_SM_IND_Y + 20) - v_s),v_s,LCD_DIR_VERTICAL,White);
		UiLcdHy28_DrawStraightLine(((POS_SM_IND_X + 19) + i*10),((POS_SM_IND_Y + 20) - v_s),v_s,LCD_DIR_VERTICAL,White);
	}
}
//
//*----------------------------------------------------------------------------
//* Function Name       : UiDriverDrawRedSMeter
//* Object              : draw the part of the S meter in red to indicate A/D overload
//* Input Parameters    :
//* Output Parameters   :
//* Functions called    :
//*----------------------------------------------------------------------------
static void UiDriverDrawRedSMeter(void)
{
	uchar 	i,v_s;

// Draw top line
	UiLcdHy28_DrawStraightLine((POS_SM_IND_X +  18),(POS_SM_IND_Y + 20),92,LCD_DIR_HORIZONTAL,Red);
	UiLcdHy28_DrawStraightLine((POS_SM_IND_X +  18),(POS_SM_IND_Y + 21),92,LCD_DIR_HORIZONTAL,Red);

	// Draw s markers on top white line
	for(i = 0; i < 10; i++)
	{

		// Draw s text, only odd numbers
		if(i%2)
		{
			v_s = 5;
		}
		else
			v_s = 3;

		// Lines
		UiLcdHy28_DrawStraightLine(((POS_SM_IND_X + 18) + i*10),((POS_SM_IND_Y + 20) - v_s),v_s,LCD_DIR_VERTICAL,Red);
		UiLcdHy28_DrawStraightLine(((POS_SM_IND_X + 19) + i*10),((POS_SM_IND_Y + 20) - v_s),v_s,LCD_DIR_VERTICAL,Red);
	}
}
//


//*----------------------------------------------------------------------------
//* Function Name       : UiDriverDeleteSMeter
//* Object              : delete the S meter
//* Input Parameters    :
//* Output Parameters   :
//* Functions called    :
//*----------------------------------------------------------------------------
static void UiDriverDeleteSMeter(void)
{
	ulong i;

	for(i = POS_SM_IND_Y; i < POS_SM_IND_Y + 72; i+=8)	{	// Y coordinate of blanking line
		UiLcdHy28_PrintText(POS_SM_IND_X + 6,((POS_SM_IND_Y + 5) +  i),"                                ",  White,Black,4);
	}
}

//
//*----------------------------------------------------------------------------
//* Function Name       : UiDriverCreateSMeter
//* Object              : draw the S meter
//* Input Parameters    :
//* Output Parameters   :
//* Functions called    :
//*----------------------------------------------------------------------------
static void UiDriverCreateSMeter(void)
{
	uchar 	i,v_s;
	char	num[20];
	int		col;

	// W/H ratio ~ 3.5
	UiLcdHy28_DrawEmptyRect(POS_SM_IND_X,POS_SM_IND_Y,72,202,Grey);

	// Draw top line
	UiLcdHy28_DrawStraightLine((POS_SM_IND_X +  18),(POS_SM_IND_Y + 20),92,LCD_DIR_HORIZONTAL,White);
	UiLcdHy28_DrawStraightLine((POS_SM_IND_X +  18),(POS_SM_IND_Y + 21),92,LCD_DIR_HORIZONTAL,White);
	UiLcdHy28_DrawStraightLine((POS_SM_IND_X + 113),(POS_SM_IND_Y + 20),75,LCD_DIR_HORIZONTAL,Green);
	UiLcdHy28_DrawStraightLine((POS_SM_IND_X + 113),(POS_SM_IND_Y + 21),75,LCD_DIR_HORIZONTAL,Green);

	// Leading text
	UiLcdHy28_PrintText(((POS_SM_IND_X + 18) - 12),(POS_SM_IND_Y +  5),"S",  White,Black,4);
	UiLcdHy28_PrintText(((POS_SM_IND_X + 18) - 12),(POS_SM_IND_Y + 36),"P",  White,Black,4);

	// Trailing text
	UiLcdHy28_PrintText((POS_SM_IND_X + 185),(POS_SM_IND_Y + 5), "dB",Green,Black,4);
	UiLcdHy28_PrintText((POS_SM_IND_X + 185),(POS_SM_IND_Y + 36)," W",White,Black,4);

	// Draw s markers on top white line
	for(i = 0; i < 10; i++)
	{
		num[0] = i + 0x30;
		num[1] = 0;

		// Draw s text, only odd numbers
		if(i%2)
		{
			UiLcdHy28_PrintText(((POS_SM_IND_X + 18) - 4 + i*10),(POS_SM_IND_Y + 5),num,White,Black,4);
			v_s = 5;
		}
		else
			v_s = 3;

		// Lines
		UiLcdHy28_DrawStraightLine(((POS_SM_IND_X + 18) + i*10),((POS_SM_IND_Y + 20) - v_s),v_s,LCD_DIR_VERTICAL,White);
		UiLcdHy28_DrawStraightLine(((POS_SM_IND_X + 19) + i*10),((POS_SM_IND_Y + 20) - v_s),v_s,LCD_DIR_VERTICAL,White);
	}

	// Draw s markers on top green line
	for(i = 0; i < 4; i++)
	{
		// Prepare text
		num[0] = i*2 + 0x30;
		num[1] = 0x30;
		num[2] = 0x00;

		if(i)
		{
			// Draw text
			UiLcdHy28_PrintText(((POS_SM_IND_X + 113) - 6 + i*20),(POS_SM_IND_Y + 5),num,Green,Black,4);

			// Draw vert lines
			UiLcdHy28_DrawStraightLine(((POS_SM_IND_X + 113) + i*20),(POS_SM_IND_Y + 15),5,LCD_DIR_VERTICAL,Green);
			UiLcdHy28_DrawStraightLine(((POS_SM_IND_X + 114) + i*20),(POS_SM_IND_Y + 15),5,LCD_DIR_VERTICAL,Green);
		}
	}

	// Draw middle line
	UiLcdHy28_DrawStraightLine((POS_SM_IND_X + 18),(POS_SM_IND_Y + 32),170,LCD_DIR_HORIZONTAL,White);
	UiLcdHy28_DrawStraightLine((POS_SM_IND_X + 18),(POS_SM_IND_Y + 33),170,LCD_DIR_HORIZONTAL,White);

	// Draw s markers on middle white line
	for(i = 0; i < 12; i++)
	{
		if(i < 10)
		{
			num[0] = i + 0x30;
			num[1] = 0;
		}
		else
		{
			num[0] = i/10 + 0x30;
			num[1] = i%10 + 0x30;
			num[2] = 0;
		}

		// Draw s text, only odd numbers
		if(!(i%2))
		{
			// Text
			UiLcdHy28_PrintText(((POS_SM_IND_X + 18) - 3 + i*15),(POS_SM_IND_Y + 36),num,White,Black,4);

			// Lines
			if(i)
			{
				UiLcdHy28_DrawStraightLine(((POS_SM_IND_X + 18) + i*15),((POS_SM_IND_Y + 32) - 2),2,LCD_DIR_VERTICAL,White);
				UiLcdHy28_DrawStraightLine(((POS_SM_IND_X + 19) + i*15),((POS_SM_IND_Y + 32) - 2),2,LCD_DIR_VERTICAL,White);
			}
			else
			{
				UiLcdHy28_DrawStraightLine(((POS_SM_IND_X + 18) + i*15),((POS_SM_IND_Y + 32) - 7),7,LCD_DIR_VERTICAL,White);
				UiLcdHy28_DrawStraightLine(((POS_SM_IND_X + 19) + i*15),((POS_SM_IND_Y + 32) - 7),7,LCD_DIR_VERTICAL,White);
			}
		}
	}


	if(ts.tx_meter_mode == METER_SWR)	{
		UiLcdHy28_PrintText(((POS_SM_IND_X + 18) - 12),(POS_SM_IND_Y + 59),"SWR",Red2,Black,4);

		// Draw bottom line for SWR indicator
		UiLcdHy28_DrawStraightLine((POS_SM_IND_X + 18),(POS_SM_IND_Y + 55), 62,LCD_DIR_HORIZONTAL,White);
		UiLcdHy28_DrawStraightLine((POS_SM_IND_X + 18),(POS_SM_IND_Y + 56), 62,LCD_DIR_HORIZONTAL,White);
		UiLcdHy28_DrawStraightLine((POS_SM_IND_X + 83),(POS_SM_IND_Y + 55),105,LCD_DIR_HORIZONTAL,Red);
		UiLcdHy28_DrawStraightLine((POS_SM_IND_X + 83),(POS_SM_IND_Y + 56),105,LCD_DIR_HORIZONTAL,Red);
		col = White;

		// Draw S markers on middle white line
		for(i = 0; i < 12; i++)
		{
			if(i > 6) col = Red;

			if(!(i%2))
			{
				if(i)
				{
					num[0] = i/2 + 0x30;
					num[1] = 0;

					// Text
					UiLcdHy28_PrintText(((POS_SM_IND_X + 18) - 3 + i*10),(POS_SM_IND_Y + 59),num,White,Black,4);

					UiLcdHy28_DrawStraightLine(((POS_SM_IND_X + 18) + i*10),((POS_SM_IND_Y + 55) - 2),2,LCD_DIR_VERTICAL,col);
					UiLcdHy28_DrawStraightLine(((POS_SM_IND_X + 19) + i*10),((POS_SM_IND_Y + 55) - 2),2,LCD_DIR_VERTICAL,col);
				}
				else
				{
					UiLcdHy28_DrawStraightLine(((POS_SM_IND_X + 18) + i*10),((POS_SM_IND_Y + 55) - 7),7,LCD_DIR_VERTICAL,col);
					UiLcdHy28_DrawStraightLine(((POS_SM_IND_X + 19) + i*10),((POS_SM_IND_Y + 55) - 7),7,LCD_DIR_VERTICAL,col);
				}
			}
		}
	}
	else if(ts.tx_meter_mode == METER_ALC)	{
		UiLcdHy28_PrintText(((POS_SM_IND_X + 18) - 12),(POS_SM_IND_Y + 59),"ALC",Yellow,Black,4);

		// Draw bottom line for SWR indicator
//		UiLcdHy28_DrawStraightLine((POS_SM_IND_X + 18),(POS_SM_IND_Y + 55), 108,LCD_DIR_HORIZONTAL,White);
//		UiLcdHy28_DrawStraightLine((POS_SM_IND_X + 18),(POS_SM_IND_Y + 56), 108,LCD_DIR_HORIZONTAL,White);
//		UiLcdHy28_DrawStraightLine((POS_SM_IND_X + 129),(POS_SM_IND_Y + 55),59,LCD_DIR_HORIZONTAL,Red);
//		UiLcdHy28_DrawStraightLine((POS_SM_IND_X + 129),(POS_SM_IND_Y + 56),59,LCD_DIR_HORIZONTAL,Red);

		UiLcdHy28_DrawStraightLine((POS_SM_IND_X + 18),(POS_SM_IND_Y + 55), 62,LCD_DIR_HORIZONTAL,White);
		UiLcdHy28_DrawStraightLine((POS_SM_IND_X + 18),(POS_SM_IND_Y + 56), 62,LCD_DIR_HORIZONTAL,White);
		UiLcdHy28_DrawStraightLine((POS_SM_IND_X + 83),(POS_SM_IND_Y + 55),105,LCD_DIR_HORIZONTAL,Red);
		UiLcdHy28_DrawStraightLine((POS_SM_IND_X + 83),(POS_SM_IND_Y + 56),105,LCD_DIR_HORIZONTAL,Red);

		col = White;

		// Draw markers on middle line
		for(i = 0; i < 17; i++)
		{
			if(i > 6) col = Red;
			if(!(i%2))
			{
				if(i)
				{
					sprintf(num,"%d",(i*2));
					// Text
					UiLcdHy28_PrintText(((POS_SM_IND_X + 18) - 3 + i*10),(POS_SM_IND_Y + 59),num,White,Black,4);

					UiLcdHy28_DrawStraightLine(((POS_SM_IND_X + 18) + i*10),((POS_SM_IND_Y + 55) - 2),2,LCD_DIR_VERTICAL,col);
					UiLcdHy28_DrawStraightLine(((POS_SM_IND_X + 19) + i*10),((POS_SM_IND_Y + 55) - 2),2,LCD_DIR_VERTICAL,col);
				}
				else
				{
					UiLcdHy28_DrawStraightLine(((POS_SM_IND_X + 18) + i*10),((POS_SM_IND_Y + 55) - 7),7,LCD_DIR_VERTICAL,col);
					UiLcdHy28_DrawStraightLine(((POS_SM_IND_X + 19) + i*10),((POS_SM_IND_Y + 55) - 7),7,LCD_DIR_VERTICAL,col);
				}
			}
		}
	}
	else if(ts.tx_meter_mode == METER_AUDIO)	{
		UiLcdHy28_PrintText(((POS_SM_IND_X + 18) - 12),(POS_SM_IND_Y + 59),"AUD",Cyan,Black,4);

		// Draw bottom line for SWR indicator
		UiLcdHy28_DrawStraightLine((POS_SM_IND_X + 18),(POS_SM_IND_Y + 55), 108,LCD_DIR_HORIZONTAL,White);
		UiLcdHy28_DrawStraightLine((POS_SM_IND_X + 18),(POS_SM_IND_Y + 56), 108,LCD_DIR_HORIZONTAL,White);
		UiLcdHy28_DrawStraightLine((POS_SM_IND_X + 129),(POS_SM_IND_Y + 55),59,LCD_DIR_HORIZONTAL,Red);
		UiLcdHy28_DrawStraightLine((POS_SM_IND_X + 129),(POS_SM_IND_Y + 56),59,LCD_DIR_HORIZONTAL,Red);
		col = White;

		// Draw markers on middle line
		for(i = 0; i < 17; i++)
		{
			if(i > 10) col = Red;
			if(!(i%2))
			{
				if(i)
				{
					sprintf(num,"%d",(i*2)-20);
					// Text
					UiLcdHy28_PrintText(((POS_SM_IND_X + 18) - 3 + i*10),(POS_SM_IND_Y + 59),num,White,Black,4);

					UiLcdHy28_DrawStraightLine(((POS_SM_IND_X + 18) + i*10),((POS_SM_IND_Y + 55) - 2),2,LCD_DIR_VERTICAL,col);
					UiLcdHy28_DrawStraightLine(((POS_SM_IND_X + 19) + i*10),((POS_SM_IND_Y + 55) - 2),2,LCD_DIR_VERTICAL,col);
				}
				else
				{
					UiLcdHy28_DrawStraightLine(((POS_SM_IND_X + 18) + i*10),((POS_SM_IND_Y + 55) - 7),7,LCD_DIR_VERTICAL,col);
					UiLcdHy28_DrawStraightLine(((POS_SM_IND_X + 19) + i*10),((POS_SM_IND_Y + 55) - 7),7,LCD_DIR_VERTICAL,col);
				}
			}
		}
	}
	// Draw meters
	UiDriverUpdateTopMeterA(0,0);
	UiDriverUpdateBtmMeter(0, 0);

}

//*----------------------------------------------------------------------------
//* Function Name       : UiDriverUpdateTopMeterA
//* Object              : redraw indicator, same like upper implementation
//* Input Parameters    : but no hold
//* Output Parameters   :
//* Functions called    :
//*----------------------------------------------------------------------------
static void UiDriverUpdateTopMeterA(uchar val,uchar old)
{
	uchar 	i,v_s;
	int		col = Blue2;


	// Do not waste time redrawing if outside of the range or if the meter has not changed
	if((val > 34) || (val == old))
		return;

	// Indicator height
	v_s = 3;

	// Draw first indicator
	for(i = 1; i < 34; i++)
	{
		if(val < i)
			col = Grid;

		// Lines
		UiLcdHy28_DrawStraightLine(((POS_SM_IND_X + 18) + i*5),((POS_SM_IND_Y + 28) - v_s),v_s,LCD_DIR_VERTICAL,col);
		UiLcdHy28_DrawStraightLine(((POS_SM_IND_X + 19) + i*5),((POS_SM_IND_Y + 28) - v_s),v_s,LCD_DIR_VERTICAL,col);
		UiLcdHy28_DrawStraightLine(((POS_SM_IND_X + 20) + i*5),((POS_SM_IND_Y + 28) - v_s),v_s,LCD_DIR_VERTICAL,col);
	}
}

//*----------------------------------------------------------------------------
//* Function Name       : UiDriverUpdateBtmMeter
//* Object              : redraw indicator
//* Input Parameters    : val=indicated value, warn=red warning threshold
//* Output Parameters   :
//* Functions called    :
//*----------------------------------------------------------------------------
static void UiDriverUpdateBtmMeter(uchar val, uchar warn)
{
	uchar 	i,v_s;
	int		col = Cyan;

	// Do not waste time redrawing if outside of the range
	if(val > 34)
		return;

	// Indicator height
	v_s = 3;


	// Draw indicator
	for(i = 1; i < 34; i++)
	{
		if(val < i)
			col = Grid;
		else if((i >= warn) && warn)	// is level above "warning" color? (is "warn" is zero, disable warning)
			col = Red2;					// yes - display values above that color in red

		// Lines
		UiLcdHy28_DrawStraightLine(((POS_SM_IND_X + 18) + i*5),((POS_SM_IND_Y + 51) - v_s),v_s,LCD_DIR_VERTICAL,col);
		UiLcdHy28_DrawStraightLine(((POS_SM_IND_X + 19) + i*5),((POS_SM_IND_Y + 51) - v_s),v_s,LCD_DIR_VERTICAL,col);
		UiLcdHy28_DrawStraightLine(((POS_SM_IND_X + 20) + i*5),((POS_SM_IND_Y + 51) - v_s),v_s,LCD_DIR_VERTICAL,col);
	}
}


//
//*----------------------------------------------------------------------------
//* Function Name       : UiDrawSpectrumScopeFrequencyBarText
//* Object              : Draw the frequency information on the frequency bar at the bottom of the spectrum scope based on the current frequency
//* Input Parameters    :
//* Output Parameters   :
//* Functions called    :
//*----------------------------------------------------------------------------
void UiDrawSpectrumScopeFrequencyBarText(void)
{
	ulong	freq_calc;
	ulong	i, clr;
	char	txt[16], *c;
	ulong	grat;

	if(ts.scope_scale_colour == SPEC_BLACK)		// don't bother updating frequency scale if it is black (invisible)!
		return;

	grat = 6;	// Default - Magnify mode OFF, graticules spaced 6 kHz
	//
	if(sd.magnify)			// magnify mode on - only available when NOT in translate mode
		grat = 3;	// graticules spaced 3 kHz

	//
	// This function draws the frequency bar at the bottom of the spectrum scope, putting markers every at every graticule and the full frequency
	// (rounded to the nearest kHz) in the "center".  (by KA7OEI, 20140913)
	//
	// get color for frequency scale
	//
	if(ts.scope_scale_colour == SPEC_GREY)
		clr = Grey;
	else if(ts.scope_scale_colour == SPEC_BLUE)
		clr = Blue;
	else if(ts.scope_scale_colour == SPEC_RED)
		clr = Red;
	else if(ts.scope_scale_colour == SPEC_MAGENTA)
		clr = Magenta;
	else if(ts.scope_scale_colour == SPEC_GREEN)
		clr = Green;
	else if(ts.scope_scale_colour == SPEC_CYAN)
		clr = Cyan;
	else if(ts.scope_scale_colour == SPEC_YELLOW)
		clr = Yellow;
	else if(ts.scope_scale_colour == SPEC_BLACK)
		clr = Black;
	else if(ts.scope_scale_colour == SPEC_ORANGE)
		clr = Orange;
	else
		clr = White;

	freq_calc = df.tune_new/4;		// get current frequency in Hz

	if(!sd.magnify)	{		// if magnify is off, way *may* have the graticule shifted.  (If it is on, it is NEVER shifted from center.)
		if(ts.iq_freq_mode == 1)			// Is "RX LO HIGH" translate mode active?
			freq_calc += FREQ_SHIFT_MAG;	// Yes, shift receive frequency to left of center
		else if(ts.iq_freq_mode == 2)		// it is "RX LO LOW" in translate mode
			freq_calc -= FREQ_SHIFT_MAG;	// shift receive frequency to right of center
	}
	freq_calc = (freq_calc + 500)/1000;	// round graticule frequency to the nearest kHz

	//

	if((ts.iq_freq_mode == 0) || (sd.magnify))	{	// Translate mode is OFF or magnify is on
		sprintf(txt, "  %u  ", (unsigned)freq_calc);	// build string for center frequency
		i = 130-((strlen(txt)-2)*4);	// calculate position of center frequency text
		UiLcdHy28_PrintText((POS_SPECTRUM_IND_X + i),(POS_SPECTRUM_IND_Y + POS_SPECTRUM_FREQ_BAR_Y),txt,clr,Black,4);

		sprintf(txt, " %u ", (unsigned)freq_calc-(unsigned)grat);	// build string for left-of-center frequency
		c = &txt[strlen(txt)-3];  // point at 2nd character from the end
		UiLcdHy28_PrintText((POS_SPECTRUM_IND_X +  90),(POS_SPECTRUM_IND_Y + POS_SPECTRUM_FREQ_BAR_Y),c,clr,Black,4);
		//

		sprintf(txt, " %u ", (unsigned)freq_calc+(unsigned)grat);	// build string for marker right of center
		c = &txt[strlen(txt)-3];  // point at 2nd character from the end
		UiLcdHy28_PrintText((POS_SPECTRUM_IND_X + 154),(POS_SPECTRUM_IND_Y + POS_SPECTRUM_FREQ_BAR_Y),c,clr,Black,4);
	}
	else if((ts.iq_freq_mode == 1) && (!sd.magnify))	{	// Translate mode is ON (LO is HIGH, center is left of middle of display) AND magnify is off
		sprintf(txt, "  %u  ", (unsigned)freq_calc-(unsigned)grat);	// build string for center frequency
		i = 94-((strlen(txt)-2)*4);	// calculate position of center frequency text
		UiLcdHy28_PrintText((POS_SPECTRUM_IND_X + i),(POS_SPECTRUM_IND_Y + POS_SPECTRUM_FREQ_BAR_Y),txt,clr,Black,4);

		sprintf(txt, " %u ", (unsigned)freq_calc);	// build string for center marker
		c = &txt[strlen(txt)-3];  // point at 2nd character from the end
		UiLcdHy28_PrintText((POS_SPECTRUM_IND_X +  122),(POS_SPECTRUM_IND_Y + POS_SPECTRUM_FREQ_BAR_Y),c,clr,Black,4);
		//
		sprintf(txt, " %u ", (unsigned)freq_calc+(unsigned)grat);	// build string for marker right of center
		c = &txt[strlen(txt)-3];  // point at 2nd character from the end
		UiLcdHy28_PrintText((POS_SPECTRUM_IND_X + 154),(POS_SPECTRUM_IND_Y + POS_SPECTRUM_FREQ_BAR_Y),c,clr,Black,4);
	}
	else if((ts.iq_freq_mode == 2) && (!sd.magnify))	{	// Translate mode is ON (LO is LOW, center is to the right of middle of display) AND magnify is off
		sprintf(txt, "  %u  ", (unsigned)freq_calc+(unsigned)grat);	// build string for center frequency
		i = 160-((strlen(txt)-2)*4);	// calculate position of center frequency text
		UiLcdHy28_PrintText((POS_SPECTRUM_IND_X + i),(POS_SPECTRUM_IND_Y + POS_SPECTRUM_FREQ_BAR_Y),txt,clr,Black,4);

		sprintf(txt, " %u ", (unsigned)freq_calc-(unsigned)grat);	// build string for left-of-center frequency
		c = &txt[strlen(txt)-3];  // point at 2nd character from the end
		UiLcdHy28_PrintText((POS_SPECTRUM_IND_X +  90),(POS_SPECTRUM_IND_Y + POS_SPECTRUM_FREQ_BAR_Y),c,clr,Black,4);
		//

		sprintf(txt, " %u ", (unsigned)freq_calc);	// build string for frequency in center of display
		c = &txt[strlen(txt)-3];  // point at 2nd character from the end
		UiLcdHy28_PrintText((POS_SPECTRUM_IND_X + 122),(POS_SPECTRUM_IND_Y + POS_SPECTRUM_FREQ_BAR_Y),c,clr,Black,4);
	}

	// remainder of frequency/graticule markings

	sprintf(txt, " %u ", (unsigned)freq_calc-(2*(unsigned)grat));	// build string for middle-left frequency
	c = &txt[strlen(txt)-3];  // point at 2nd character from the end
	UiLcdHy28_PrintText((POS_SPECTRUM_IND_X +  58),(POS_SPECTRUM_IND_Y + POS_SPECTRUM_FREQ_BAR_Y),c,clr,Black,4);
	//

	sprintf(txt, " %u ", (unsigned)freq_calc+(2*(unsigned)grat));	// build string for middle-right frequency
	c = &txt[strlen(txt)-3];  // point at 2nd character from the end
	UiLcdHy28_PrintText((POS_SPECTRUM_IND_X + 186),(POS_SPECTRUM_IND_Y + POS_SPECTRUM_FREQ_BAR_Y),c,clr,Black,4);

	sprintf(txt, "%u ", (unsigned)freq_calc-(4*(unsigned)grat));	// build string for left-most frequency
	c = &txt[strlen(txt)-3];  // point at 2nd character from the end
	UiLcdHy28_PrintText((POS_SPECTRUM_IND_X ),(POS_SPECTRUM_IND_Y + POS_SPECTRUM_FREQ_BAR_Y),c,clr,Black,4);
	//

	sprintf(txt, "%u ", (unsigned)freq_calc-(3*(unsigned)grat));	// build string for right of left-most frequency
	c = &txt[strlen(txt)-3];  // point at 2nd character from the end
	UiLcdHy28_PrintText((POS_SPECTRUM_IND_X +   26),(POS_SPECTRUM_IND_Y + POS_SPECTRUM_FREQ_BAR_Y),c,clr,Black,4);
	//

	sprintf(txt, " %u ", (unsigned)freq_calc+(3*(unsigned)grat));	// build string for left of far-right frequency
	c = &txt[strlen(txt)-3];  // point at 2nd character from the end
	UiLcdHy28_PrintText((POS_SPECTRUM_IND_X + 218),(POS_SPECTRUM_IND_Y + POS_SPECTRUM_FREQ_BAR_Y),c,clr,Black,4);
	//

	sprintf(txt, " %u", (unsigned)freq_calc+(4*(unsigned)grat));	// build string for far-right frequency
	c = &txt[strlen(txt)-2];  // point at 2nd character from the end
	UiLcdHy28_PrintText((POS_SPECTRUM_IND_X + 242),(POS_SPECTRUM_IND_Y + POS_SPECTRUM_FREQ_BAR_Y),c,clr,Black,4);

}

//
//*----------------------------------------------------------------------------
//* Function Name       : UiDriverCreateSpectrumScope
//* Object              : draw the spectrum scope control
//* Input Parameters    :
//* Output Parameters   :
//* Functions called    :
//*----------------------------------------------------------------------------
void UiDriverCreateSpectrumScope(void)
{
	ulong i, clr;
	char s[32];
	ulong slen;

	//
	// get grid colour of all but center line
	//
	if(ts.scope_grid_colour == SPEC_GREY)
		ts.scope_grid_colour_active = Grid;
	else if(ts.scope_grid_colour == SPEC_BLUE)
		ts.scope_grid_colour_active = Blue;
	else if(ts.scope_grid_colour == SPEC_RED)
		ts.scope_grid_colour_active = Red;
	else if(ts.scope_grid_colour == SPEC_MAGENTA)
		ts.scope_grid_colour_active = Magenta;
	else if(ts.scope_grid_colour == SPEC_GREEN)
		ts.scope_grid_colour_active = Green;
	else if(ts.scope_grid_colour == SPEC_CYAN)
		ts.scope_grid_colour_active = Cyan;
	else if(ts.scope_grid_colour == SPEC_YELLOW)
		ts.scope_grid_colour_active = Yellow;
	else if(ts.scope_grid_colour == SPEC_BLACK)
		ts.scope_grid_colour_active = Black;
	else if(ts.scope_grid_colour == SPEC_ORANGE)
		ts.scope_grid_colour_active = Orange;
	else if(ts.scope_grid_colour == SPEC_GREY2)
		ts.scope_grid_colour_active = Grey;
	else
		ts.scope_grid_colour_active = White;
	//
	//
	// Get color of center vertical line of spectrum scope
	//
	if(ts.scope_centre_grid_colour == SPEC_GREY)
		ts.scope_centre_grid_colour_active = Grid;
	else if(ts.scope_centre_grid_colour == SPEC_BLUE)
		ts.scope_centre_grid_colour_active = Blue;
	else if(ts.scope_centre_grid_colour == SPEC_RED)
		ts.scope_centre_grid_colour_active = Red;
	else if(ts.scope_centre_grid_colour == SPEC_MAGENTA)
		ts.scope_centre_grid_colour_active = Magenta;
	else if(ts.scope_centre_grid_colour == SPEC_GREEN)
		ts.scope_centre_grid_colour_active = Green;
	else if(ts.scope_centre_grid_colour == SPEC_CYAN)
		ts.scope_centre_grid_colour_active = Cyan;
	else if(ts.scope_centre_grid_colour == SPEC_YELLOW)
		ts.scope_centre_grid_colour_active = Yellow;
	else if(ts.scope_centre_grid_colour == SPEC_BLACK)
		ts.scope_centre_grid_colour_active = Black;
	else if(ts.scope_centre_grid_colour == SPEC_ORANGE)
		ts.scope_centre_grid_colour_active = Orange;
	else if(ts.scope_centre_grid_colour == SPEC_GREY2)
		ts.scope_centre_grid_colour_active = Grey;
	else
		ts.scope_centre_grid_colour_active = White;


	// Clear screen where frequency information will be under graticule
	//
	UiLcdHy28_PrintText(POS_SPECTRUM_IND_X - 2, POS_SPECTRUM_IND_Y + 60, "                                 ", Black, Black, 0);


	//
	strcpy(s, "SPECTRUM SCOPE ");
	slen = 0;	// init string length variable
	//
	switch(ts.spectrum_db_scale)	{	// convert variable to setting
		case DB_DIV_5:
			strcat(s, "(5dB/div)");
			slen = 30;	// fine-tune horizontal position (not sure why this is needed - look at this later)
			break;
		case DB_DIV_7:
			strcat(s, "(7.5dB/div)");
			slen = 24;	// fine-tune horizontal position (not sure why this is needed - look at this later)
			break;
		case DB_DIV_15:
			strcat(s, "(15dB/div)");
			slen = 28;	// fine-tune horizontal position (not sure why this is needed - look at this later)
			break;
		case DB_DIV_20:
			strcat(s, "(20dB/div)");
			slen = 28;	// fine-tune horizontal position (not sure why this is needed - look at this later)
			break;
		case S_1_DIV:
			strcat(s, "(1S-Unit/div)");
			break;
		case S_2_DIV:
			strcat(s, "(2S-Unit/div)");
			break;
		case S_3_DIV:
			strcat(s, "(3S-Unit/div)");
			break;
		case DB_DIV_10:
		default:
			strcat(s, "(10dB/div)");
			slen = 28;	// fine-tune horizontal position (not sure why this is needed - look at this later)
			break;
	}
	//
	slen += strlen(s);				// get width of entire banner string
	slen /= 2;						// scale it for half the width of the string

	// Draw top band
	for(i = 0; i < 16; i++)
		UiLcdHy28_DrawHorizLineWithGrad(POS_SPECTRUM_IND_X,(POS_SPECTRUM_IND_Y - 20 + i),POS_SPECTRUM_IND_W,COL_SPECTRUM_GRAD);

	if(!(ts.misc_flags1 & 128))	{	// Display Spectrum Scope banner if enabled

	// Top band text - middle caption
	UiLcdHy28_PrintText(			(POS_SPECTRUM_IND_X + slen),
									(POS_SPECTRUM_IND_Y - 18),
									s,
									Grey,
									RGB((COL_SPECTRUM_GRAD*2),(COL_SPECTRUM_GRAD*2),(COL_SPECTRUM_GRAD*2)),0);
	}
	else	{			// Waterfall Mode banner if that is enabled

		// Top band text - middle caption
		UiLcdHy28_PrintText(			(POS_SPECTRUM_IND_X + 68),
										(POS_SPECTRUM_IND_Y - 18),
										"WATERFALL DISPLAY",
										Grey,
										RGB((COL_SPECTRUM_GRAD*2),(COL_SPECTRUM_GRAD*2),(COL_SPECTRUM_GRAD*2)),0);
	}
	// Top band text - grid size
	//UiLcdHy28_PrintText(			(POS_SPECTRUM_IND_X +  2),
	//								(POS_SPECTRUM_IND_Y - 18),
	//								"Grid 6k",
	//								Grey,
	//								RGB((COL_SPECTRUM_GRAD),(COL_SPECTRUM_GRAD),(COL_SPECTRUM_GRAD)),4);

	// Draw control left and right border
	for(i = 0; i < 2; i++)
	{
		UiLcdHy28_DrawStraightLine(	(POS_SPECTRUM_IND_X - 2 + i),
									(POS_SPECTRUM_IND_Y - 20),
									(POS_SPECTRUM_IND_H + 12),
									LCD_DIR_VERTICAL,
//									RGB(COL_SPECTRUM_GRAD,COL_SPECTRUM_GRAD,COL_SPECTRUM_GRAD));
									ts.scope_grid_colour_active);

		UiLcdHy28_DrawStraightLine(	(POS_SPECTRUM_IND_X + POS_SPECTRUM_IND_W - 2 + i),
									(POS_SPECTRUM_IND_Y - 20),
									(POS_SPECTRUM_IND_H + 12),
									LCD_DIR_VERTICAL,
//									RGB(COL_SPECTRUM_GRAD,COL_SPECTRUM_GRAD,COL_SPECTRUM_GRAD));
									ts.scope_grid_colour_active);
	}

	// Frequency bar separator
	UiLcdHy28_DrawHorizLineWithGrad(POS_SPECTRUM_IND_X,(POS_SPECTRUM_IND_Y + POS_SPECTRUM_IND_H - 20),POS_SPECTRUM_IND_W,COL_SPECTRUM_GRAD);

	// Draw Frequency bar text
	UiDrawSpectrumScopeFrequencyBarText();


	// Horizontal grid lines
	for(i = 1; i < 4; i++)
	{
		// Save y position for repaint
		sd.horz_grid_id[i - 1] = (POS_SPECTRUM_IND_Y - 5 + i*16);

		// Draw
		UiLcdHy28_DrawStraightLine(	POS_SPECTRUM_IND_X,
									sd.horz_grid_id[i - 1],
									POS_SPECTRUM_IND_W,
									LCD_DIR_HORIZONTAL,
//									RGB((COL_SPECTRUM_GRAD),(COL_SPECTRUM_GRAD),(COL_SPECTRUM_GRAD)));
									ts.scope_grid_colour_active);
		//printf("vy: %d\n\r",sd.horz_grid_id[i - 1]);
	}

	// Vertical grid lines
	for(i = 1; i < 8; i++)		{

		// determine if we are drawing the "center" line on the spectrum  display
		if(!sd.magnify)	{
			if((ts.iq_freq_mode == FREQ_IQ_CONV_LO_LOW) && (i == 5))			// is it frequency translate RF LOW mode?  If so, shift right of center
				clr = ts.scope_centre_grid_colour_active;
			else if((ts.iq_freq_mode == FREQ_IQ_CONV_LO_HIGH) && (i == 3))		// shift left of center if RF HIGH translate mode
				clr = ts.scope_centre_grid_colour_active;
			else if ((ts.iq_freq_mode == FREQ_IQ_CONV_MODE_OFF) && (i == 4))	// center if translate mode not active
				clr = ts.scope_centre_grid_colour_active;
	        else
	     	   clr = ts.scope_grid_colour_active;								// normal color if other lines
		}
		else if(i == 4)
			clr = ts.scope_centre_grid_colour_active;
        else
     	   clr = ts.scope_grid_colour_active;								// normal color if other lines

		// Save x position for repaint
		sd.vert_grid_id[i - 1] = (POS_SPECTRUM_IND_X + 32*i + 1);

		// Draw
		UiLcdHy28_DrawStraightLine(	sd.vert_grid_id[i - 1],
									(POS_SPECTRUM_IND_Y -  4),
									(POS_SPECTRUM_IND_H - 15),
									LCD_DIR_VERTICAL,
//									RGB((COL_SPECTRUM_GRAD),(COL_SPECTRUM_GRAD),(COL_SPECTRUM_GRAD)));
									clr);

		//printf("vx: %d\n\r",sd.vert_grid_id[i - 1]);
	}

	if(ts.misc_flags1 & 128)	{	// is it in waterfall mode?
		if(!ts.waterfall_speed)			// print "disabled" in the middle of the screen if the waterfall was disabled
			UiLcdHy28_PrintText(			(POS_SPECTRUM_IND_X + 72),
												(POS_SPECTRUM_IND_Y + 18),
												"   DISABLED   ",
												Grey,
												RGB((COL_SPECTRUM_GRAD*2),(COL_SPECTRUM_GRAD*2),(COL_SPECTRUM_GRAD*2)),0);
	}
	else	{
		if(!ts.scope_speed)		// print "disabled" in the middle of the screen if the spectrum scope was disabled
		UiLcdHy28_PrintText(			(POS_SPECTRUM_IND_X + 72),
											(POS_SPECTRUM_IND_Y + 18),
											"   DISABLED   ",
											Grey,
											RGB((COL_SPECTRUM_GRAD*2),(COL_SPECTRUM_GRAD*2),(COL_SPECTRUM_GRAD*2)),0);
	}




}

//
//*----------------------------------------------------------------------------
//* Function Name       : UiDriverClearSpectrumDisplay
//* Object              : Clears the spectrum display
//* Input Parameters    :
//* Output Parameters   :
//* Functions called    :
//*----------------------------------------------------------------------------
void UiDriverClearSpectrumDisplay(void)
{
	ulong i;

	if(sd.use_spi)	{
		UiLcdHy28_DrawFullRect(POS_SPECTRUM_IND_X - 2, (POS_SPECTRUM_IND_Y - 22), 94, 264, Black);	// Clear screen under spectrum scope by drawing a single, black block (faster with SPI!)
	}
	else	{
		for(i = 0; i < 8; i++)	{
			UiLcdHy28_PrintText(POS_SPECTRUM_IND_X - 2, (POS_SPECTRUM_IND_Y - 22) + (i* 12), "                                 ", Black, Black, 0);
		}
	}
}
//
//*----------------------------------------------------------------------------
//* Function Name       : UiDriverCreateDigiPanel
//* Object              : draw the digital modes info panel
//* Input Parameters    :
//* Output Parameters   :
//* Functions called    :
//*----------------------------------------------------------------------------
/*static void UiDriverCreateDigiPanel(void)
{
	ulong i;

	// Draw top band
	for(i = 0; i < 16; i++)
		UiLcdHy28_DrawHorizLineWithGrad(POS_SPECTRUM_IND_X,(POS_SPECTRUM_IND_Y - 20 + i),POS_SPECTRUM_IND_W,COL_SPECTRUM_GRAD);

	// Top band text - middle caption
	UiLcdHy28_PrintText(			(POS_SPECTRUM_IND_X + 85),
									(POS_SPECTRUM_IND_Y - 18),
									"DIGI PANEL",
									Grey,
									RGB((COL_SPECTRUM_GRAD*2),(COL_SPECTRUM_GRAD*2),(COL_SPECTRUM_GRAD*2)),0);

	// Draw control left and right border
	for(i = 0; i < 2; i++)
	{
		UiLcdHy28_DrawStraightLine(	(POS_SPECTRUM_IND_X - 2 + i),
									(POS_SPECTRUM_IND_Y - 20),
									(POS_SPECTRUM_IND_H + 12),
									LCD_DIR_VERTICAL,
									RGB(COL_SPECTRUM_GRAD,COL_SPECTRUM_GRAD,COL_SPECTRUM_GRAD));

		UiLcdHy28_DrawStraightLine(	(POS_SPECTRUM_IND_X + POS_SPECTRUM_IND_W - 2 + i),
									(POS_SPECTRUM_IND_Y - 20),
									(POS_SPECTRUM_IND_H + 12),
									LCD_DIR_VERTICAL,
									RGB(COL_SPECTRUM_GRAD,COL_SPECTRUM_GRAD,COL_SPECTRUM_GRAD));
	}

	// Clear old spectrum part + frequency bar
	UiLcdHy28_DrawFullRect(POS_SPECTRUM_IND_X,POS_SPECTRUM_IND_Y - 4,POS_SPECTRUM_IND_H - 2,POS_SPECTRUM_IND_W - 2,Black);
}*/

//*----------------------------------------------------------------------------
//* Function Name       : UiDriverInitFrequency
//* Object              : set default values, some could be overwritten later
//* Input Parameters    :
//* Output Parameters   :
//* Functions called    :
//*----------------------------------------------------------------------------
static void UiDriverInitFrequency(void)
{
	ulong i;

	// Clear band values array
	for(i = 0; i < MAX_BANDS; i++)
	{
		band_dial_value[i] = 0xFFFFFFFF;	// clear dial values
		band_decod_mode[i] = DEMOD_USB; 	// clear decode mode
		band_filter_mode[i] = AUDIO_DEFAULT_FILTER;	// clear filter mode
	}

	// Lower bands default to LSB mode
	for(i = 0; i < 4; i++)
		band_decod_mode[i] = DEMOD_LSB;

	// Init frequency publics(set diff values so update on LCD will be done)
	df.value_old	= 0;
	df.value_new	= 0;
	df.tune_old 	= tune_bands[ts.band];
	df.tune_new 	= tune_bands[ts.band];
	df.selected_idx = 3; 		// 1 Khz startup step
	df.tuning_step	= tune_steps[df.selected_idx];
	df.update_skip	= 0;		// skip value to compensate for fast dial rotation - test!!!
	df.temp_factor	= 0;
	df.temp_enabled = 0;		// startup state of TCXO

	//if(ts.band == BAND_MODE_4)
	//	df.transv_freq = TRANSVT_FREQ_A;
	//else
//	df.transv_freq	= 0;	// LO freq, zero on HF, 42 Mhz on 4m

	//df.tx_shift		= 0;		// offcet fo tx
	df.de_detent	= 0;

	// Set virtual segments initial value (diff than zero!)
	df.dial_100_mhz	= 0;
	df.dial_010_mhz	= 1;
	df.dial_001_mhz	= 4;
	df.dial_100_khz	= 0;
	df.dial_010_khz	= 0;
	df.dial_001_khz	= 0;
	df.dial_100_hz	= 0;
	df.dial_010_hz	= 0;
	df.dial_001_hz	= 0;
}
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
