pauloalcobia/mcHF_rev_0_8/firmware/dsp/mchf_0_0_219_22_ka7oei_20150908/drivers/ui/lcd/waterfall_colours.h

// Color palattes for waterfall displays
//
// Derived with the help of:  http://www.perbang.dk/rgbgradient/
//
// NOTES:
//
//  - The waterfall palettes range from [0] = weakest signal to [63] for the strongest signal
//
//	- The last entry [64] (the 65th) is always reserved for the vertical line color.  You may include it in the table, but it will always be overwritten.
//
//  - The LCD ultimately uses a 16 bit (5,6,5) RGB pallete where there are 5 Blue, 6 Green and 5 Red bits of color resolution, produced by the macro "RGB", below
//
//
#define RGB(red,green,blue)(uint16_t)(((red>>3)<<11)|((green>>2)<<5)|(blue>> 3))
//
//
// Waterfall Gray Colors
//
const ushort waterfall_grey[]	=	{
	RGB(0x00,0x00,0x00),
	RGB(0x04,0x04,0x04),
	RGB(0x08,0x08,0x08),
	RGB(0x0c,0x0c,0x0c),
	RGB(0x10,0x10,0x10),
	RGB(0x14,0x14,0x14),
	RGB(0x18,0x18,0x18),
	RGB(0x1c,0x1c,0x1c),
	RGB(0x20,0x20,0x20),
	RGB(0x24,0x24,0x24),
	RGB(0x28,0x28,0x28),
	RGB(0x2c,0x2c,0x2c),
	RGB(0x30,0x30,0x30),
	RGB(0x34,0x34,0x34),
	RGB(0x38,0x38,0x38),
	RGB(0x3c,0x3c,0x3c),
	RGB(0x40,0x40,0x40),
	RGB(0x44,0x44,0x44),
	RGB(0x48,0x48,0x48),
	RGB(0x4c,0x4c,0x4c),
	RGB(0x50,0x50,0x50),
	RGB(0x54,0x54,0x54),
	RGB(0x59,0x59,0x59),
	RGB(0x5d,0x5d,0x5d),
	RGB(0x61,0x61,0x61),
	RGB(0x65,0x65,0x65),
	RGB(0x69,0x69,0x69),
	RGB(0x6d,0x6d,0x6d),
	RGB(0x71,0x71,0x71),
	RGB(0x75,0x75,0x75),
	RGB(0x79,0x79,0x79),
	RGB(0x7d,0x7d,0x7d),
	RGB(0x81,0x81,0x81),
	RGB(0x85,0x85,0x85),
	RGB(0x89,0x89,0x89),
	RGB(0x8d,0x8d,0x8d),
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
	RGB(0xfc,0xae,0x00),
	RGB(0xfc,0x9c,0x00),
	RGB(0xfd,0x8b,0x00),
	RGB(0xfd,0x8b,0x00),
	RGB(0xfd,0x79,0x00),
	RGB(0xfd,0x76,0x00),
	RGB(0xfd,0x56,0x00),
	RGB(0xfe,0x44,0x00),
	RGB(0xfe,0x32,0x00),
	RGB(0xfe,0x20,0x00),
	RGB(0xfe,0x0e,0x00),
	RGB(0xff,0x00,0x02),
	RGB(0xff,0xff,0xff),
};
