pauloalcobia/mcHF_rev_0_8/(commit log)

2018-06-13 added schematics and board components layout
2018-07-04 logic board mod
2018-07-18 API driver latest changes
